misdake/DigitalDesign/modeling/audited/README.md

# Audited numerical modeling

`audited` is a domain-independent fixed-point modeling tool. It has no GPU,
processor, compiler, hardware-framework or board dependency. IP models depend
on this crate; this crate never depends on an IP or a final system.

## Data boundary

`Fixed<B,F,S>` has compile-time literals but no runtime constructor, raw getter,
native arithmetic or division. Checked external integers enter an Input store
before a frame starts. Runtime values come from audited operations and typed
memory reads. Dynamic addresses and predicates preserve value provenance.
`finish()` consumes the frame before exposing host observations; `audit()`
independently replays values, control, memory and resource counts.

Numerical mode (`Model::numerical`, `compute`) records work and payload I/O
without hardware capacities or cycle estimates. Scheduled mode additionally
binds declared resources and uses an ASAP dependency schedule. Neither an audit
nor an ASAP result proves algorithm accuracy, a static RTL pipeline, area or fmax.

Products record both logical operand widths and physical lowering. Narrow
products use DSP18, wide-by-narrow products use two DSP18 operations plus a wide
reassembly adder, and wide products use DSP36. A 9-bit product is a logical
DSP18 operation; explicit target packing is checked separately. Rounding includes its
guard and increment adder. Variable right shifts truncate; RNE must be explicit.
`resize_exact` checks a contract and never implements saturation.

`floor_to` explicitly records static arithmetic rescaling and checked narrowing;
negative values round toward minus infinity. `half_up_to` records the same floor,
a static guard-bit slice and a narrow add; ties go toward positive infinity.
Neither substitutes for `round_to` (nearest-even). `Operand::format()` exposes
type metadata only, never runtime data or provenance.

## Source ownership

| File | Responsibility |
| --- | --- |
| `src/lib.rs` | Closed types, formats, faults and resource declarations |
| `src/arithmetic.rs` | Audited numerical operations and product lowering |
| `src/model.rs` | Stores, event ledger, external inputs and independent audit |
| `src/scheduling.rs` | Optional resource scheduling and timing checks |
| `src/physical.rs` | Fused provenance, DSP topology, banks, replicas, ports and collision certificates |
| `src/lifecycle.rs` | Width-weighted retained values and periodic overlap |
| `src/flow.rs` | Bounded context leases, FIFO credits, CE and ordered commit |
| `src/tests.rs` | Framework semantic and tamper regressions |
| `examples/support/triangle.rs` | Bounded mathematical driver, outside private internals |

## Validation

```powershell
& scripts/run-cargo.ps1 -Subcommand test -Label audited -CargoArgs @('-p','audited')
& scripts/run-cargo.ps1 -Subcommand run -Label audited-driver -CargoArgs @('-p','audited','--example','audited_triangle','--','target/audited/driver')
```

The triangle example is a framework regression, not a triangle setup algorithm.
All frames have event limits; scheduled frames additionally have cycle limits.

## Explicit physical and state certificates

These modules consume finished reports without exposing a runtime `Fixed`
constructor. The numerical ledger stays immutable and independently replayable.
IP adapters supply a placement and timing certificate; checks recompute legality
rather than accepting an optimizer's resource counters.

`physical::FusedGroup` currently certifies exactly `(A0*B0+A1*B1)+C` with signed
18-bit-or-smaller operands, common product fraction and a signed 54-bit-or-smaller
accumulator/result. Absorbed intermediates may not escape. Bound dependencies
preserve external operands and every control gate; a certificate with different
operands, overlapping groups or an internal escape is rejected.

`physical::LogicCone` certifies a pure-logic subgraph reachable from its declared results,
at most 64 total member events, an explicit width cap and a positive result latency.
Its sorted external operands and every control gate are preserved. Multipliers,
memory, publication and control effects cannot be absorbed; internal values must
not escape unless their event IDs are explicitly listed in `exported_events`.
Exports must be unique absorbed events; the root cannot be listed again. All
results share one ready edge, and disconnected unexported work is rejected.
Absorbed events become zero-time aliases at the result-ready edge.
`composed_dependencies`, the composed memory audits and
`lifecycle::analyze_composed_policy` combine these cones with DSP fusion, reject
overlap and account for each exported result's retained storage. Every original
numerical operation remains in the independently replayed ledger. This is a
declared circuit boundary; its width and latency do not prove a clock frequency
or its physical adder count. An IP must declare cone lanes and validate timing
through synthesis before treating the estimate as hardware evidence.

`physical::lowering::WiringAdd::prove(report, event)` binds an existing Add to
field wiring only when conservative possible-one masks do not overlap. Facts
come from full types, Literal nodes, slices, exact resizes, constant shifts and
already provable disjoint additions. All ranges must fit the result, including
sign extension and fractional alignment. Input samples never narrow a domain.
For example, two 8-bit fields placed at bits 0 and 7 overlap even when a sample
does not carry; placing them at bits 0 and 8 can be certified.

`physical::lowering::Equality::prove(report, event)` recognizes the closed
`(a < b) + (b < a) < literal(1)` graph. Operand types must match completely,
predicate/sum formats must prove the sum domain [0,1], and internal results must
not escape. Equal Literal nodes may have different value IDs; equal sampled
runtime values may not. `EqualityKind::ReduceNor` marks a same-format literal-zero
comparison; otherwise it is a bit equality comparator.

Construct `physical::lowering::Plan { wiring_adds, equalities }` and call
`resources(report)` or `counts(report)` for independently recomputed physical
work. Wiring Adds consume no adder; each equality consumes one `Compare(width)`
(also the conservative budget for NOR). Other hardware operations remain charged,
and overlapping certificates fail. The numerical report and its original counters
stay intact. `logic_cones(report, latency)` exposes equalities to the existing
composed memory/dependency/lifecycle APIs. `audit_timing` checks these dependencies
and zero-latency wiring, but does not enforce resource lanes or prove fmax; the
IP scheduler must enforce the returned resource work separately.

```rust
use audited::physical::lowering::{Equality, Plan, WiringAdd};
// report is a finished, valid numerical report; IDs identify existing events.
let plan = Plan {
    wiring_adds: vec![WiringAdd::prove(&report, packing_add_event)?],
    equalities: vec![Equality::prove(&report, equality_event)?],
};
let physical_work = plan.resources(&report)?;
let equality_cones = plan.logic_cones(&report, 1)?;
// Schedule physical_work and compose equality_cones with existing DSP bindings.
```

This does not add automatic RTL generation or multi-output regions. A retained
comparison output still prevents absorbing that comparison. Multi-output regions
need explicit retained values, output timing and lifetime accounting; callers
must not hide escapes by deleting numerical events or duplicating cones.

Shared logic can instead be split at retained values. `LogicCone::singleton`
declares one charged pure-logic event, derives its exact external operands and
width, and absorbs nothing. For LOD `h = 19 - clz`, `shift = 19 - h`, with another
consumer of `h`, use two distinct singleton cones:

```rust
use audited::physical::{LogicCone, logic_dependencies, audit_logic_dependencies};
let mut cones = plan.logic_cones(&report, 1)?;
cones.push(LogicCone::singleton(&report, h_event, 1)?);
cones.push(LogicCone::singleton(&report, shift_event, 1)?);
let dependencies = logic_dependencies(&report, &cones)?;
// Schedule all events using dependencies and plan.resources(&report).
audit_logic_dependencies(&report, &times, &cones, max_cycle)?;
plan.audit_timing(&report, &times, 1, max_cycle)?;
```

Both 18-bit subtractors remain charged once. From the CLZ result, `h` has one
declared subtractor latency and `shift` has two; this split provides no latency
reduction. Each output keeps its own readiness and downstream dependencies.
`lifecycle::analyze_composed_policy` accepts these cones unchanged and retains
both values, including uses outside the split and publications through commit.
Do not pass them as absorbed values or exclude publications to reduce storage.
Disjoint wiring proofs still have zero latency outside the singleton cones;
real adders, comparators and variable shifts retain their work and latency.
Singletons reject wiring-only events, DSPs, memory reads/writes and invalid
numerical frames. Existing overlap, control, cycle, width and escape checks
still apply. Resource lanes, register budgets and target latency remain the
caller's responsibilities; this is not a physical timing or area measurement.

`DspInventory` describes two macros per tile. A macro holds four 9x9 lanes,
two 18x18 lanes or one paired/ALU/MAC mode; different kinds cannot share it.
A 36x36 instance owns both macros of its tile. Independent pre-add and ALU modes
also reserve their sites. `audit_issues` checks widths, fixed result latency and
unit II, including wraparound and a solitary operation's next-iteration conflict.
The half-slot inventory counts actual multiplier work; macro/tile occupancy also
captures unused slots and standalone ALU/pre-add reservations. This is a
conservative target policy, not synthesis, pin routing or fmax evidence.

`MemoryLayout` maps every ROM/RAM to copies of row/bit slices. Logical bits must
be covered exactly, physical regions fit capacity, and RAM owns whole rows
(arbitrary write masks are not assumed). Each access chooses a copy and a port
per slice; a RAM write must reach every replica. Shared RW ports share their II.
ReadFirst/WriteFirst requires the same-edge observation to agree with numerical
frame order, and two same-address writes are forbidden. Logical hazards include
all earlier reads even when independent reads change order. Effects happen at
the issue edge; declared latency delays the result/acknowledgment.
BSRAM requires registered reads; SSRAM permits asynchronous zero-cycle reads.
`audit_gowin_budget` checks supported BSRAM primitive geometries and counts
SSRAM RAM16 composition. Periodic access auditing accepts read-only bodies;
mutable iterations need a future stateful numerical replay. Representative
dynamic addresses do not prove conflict freedom for every possible address.

`lifecycle::analyze_bound_policy` counts half-open live intervals by bit width,
including overlap of repeated pixels. Wiring aliases share producer storage,
literals and fusion metadata do not allocate retained results. Input rows are
captured at body time zero even when their read events are later. Selected output
ports are held through commit; diagnostic goldens can be excluded explicitly.
Context inputs marked invariant count once across the periodic stream. Total
and optional per-width budgets are enforced. This report excludes DSP internal
pipeline registers, routing/mux registers, RAM cells and FIFO/control state;
it is not the design's total FF count or a register-allocation proof.

`flow::FlowMachine` models control tokens with bounded IDs/epochs and explicit
payload-bit accounting. A tick completes a token, commits a complete FIFO head,
loads an unused context bank, then accepts a token at its issue phase. Tokens
hold a context reference until commit; stale leases and exhausted credits fail
atomically. CE=0 freezes all modeled state and phase. A maximum wall-tick count
also bounds indefinitely stalled runs. `FlowTrace::audit` replays this control
transition model; it does not execute numerical payloads or provide an independent
arithmetic oracle. Uniform values, datapath stalls and payload queues still need
an IP-specific cycle executor.

The public physical/lifecycle/flow acceptance tests live in
`ip/gpu-v2/tests/host/physical.rs`, with composed logic certificates in
`ip/gpu-v2/tests/host/logic_cones.rs`. This milestone runs `cargo test -p gpu-v2` only.

## Experience from the GPU components

The closed numerical ledger is effective at exposing hidden host arithmetic:
the frontend now derives its DMA/vertex addresses and assembles its 96-bit packets
in component-owned frames. Stage goldens remain independent; successful audit
does not prove the algorithm matches the intended equations.

Physical and state certificates are necessary alongside that ledger. Mode
packing, memory replicas/shared ports, same-address hazards, CE/context leases,
publication and retained-value accounting are implemented. They prevent many
optimistic schedules, but they still describe a declared target model. Cone
latency is not measured timing. The lighting review found a reconvergent
five-adder path misclassified as four levels: its IP adapter now independently
checks the longest primitive path when generating and auditing certificates.

The [lighting study](../../ip/gpu-v2/docs/fragment-math.md#lighting-factors) and
[frontend study](../../ip/gpu-v2/docs/geometry.md) demonstrate why increasing a
resource can have no throughput benefit: dependency chains or memory bandwidth
may dominate. Bounded list-priority/modulo search and ALAP are useful experiments;
their candidates must pass the independent physical/lifetime checks. The result
is a legal candidate, not a proof of optimality or an implemented acceptance rate.

Before large mutable BSRAM/SSRAM designs, the next required layer is a bounded
numerical cycle executor: replay actual state, dynamic addresses, collision
observations and CE/backpressure across iterations. Current periodic memory
certificates are read-only. Payload FIFOs, hardware register allocation, DSP
internal stages, mux/control/ROM costs and RTL-derived timing remain separate
work. New resource aliases or signed/mode restrictions belong in the physical
target policy and need tamper regressions, rather than loosening the numerical
value constructor. Runtime-format/WASM support is still unimplemented.
