misdake/DigitalDesign/ip/gpu-v2/README.md

# GPU v2 IP

Reusable GPU components live here. The `gpu-v2` crate depends on the generic
[`audited`](../../modeling/audited/README.md) modeling tool and has no CPU or
board-system dependency. The earlier standalone cmodel remains under the Tang
Nano system as a historical development harness; new components belong here.

See [architecture](docs/architecture.md) for component ownership and the model
directions, [lighting](docs/lighting.md) for the numerical models, independent
cycle emulator, synthesizable RTL and matched isolated PnR evidence, and
[frontend](docs/frontend.md) for the bounded Rust frontend models.
Lighting provides explicit Fast/Compact resource profiles with scalar H
normalization, fixed DSP roles and checked synchronous retained storage.
Additional system candidates compare scalar N/H, direct squares and a complete
ID FIFO at II2/II4; their area and numerical limitations are recorded together.
The [interactive WASM review](web/README.md) compares the real Rust kernels with
shared scene inputs and optional error maps.
The [triangle setup oracle](docs/triangle.md) is complete only through its first
Rust step; counted/timed and hardware directions remain future work.
The [texture models](docs/texture.md) implement oracle/counting and universal
periodic preparation connected to bounded cache/color and cycle-MC execution.
Independent numerical cycle emulation, RTL and fitted area remain future work.
The [framebuffer model](docs/framebuffer.md) provides a materialized depth/blend
oracle and bounded serial/overlapped control through the common burst port.
Its arithmetic latency is a fixture assumption; counted arithmetic and RTL
remain future work.
The [controlled pixel composition](docs/pixel-system.md) connects global16
basic/light/sample stores, ordered join and exact final to the existing double
output/ROP and actual serial cycle MC. Its branch results are external reference
stimulus; actual streaming branch execution remains future work.
The [SDRAM memory controller combination](docs/sdram-memory-controller.md) is
provided by the Gowin vendor crate through a dev dependency. Its Rust oracle
supports real data, calibrated average service and configured CPU/display loads.
The independent [scheduler](../../modeling/scheduler/README.md) supports bounded
batch planning. Target specifications and ongoing experiments remain in the local
GPU v2 design documents until their contracts have been implemented and verified.

```powershell
& scripts/run-cargo.ps1 -Subcommand test -Label gpu-v2 -CargoArgs @('-p','gpu-v2')
& scripts/run-cargo.ps1 -Subcommand clippy -Label gpu-v2-lint -CargoArgs @('-p','gpu-v2','--all-targets','--','-D','warnings')
```
