misdake/DigitalDesign/systems/cpu-v3-tang-nano-20k/tools/gpu_profiler/README.md

# GPU profiler

Read-only RTL capture, frozen pre-submit memory snapshots, bounded cold replay
and a self-contained offline viewer. Python uses the standard library. Node is needed for viewer
regressions; Icarus and the Gowin simulation library are needed only for RTL capture.
Production GPU/CPU datapaths and Device4 ABI are unchanged. The formal renderer
owns its optional software capture lease and read bridges.

The [capture bridge](/systems/cpu-v3-tang-nano-20k/docs/gpu-capture.md) owns
resource freezing, publication and the sole later submission. The separate
[board diagnostic](/systems/cpu-v3-tang-nano-20k/examples/gpu_profiler_board/README.md)
owns the button gate and TX-only transport. Remaining qualification and future
extensions are listed in [TODO.md](TODO.md).

## Commands

Run from the repository root:

```powershell
python systems/cpu-v3-tang-nano-20k/tools/gpu_profiler/profiler.py check --node node
python systems/cpu-v3-tang-nano-20k/tools/gpu_profiler/profiler.py build systems/cpu-v3-tang-nano-20k/tools/gpu_profiler/tests/fixtures/pingpong --out target/profiler-example
python systems/cpu-v3-tang-nano-20k/tools/gpu_profiler/profiler.py render path/to/profile.json --out target/profiler-view
python systems/cpu-v3-tang-nano-20k/tools/gpu_profiler/profiler.py capture path/to/manifest.json --out target/profiler-capture
python systems/cpu-v3-tang-nano-20k/tools/gpu_profiler/profiler.py build target/profiler-capture
```

Open the output directory's `profiler.html`. It embeds the data and works without
a server. The JSON and submission/command/meshlet/CPU CSVs retain integer cycles.
`render` accepts schema v2 or converts the earlier single-frame v1 JSON; it does
not need the old frozen RTL folder. Unsupported versions and invalid references
are rejected. `build --allow-partial` is diagnostic and visibly marks incomplete
captures; ordinary `build` requires a complete capture.

The small source fixture is **synthetic**, exercises A/B/A address reuse,
backend retirement tails and CPU overlap, and is not a performance measurement.
`check` runs bounded Python format/correlation and Node math/interaction tests.
No command creates ZIP archives, flashes hardware, commits or pushes.

## Frozen inputs and cold replay

`snapshot_cli.py build-manifest spec.json --out build.json` creates a content
declaration from an explicit source/export/options/catalog list. Header/range
indices are read from the single driver-owned `rcc/gpu_capture_abi.rs`; they are
not duplicated in Python. Build IDs bind logical file names, lengths and hashes;
file locations can be relocated without changing content identity.

```powershell
python systems/cpu-v3-tang-nano-20k/tools/gpu_profiler/snapshot_cli.py receive --port COM4 --seconds 180 --out target/snapshot-receive
python systems/cpu-v3-tang-nano-20k/tools/gpu_profiler/snapshot_cli.py decode path/to/uart.bin --out target/snapshot-decoded
python systems/cpu-v3-tang-nano-20k/tools/gpu_profiler/snapshot_cli.py preflight path/to/complete-attempt --build build.json --receipt receipt.json --out target/preflight.json
python systems/cpu-v3-tang-nano-20k/tools/gpu_profiler/replay.py path/to/complete-attempt --rtl path/to/fresh-export --build build.json --receipt receipt.json --out target/replay --max-cycles 2000000 --timeout 1800
python systems/cpu-v3-tang-nano-20k/tools/gpu_profiler/compare.py previous-attempt next-attempt --replay target/replay --out target/comparison.json
python systems/cpu-v3-tang-nano-20k/tools/gpu_profiler/qualify.py target/bound-board-run --out target/bound-board-run/qualification.json
```

Every attempt is independent. The decoder preserves an error report for a
truncated/corrupt attempt and can accept a subsequent complete retry; it never
combines their chunks. A complete attempt materializes `snapshot.json` and flat
`range-NNN.bin` files with lengths, CRC32 and SHA256. Replay reloads and checks
those files rather than trusting cached JSON. Command padding, objects, actual
UI, every catalog allocation, color/depth preimages and old Front must be present.
Version1 captures preimages even when the CB declares full CLEAR.

The header ID is a declaration, not a hardware self-attestation. A separate
verified programming receipt binds actual firmware and bitstream bytes. Missing
files, changed identities, unsafe filenames, inconsistent aliases or incompatible
ABIs refuse replay. The physical initialized-read guard checks every accepted
read offer, through both ordinary `take` and `read_chain_accept`, against captured
bytes or an earlier replay write. Both paths use the same address/byte-mask check.
The bounded native-MC regression exercises two128-byte GPU RO bursts, verifies
actual READ continuation and both payloads, and rejects an uncaptured successor:

```powershell
python systems/cpu-v3-tang-nano-20k/tools/gpu_profiler/tests/read_chain_guard.py --peer path/to/fresh-export/peer --out path/to/new-test-output
```

Storage layout is independent of the unchanged GPS1 wire v1, 64-word header,
range v1 and native command ABI1. Header indices remain driver-owned.
Only `(layout,command)=(1,1)` and `(2,1)` are supported. Build v2 requires a
top-level `command_abi:1`; paused RTT `(2,2)` is rejected, even when an old ABI
constants file declares command2.

| Storage | Header layout ABI | Logical pixels | Physical plane | Allocation policy |
| --- | ---: | ---: | ---: | --- |
| Row16x16, macro pitch25 | 1 | 96000 | 192000 bytes | Legacy captured extent |
| Column16x16, padded macro height16 | 2 | 96000 | 204800 bytes | 262144 bytes reserved; tail capture explicit |

Column addressing is `base + 512*((x>>4)*16+(y>>4)) + 32*(y&15) + 2*(x&15)`.
The 6400 padding words occupy the last macro row of every column; they are not a
contiguous tail. The extra57344 allocation bytes are a separate guard outside the
physical plane. Full CLEAR initializes204800 bytes, never that guard. Build v2
binds an exact layout description, the column memory map and typed resources.
Ordinary POT textures declare column macro packing with minimum512-byte mips and
16x8 cache lines. UI grid/glyph encoding is unchanged. Row build v1, descriptor
representation, input hashes and decoding remain compatible; use the archived
`--abi` source if the authoritative constants changed since capture. Old evidence
is never relabeled.

Physical plane preimages are mandatory. Build option
`capture_allocation_guards: true` additionally requires the full allocation tails;
otherwise they are not fabricated or implicitly compared. Referenced bytes must
still be captured. A FULL_CLEAR range extending into a guard is rejected. Native
writes are checked against captured writable byte masks, alongside initialized
read guards. Reports distinguish visible pixels, physical padding words and
captured guard bytes; equality includes every compared region. Physical-only
replay explicitly reports zero compared guard bytes.

New RTL exports include `layout.json` (`schema:1`, `layout_abi`, `gpu_profile`).
The exporter checks the actual generated framebuffer/texture structure, not just
an environment label. Replay rejects unknown/mixed layouts, a row texture path
with a column target, or an unbound layout declaration. Missing layout metadata
is accepted only for archived row exports. This is a structural sanity gate;
actual source hashes remain bound to build/firmware identity.

The private diagnostic preparation command accepts `--column-catalog` for a
CPU-produced directory containing `assets.json`, `renderer_assets.rs` and its
referenced resources. `assets.json.capture_layout` must match the versioned
descriptor. Entries retain `file,address,bytes,sha256` and add `kind` (`mesh`,
`texture`, `atlas`, `other`); textures also declare `layout`. Preparation checks
hashes/bounds and copies bytes; it never converts row textures. Firmware rebuilds
restore that same build-bound catalog through the existing boot-assets route.
The formal CPU producer supports both row and column profiles. The selected
catalog, capture header, replay export and qualified hardware must agree;
offline producer support alone does not qualify physical buttons or board timing.

The MC export preserves a `peer/stream-contract.json` and its original source
names. Replay validates the fixed stream profile and every peer source against
that manifest; removed bridge-parameter text is not an identity check. Old
exports without that contract are rejected rather than silently substituted.

Cold replay uses the production GPU, arbiter, streaming endpoint, registered
CL3 native return and SDRAM controller. It has explicit cycle/wall limits and
isolated, hash-checked exports. It includes no CPU/Display requests and restores
no internal warm cache, FF or BSRAM contents. The pin model has explicit functional
timing assumptions; it is not board/PVT qualification. `color.bin`/`depth.bin`
are authoritative native output; `color.png` is a viewing aid.
`*-allocation.bin` contains exactly the declared comparison extent;
`replay.json.captured_plane_bytes` distinguishes physical-only and guarded capture.
Guard writes fail rather than being hidden as off-screen data.

Offline `tests/layout_replay.py` takes explicit `--row-rtl`, `--frozen-column`,
`--column-contract` and fresh `--out` paths. It binds the frozen GPU SHA to its
contract and stages it beside the current validated CL3 peer, without changing
production sources. Default NOP preserves independently enumerated pixel patterns.
`--clear` exercises target installation/full-plane CLEAR only; `--physical-only`
omits unreferenced allocation tails. `--missing-read` and `--forbidden-write` are
guarded negatives. Bounds are180000 cycles and180 seconds. These no-triangle
fixtures and the original frozen49.5/99 CL2 scene result do not establish new
54/108 board or producer qualification.

`tests/producer_handoff.py` consumes an archived committed producer fixture with
`--fixture`, `--producer-receipt`, `--producer-commit`, `--rtl` and fresh
`--out`. Current row and column inputs use the matching canonical export directly.
The old `--row-rtl` spelling remains an alias. Only legacy column staging from a
row export requires explicit `--frozen-column`/`--column-contract`; incomplete or
ambiguous replacement requests are rejected.
It checks archived file and build hashes, the real header/ranges, catalog byte
closure and actual column origin. The generated wire is labeled host-encoded,
not UART. Its default independent oracle handles the supplied CLEAR plus fixed-grid UI
caller, including odd-row glyph packing, untouched depth and physical padding;
this default rejects DRAW. `--expect-fault
missing-read|forbidden-write` poisons a simulation mask without changing producer
bytes. Limits remain180000 cycles/180seconds. No verified programming receipt or
combined CPU/GPU source build is implied by this offline handoff check.

Both the earlier single-fixture receipt and the CPU-owned
`digitaldesign.cpu-capture-draw-delivery` v1 archive are accepted. The latter
retains one build/program per profile and `frame-0..2` occurrences; it is not
repacked into a fabricated legacy receipt. The consumer verifies every sealed
evidence file, program/build commit and digest, per-occurrence command/object
views, token/publication/slot/address, resource bytes and actual layout origin.
The producer's `observed` projection/sanity fields are not oracle inputs.

With `--oracle draw`, the same producer/input identity checks precede an independent
color/depth reference. It decodes the actual native commands, matrix, packed
meshlet and uniform color. Exact integer cross products and rational perspective
weights replace the hardware coefficient reduction/reciprocal algorithm. Depth
is camera Z in Q8.8, not far-normalized depth. ROP color uses nearest RGB565.
This deliberately restricted small-fixture path accepts at most eight triangles,
positive-Z vertices, opaque unlit shading, no blending, LESS/ALWAYS depth test
with writes, RGB attributes or a no-mip constant texture. Filtered UV is restricted
to white1x1 at zero UV. UI, lighting, clipping and unsupported sampling reject.
Both plane CLEARs must precede DRAW; overlapping depths and far-plane distances
within two D16 codes reject as ambiguous. At least256 stable covered pixels are
required, so an empty output cannot pass the DRAW handoff check.

One-pixel L-infinity bands about ideal triangle edges are excluded and counted
explicitly. All other background pixels compare exactly. Stable drawn pixels
use a declared default depth budget of two Q8.8 codes and exact RGB565; options
can tighten depth to zero or allow one RGB565 channel code for varying RGB.
Reports retain mismatch coordinates and maximum errors. These budgets describe
an independent mathematical comparison, not bit-exact RTL equivalence.
`--include-edges` compares all96000 logical pixels with no edge exclusion.
Reports distinguish the original ideal edge band from the number actually
excluded and compared. With an explicit depth CLEAR of0xffff, full-image mode
also checks exact coverage: every supported live depth is below far<200 and
therefore below0xffff. Background remains exact; the declared depth budget
only applies to mathematically covered pixels. The sequence runner accepts the
same option. A stable-region pass never silently becomes a full-image pass.

`tests/producer_sequence.py` takes three `--fixture` arguments and the same
producer/export options. It requires natural CB address A/B/A reuse, distinct
tokens/submissions and at least256 changed stable DRAW pixels on the reused
address, beyond differences attributable only to CLEAR. It independently
cold-replays each exact frozen occurrence. It does
not infer warm queue behavior or CPU/Display concurrency from isolated resets.
`tests/draw_replay.py` provides a bounded synthetic DRAW check of this plumbing,
with explicit `--layout row|column`, export options and fresh `--out` directory.
Synthetic input success never establishes real CPU producer or physical-button
qualification. Put outputs under the approved external experiment directory.

### Complete frozen scene

`tests/full_scene_replay.py` consumes the CPU-owned
`digitaldesign.cpu-capture-full-scene-delivery` v1 envelope, whose profiles live
under `full-scene/default|column16/frame-0..2`. The consumer verifies its sealed
program/build, commands, objects, UI and all range bytes without rewriting the
producer archive or using its `observed` sanity/projection fields as answers.
The same explicit export options as the single-DRAW runner apply. Cycle and
wall limits default to2000000 and1800seconds; both are explicit manifest fields
and may be overridden within replay's existing bounds.

The independent NumPy reference decodes every native DMA/state/DRAW/UI command
in order. It performs the documented Vertex output-window/normal quantization,
then direct float64 ray/triangle intersections and perspective attributes. It
does not read RTL, control ROM, T's reduced coefficients, R's traversal answers,
I's reciprocal table or CPU-provided projections. Textures come only from
captured RGB565 bytes: row8x8 or column16x16 macros and their actual mip padding.
Sampling uses the documented integer tap/Color quantizers; Lighting uses ideal
normalization and Blinn-Phong with each current global context. Final, ROP
packing and UI's binary-alpha glyph writes are independently evaluated.

This runner requires24 DRAWs:192 box triangles in six textured/unlit meshlets,
one RGB triangle,948 rabbit triangles in17 lit meshlets, and nonempty frame-time
UI. It independently checks the actual GPU trace for24 DRAW/start and VT/end
events, all command executions, UI, substantial T/quad work and completed drain.
Thus a parsed manifest, single DRAW or empty run cannot satisfy this contract.

Reports separately count full-image coverage, exact UI and nonboundary color
and depth. One-pixel ideal edge bands and two-code depth ties are marked using
the independent geometry, never DUT primitive ownership. Coverage/depth/color
deviations in excluded regions are still counted and sampled. Stable depth's
budget is two Q8.8 codes; unlit RGB permits one RGB565 channel code (whose bit
expansion can differ by nine RGB8 units). Texture and ideal-light comparison
budgets are24 and16 RGB8 units maximum, with mean at most two; these are
approximation checks, not bit-exact Lighting or arbitrary-scene guarantees.
Background and UI color remain exact. Minimum checked texture/RGB/lit pixel
counts reject vacuous comparisons. The original/actual/reference images and
counts remain available even when a budget fails.

NumPy is required only for this complete-scene path and its separate opt-in
`tests/scene_oracle_checks.py`; the basic profiler format/viewer checks remain
stdlib-only. Native GPU/MC runs still require Icarus and the existing Gowin
primitive library. Frozen CPU producer input, cold GPU execution, warm queue
concurrency, physical buttons and board qualification remain separate evidence.

The next frozen lease can expose the previous submission's actual output in its
confirmed old Front and depth preimage. `compare.py` checks adjacency, addresses,
formats, input identity and both complete output planes. An equal memory image
does not certify the HDMI link or infer whole-board GPU timing.

`qualify.py` summarizes the diagnostic run's two repeated frozen dumps, adjacent
output comparison and exact independent wire-encoder check. It reports the
accepted-START-to-drained interval separately from observed CLEAR command time.
Subtracting those intervals is accounting on that run, not a separate no-clear
render. Arrival-offset CSV records support per-attempt transfer measurements;
board dump milliseconds end when END is assembled, before its final bytes finish.

## Capture a harness

Place `// GPU_PROFILER_OBSERVER` once inside the testbench module. Supply an
explicit manifest; paths are relative to the manifest or absolute:

```json
{
  "version": 1,
  "title": "My scene",
  "clock_hz": 54000000,
  "top": "tb",
  "testbench": "tb.v",
  "sources": ["gpu-export.v", "prim_sim.v"],
  "inputs": {"program.hex": "program.hex", "assets.hex": "assets.hex"},
  "bindings": {"GPU": "gpu", "CLOCK": "clk", "RESET": "reset", "ENABLE": "ce", "CYCLE": "cycle"},
  "max_cycles": 2000000,
  "timeout_seconds": 60,
  "submissions": 3,
  "submission_labels": {
    "1": {"frame_id": 1, "name": "A"},
    "2": {"frame_id": 2, "name": "B"},
    "3": {"frame_id": 3, "name": "A reused"}
  }
}
```

List all exported source files and primitives. Source entries may instead be
`{"path": "...", "sha256": "..."}` to require a frozen identity. Every source
basename and input filename must be unique. Generated capture filenames
(`profiler_tb.v`, `capture.json`, `capture.vvp`, `compile.log`, `run.log`,
`events.txt`, `load.csv`) are reserved and rejected for sources and inputs.
Use relative filenames in testbench
`$readmemh` calls. The runner copies a snapshot into a new/empty output directory,
records source/input/observer hashes, compiles and runs there, and enforces both
cycle and wall limits. It stops after the requested number of fully drained GPU
submissions, or records a bounded incomplete stop. `--compile-only` only prepares
and compiles the snapshot. `IVERILOG_EXE` and `VVP_EXE` override executable names.

The observer binds the current GPU's hierarchy and physical T/quad/ROP ownership.
It never writes DUT state. Device4 accepted SENDs are observed independently of
CE. It does not assume a scene, meshlet count, CB base or first-completion stop.
The capture contains one monotonic counter domain; a reset during capture is
rejected and requires a new session.

Optional harness-side CPU annotations use:

```verilog
profiler_cpu_begin(17, 2, "Record next frame"); // span ID, logical frame ID, label
// CPU executes while the previous GPU submission is active.
profiler_cpu_end(17);
```

Call these on a stable testbench phase, such as the falling edge, or adapt existing
software marker observations to these tasks. IDs must be unique per session.
Labels are at most 96 bytes. CPU spans need not coincide with GPU submission
boundaries. A span still open at the explicit capture end is cropped and marked;
this permits recording frame N+1 while the last captured GPU frame N completes.
Logical frame IDs are annotations: multiple CB submissions may belong to one
frame, and a prepared frame may not yet have submitted.

## Production-GPU smoke test

This creates a fresh export, so it has no archived `target` prerequisites:

```powershell
cargo run --release -p cpu-v3-tang-nano-20k --example gpu_profiler_export -- target/profiler-rtl
python systems/cpu-v3-tang-nano-20k/tools/gpu_profiler/tests/rtl_smoke.py --rtl target/profiler-rtl --out target/profiler-smoke
```

Set `GOWIN_HOME`, or pass `--primitive path/to/prim_sim.v`. The real production GPU
executes three minimal streams A/B/A with CE0 launches and a backpressured memory
peer. CPU markers demonstrate annotation overlap; the harness does not simulate a
CPU or measure CPU performance. The limits are 20,000 cycles and 30 seconds.
The synthetic fixture additionally exercises meshlet/quad ownership and final
cache commit. These checks do not replace rendering or board validation.

## Viewer

The top overview shows green VT ownership and orange pixel-backend activity.
Backend is the per-cycle OR of raster busy, interpolator live returns, allocated
quads and ROP cache contexts, formed before time binning. Both bands include waits
and are independent of type filtering. Later dirty FLUSH maintenance has its own
detailed metric.

- Overview left-drag selects a range; drag its interior to move or edges to resize.
  Double-click outside it, right-click, or Fit session to clear. Right-drag moves.
- Wheel scrolls rows; Ctrl+wheel zooms around the pointer. Middle/right drag or
  Shift+left drag pans time and the current pane's rows.
- Types opens a collapsed popup beside Fit session; WAIT/DMA start hidden.
- Command labels show `CB ID · PC`; hover labels for that occurrence's details.
  Hover the time plot for all alive occurrences, including filtered types.
- Click selects; double-click or Focus selection zooms to its DMA/backend bounds.
- CPU spans and GPU submission intervals share the same time axis. Selection,
  dependency arrows, CSVs and ownership use occurrence IDs, never PC alone.
- Load hover reports the plotted time bin, busy fraction, queue mean/peak or event
  count/rate. Mouse controls (?) lists the principal interactions.

The versioned contract is in the
[system profiler specification](/systems/cpu-v3-tang-nano-20k/docs/gpu-profiler.md).
