misdake/DigitalDesign/systems/cpu-v3-tang-nano-20k/examples/frame_stats/docs/README.md

# Frame statistics documentation

- [Components](/systems/cpu-v3-tang-nano-20k/examples/frame_stats/docs/components.md): completed frame intervals and character formatting.
