misdake/DigitalDesign/systems/cpu-v3-tang-nano-20k/docs/cpu-v3-optimization-record.md

# CPU V3 optimization detail record

Status: append-only detail record; normally read only when investigating an old decision
Repository: `../../../`
Updated: 2026-10-09

The CPU V3 benchmark suite and runners referenced below were retired on
2026-10-24. These entries preserve historical evidence; their benchmark commands
are no longer active validation entry points.

The concise milestone index lives in [`cpu-v3-optimization.md`](cpu-v3-optimization.md). This file
preserves the former long-form roadmap, measurements, rejected alternatives, and validation notes.
New milestones add one sentence to the concise index and append their detailed evidence here; old
entries are not rewritten except to correct a factual error with an explicit superseding note.

This roadmap lives inside the CPU V3 system crate so it stays with the system it describes; it is
maintained and committed together with each milestone. Benchmark workloads and runners live in the
system crate; generated per-stage CSV and presentation artifacts remain local unless explicitly
selected for the repository. Historical numbers below record the exact release-mode emulator runs
described by each Stage.

## Milestone workflow and document lifecycle

- Keep this document permanently as the optimization history and current-state handoff.
- Before and after each milestone, update the current implementation state here so another agent can
  resume from the documented repository state.
- Include the updated roadmap in the same commit that completes each milestone.
- Never leave the current architecture, benchmark, validation, PnR, timing, or resource summary stale
  after a CPU V3 optimization.
- Scale validation to the risk of the change. Correctness-focused changes with little timing or
  resource pressure may use a smaller targeted test set, provided the completed milestone records
  what ran and what was intentionally skipped. Changes that affect timing, resource use, memory
  geometry, clocks, or clock-domain crossings still require the corresponding hardware validation.

## Current implementation progress

| Stage | State | Result | PnR evidence at 54 MHz |
| --- | --- | --- | --- |
| 0 | Complete, 2026-08-29 | Removed per-line snoop/invalidate; froze global maintenance and boot-handoff semantics. | 4 BSRAM; 55.435 / 55.958 MHz |
| 1 | Complete, 2026-08-29 | Added private 256-bit refill buffers and complete-line commit. | 4 BSRAM; 57.127 / 62.440 MHz |
| 2 | Complete, 2026-08-29 | Replaced serialized reads with one real `8 x 32-bit` SDRAM burst. | 4 BSRAM; 55.327 / 56.090 MHz |
| 3 | Complete, 2026-08-29 | Split each cache into even/odd BSRAM banks; initialization contents are split by word parity and refill drain is eight cycles. | 6 BSRAM; 54.492 / 54.261 MHz |
| 4 | Complete, 2026-08-29 | Converted both caches to two ways with invalid-way-first deterministic victim replacement. The tag comparison now precedes the data-bank read, so a hit costs one more registered cycle until Stage 5 pipelines it. | 6 BSRAM; 61.425 / 56.530 MHz |
| System consolidation | Complete, 2026-08-30 | Folded the separate CPU V3 boot, SDRAM, and display systems into one fitted `cpu_v3_system`. This changed the full-system baseline to 7 BSRAM before the Stage 5 fetch pipeline work. | Full system: 9,740 Logic; 7 BSRAM; 57.345 MHz |
| 5 | Complete, 2026-08-30 | Pipelined resident cache reads for one accepted lookup per cycle and added a four-entry, epoch-tagged instruction fetch queue. Sequential ALU throughput now approaches two cycles per instruction. | Full system: 9,974 Logic; 7 BSRAM; 61.842 MHz |
| 6 | Complete, 2026-08-30; removed after measurement | Added demand-progress-triggered, low-priority next-line I-cache prefetch with redirect cancellation, discardable in-flight refills, simulation counters, and demand-safe cancellation races; an intermediate one-entry cancel-learning fix was folded into the removal. Later audit showed ~1.5% Logic / ~4.6% FF cost for +0.0003% frozen-suite benefit, so the whole mechanism was deleted again (see the Stage 6 section). | Full system: 10,129 Logic; 7 BSRAM; 54.538 MHz (at introduction) |
| 7 | Complete, 2026-08-30 | Added cycle-profiled emulator benchmarks, a redirect fast path, and an explicit dual-read RAM16 scalar register file. Hot control-transfer fetch waits fell from four cycles to two; the RAM16 register file cut 2,178 LUTs. | Full system: 8,046 Logic; 7 BSRAM; 57.549 MHz |
| 8 | Complete, 2026-08-30 | Split the production I/D caches, added write-allocate D-cache stores, dirty eviction, eight-beat SDRAM line writes, and blocking full-cache clean/invalidate with CPU hold and final status. | Full system: 9,548 Logic; 7 BSRAM; 54.918 MHz |
| 9 | Complete, 2026-08-31 | Added an exact related-clock 54/108 MHz gearbox. Cache/arbiter line traffic is 4 x 64-bit at 54 MHz; the Controller HS and SDRAM side remains 8 x 32-bit at 108 MHz. | Full system: 10,345 Logic; 7 BSRAM; CPU 54.965 MHz |
| 10 | Complete, 2026-08-31 | Replaced XOR/way-interleaved cache storage with two parity-split DPBs per cache. Refill and D-cache write-back now transfer directly as 4 x 64-bit beats without private 256-bit cache buffers. | Full system: 9,977 Logic; 4 DPB + 1 SDPB + 2 pROM; CPU 54.692 MHz |
| 11 | Complete, 2026-09-01 | Added a one-entry asynchronous store. A scalar store retires immediately and its data-port request/response runs in the background, overlapping ALU and other non-memory instructions; later memory operations wait on the single store buffer. | Full system: 10,025 Logic; 4 DPB + 1 SDPB + 2 pROM; CPU 56.51 MHz |
| 12 | Complete, 2026-09-01 | Added a conservative two-stage frontend: single-cycle integer ALU/immediate/control instructions overlap their fetch with the preceding execute, and a registered GPR forwarding path lets back-to-back dependent instructions observe the pending write. Loads, stores with a busy buffer, branches/jumps, devices, multiply, and FPU remain barriers. | Full system: 10,100 Logic; 4 DPB + 1 SDPB + 2 pROM; CPU 56.230 MHz |
| ISA 0.8 migration | Complete, 2026-09-11 | Breaking integer ISA revision (no new numbered Stage): destructive shift/multiply family at major 2, extended/system family at major 6, device access at major 7, symmetric branch/conditional-move/jump family at major B, `IMMHI12` renamed to neutral `PFX12`, `HALT` replaced by `SIGNAL r0, 0`, majors C/E reserved. Encoding, simulators, handwritten RTL, RCC backend, debugger decoding, and boot assets switched at the same boundary. Stage0 is 461 words (fits the 1024-word boot window); integer side keeps one `MULT18X18`. | Full system: 10,436 Logic; 4 DPB + 1 SDPB + 2 pROM; 2 x MULT18X18; CPU 55.597 MHz, zero setup/hold TNS |
| Single-stage boot merge | Complete, 2026-09-12 | Folded the former Stage1 into the BSRAM first stage: one image validates the descriptor and manifest and loads the reset-selected application, so the Stage1 image, the descriptor mirroring, and the duplicate DMA/UART/handoff code disappear. Container format version 4 reserves the former Stage1 descriptor fields; the error ABI uses stage `1` throughout and the boot-progress phases collapse to BOOT/DMA/APPLICATION. A manifest section-count bound closes the 16-bit `count << 5` wrap in the size check. | Merged Stage0 673 words (fits the 1024-word BSRAM boot window). Full system: 10,269 Logic; 4 DPB + 1 SDPB + 2 pROM; 2 x MULT18X18; CPU 54.522 MHz, zero setup/hold TNS |
| `ASR`/`ASRI` signedness fix | Complete, 2026-09-12 | Found on hardware: the display demo's negative sine/cosine offsets landed at +255 instead of -1. The handwritten RTL put `>>>` inside a conditional whose other branches were unsigned, and Verilog makes a `?:` unsigned when any branch is unsigned, so `ASR`/`ASRI` (and therefore the then-current `fix16::to_int()`) shifted logically. The shifts now compute in a statement-based `case` and the FSM selects the result; `fix16_to_int_rcc` co-simulates the conversion. | Full system: 10,232 Logic; 4 DPB + 1 SDPB + 2 pROM; 2 x MULT18X18; CPU 54.747 MHz, zero setup/hold TNS |
| Stage 6 prefetch removal | Complete, 2026-09-12 | Deleted the next-line I-cache prefetch entirely (offset-10 fetch-queue trigger, request/arm/cancel and cancelled-line learning in the I-cache engine, simulation counters) after the cost/benefit audit in the Stage 6 section showed ~4.6% register and ~1.5% Logic cost for +0.0003% frozen-suite benefit. The I-cache module sheds 31 REG / 178 LUT at synthesis; system PnR shifts the rest (unrelated modules move within normal re-optimization noise). Frozen stage-12 suite: +20 cycles out of 6,136,236; prefetch metric columns remain in the CSV schema, pinned to zero. | Full system: 10,321 Logic (4,196 FF); 4 DPB + 1 SDPB + 2 pROM; 2 x MULT18X18; CPU 56.141 MHz, zero setup/hold TNS |
| Cache RAM16 valid/victim + dirty window scan | Complete, 2026-09-12 | Moved both caches' valid and victim bits from flip-flops into a `CpuV3CacheValidRam` RAM16 leaf (asynchronous read, synchronous single-way write), with a one-set-per-cycle clear for global invalidation, reset, and memory-error scrub. The D-cache exposes `valid_sweep` and the system holds the core for the reset/scrub sweep (`sysctl_cpu_hold || valid_sweep`) so the core never sees a not-ready D-cache on its first post-reset access. The two-way hit expression drops its own invalidating gate to restore the tight I-cache way-valid depth. Revision audit: only the victim bit actually inferred RAM16 here, because the valid-array write ports depended on the cache's own read data and on the request handshake; both valid ways stayed as 128 flip-flops plus read multiplexers per cache until the cache valid-array write-port fix recorded below. Replaced the D-cache 128-bit dirty priority encoder with a 16-entry window scan overlapped with the in-flight write-back; the architecture `DataCache` selects lines way-major so the RTL and Rust wrapper stay bit-exact. Frozen-suite cycles unchanged per program (post-halt flush within 3 cycles). | Full system: 9,640 Logic (8,294 LUT, 770 ALU, 96 RAM16); 4,099 FF; 4 DPB + 1 SDPB + 2 pROM; 2 x MULT18X18; CPU 54.222 MHz, zero setup/hold TNS |
| Framebuffer 400x240 | Complete, 2026-09-12 | Widened the CPU framebuffer from 320x240 to 400x240 RGB565, so the 2x-scaled 800x480 mode fills the active window with no side border and the 3x 1280x720 mode leaves 40-pixel borders. The scanout line buffer grows to three 200-word slots (two 18-Kbit BSRAMs) with 10-bit addresses; the slot-base select keeps the address math off a synthesized DSP multiplier. The display demo re-centers on x=200 and uses 8/256 radians per pixel. | Full system: 9,706 Logic (8,354 LUT, 776 ALU, 96 RAM16); 4,098 FF; 5 DPB + 2 SDPB + 1 pROM; 2 x MULT18X18; CPU 56.304 MHz, zero setup/hold TNS |
| Scanout double buffer | Complete, 2026-09-12 | Collapsed the scanout line buffer from three 200-word slots to two. At two slots the producer only requests the bus once the consumer has freed a slot, when exactly one line is buffered, so the display is arbiter-urgent (`ready_count <= 1`) for every request and never round-robins with the CPU; the single line of lead covers SDRAM refresh plus the one in-flight transaction. Two 400-pixel lines are 12800 bits and fit a single 18-Kbit BSRAM (the three-slot 19200 did not). The host model's 0-underflow blackout ceiling drops from ~9900 to ~6400 cycles, so the line-buffer test pins 6000. | Full system: 9,706 Logic (8,361 LUT, 769 ALU, 96 RAM16); 4,088 FF; 5 DPB + 1 SDPB + 1 pROM; 2 x MULT18X18; CPU 54.298 MHz, zero setup/hold TNS |
| Cache valid-array write port | Complete, 2026-09-12 | The valid/victim RAM16 leaf had only ever inferred RAM16 for the victim bit. The D-cache selected the victim write way from the array's own asynchronous read data in `ST_LOOKUP`, and the I-cache put the `memory_request_ready` handshake into the valid write enable; Gowin then mapped the leaf's two valid ways as 128 flip-flops plus read multiplexers in every instance, costing 256 FF and about 840 LUT across the two caches while the 96 system SSRAM cells stayed fully accounted for by tags, the victim bit, and the GPR/FPU files. Both caches now invalidate the victim from the registered `pending_way` as the line request starts, which still precedes the first refill data beat, so no array write depends on that array's read data; each leaf instance infers twelve RAM16 cells with no flip-flops. The `CpuV3CacheValidRam` SSRAM claim becomes twelve cells per instance and the flip-flop dirty bitmap stops claiming SSRAM. The change is RTL-mapping only: no emulator or architecture-model source changed and `system_cosim` re-verifies RTL/model equivalence cycle by cycle, so the frozen-suite cycle counts are unaffected. | Full system: 9,025 Logic (7,585 LUT, 768 ALU, 112 RAM16); 3,834 FF; 5 DPB + 1 SDPB + 1 pROM; 2 x MULT18X18; CPU 55.904 MHz, zero setup/hold TNS |
| Resolved-target BTC | Complete implementation and validation, 2026-09-13; uncommitted, no new Stage | Default four-entry, two-word fully associative BTC with exact LRU, consumption-only fill and same-cycle target replay; optional eight-entry comparison and disabled control. Per-slot current metadata replaces toggled epochs so repeated redirects cannot revive old responses. Same 22 frozen programs and metric schema. See the BTC results below. | Full system, 4 entries: 9,408 Logic (7,872 LUT, 864 ALU, 112 RAM16), 4,103 logic FF, 6,688 CLS, 54.192 MHz, 0.066 ns setup slack. 8 entries: 9,637 Logic (7,968 LUT, 997 ALU, 112 RAM16), 4,340 logic FF, 6,958 CLS, 54.226 MHz, 0.077 ns setup slack. Both: 5 DPB + 1 SDPB + 1 pROM, two MULT18X18, zero setup/hold TNS. |
| FPU v2 S7b packed special path | Complete implementation and validation, 2026-09-20; no new Stage | Recovered the 54 MHz timing failure introduced by RCP/RSQRT without changing fetch behavior. The blocking special path registers its RF operand before normalization and stores each hidden-LUT interval as unsigned 17-bit `current` plus signed 10-bit `delta`, so one synchronous read replaces the former current/next pair. Aligned table bases remove address adders; the interpolator narrows to 10x9 bits; RCP uses a 33-bit saturating scale path while RSQRT uses its bounded non-saturating shift; one context copy replaces per-stage control replication. RCP/RSQRT return to T0..T3 with bit-identical reference results. Special-path synthesis falls from 528 LUT / 64 ALU / 162 FF / 1 DSP to 290 LUT / 17 ALU / 76 FF / 1 DSP. A registered-fetch-cursor probe reached 58.239 MHz / +1.348 ns but delayed redirect continuation, so it was removed after an ablation proved the packed special path closes timing alone; the four-file overlay remains in local stash `codex/fetch-timing-overlay-58.239mhz` for S7c contingency. | Full system: 9,247 Logic (7,621 LUT, 1,146 ALU, 80 RAM16), 4,189 logic FF, 6,756 CLS; 3 SDPB + 4 DPB + 1 pROM; 2 MULT18X18 + 1 MULT36X36 + 1 MULTADDALU18X18; CPU 55.058 MHz, +0.356 ns setup slack, zero setup/hold TNS. |
| FPU v2 S7c modular SINCOS | Complete implementation and validation, 2026-09-20; no new Stage | Added blocking SINCOS without changing fetch. Range reduction now feeds signed Fa and the positive 36-bit Q0.32 constant `K=round((2/pi)*2^32)=0xA2F9836E` into the existing three-stage shared MULT36X36. Taking `(Fa*K)>>>32` is bit-exact to the former `C0/C1` two-term reducer because `K=C0*2^16+C1`; it deletes four partial products, four reused accumulator registers and the serial reducer adder chain without adding a DSP. The local MULT18X18 remains dedicated to packed-LUT interpolation, followed by the result register that cuts the BSRAM -> DSP -> add -> RF path. Mode 00 SINCOS completes in T0..T7; mode 01/10 SIN/COS suppresses the second lookup/write and completes at T6. Dense +/-2pi and full-i32 tests retain 3-LSB maximum error. Special-path synthesis is 375 LUT / 34 ALU / 125 FF / 1 DSP. | Full system: 9,430 Logic (7,786 LUT, 1,164 ALU, 80 RAM16), 4,241 logic FF, 6,847 CLS; 3 SDPB + 4 DPB + 1 pROM; 2 MULT18X18 + 1 MULT36X36 + 1 MULTADDALU18X18; CPU 54.972 MHz, +0.327 ns setup slack, zero setup/hold violations. The tightest path remains a pre-existing core GPR write-data path; no special-path data path appears in the top 25. |
| FPU v2 compiler C0 | Complete, 2026-09-21 | Replaced the architectural Q8.8 model with the two-word Q16.16 encoding/decoder and a 64-scalar-register CpuV3Sim. Builder, decoder, simulator, and RTL field extraction are locked to one encoding contract; the special-function LUT/reference moved to the architecture layer. RCC freezes the Q16.16 source/ABI surface but explicitly rejects FPU operations until C1-C3, and the retired Q8.8 IR/emission is gone. Prescale helpers expose their shift and scaled result rather than claiming exact reconstruction; ACC accumulation is documented as modulo 2^64. The parked FPU display demo remains source-only while S2 temporarily selects the existing non-FPU boot application. | No RTL or bitstream input changed, so PnR was intentionally skipped. Workspace tests 574/0, core co-sim 22/0, system co-sim 2/0; strict clippy/fmt/layer/hygiene/docs pass. |
| FPU v2 compiler C1 | Complete implementation and validation, 2026-09-21 | RCC now lowers scalar Q16.16 construction, raw-half bridges, arithmetic, unary rounding, comparisons, calls/returns, parallel moves, and F-register spills through FLD/FST while preserving the frozen F0..F63 ABI. The core now executes AUX kind-00 GPR/F-register bridges through the existing external F ports and publishes scalar CMP flags to the transient pending test at retirement. A compiled-program co-simulation covers calls, a live-across-call spill/reload, comparison/branch, conversion and raw halves; the cycle-model memory harness now returns real read data instead of zero. Vector ranges, DOT/VMULS, special functions and constant integration remain C2/C3. | Full system: 9,681 Logic (8,004 LUT, 1,197 ALU, 80 RAM16), 4,285 logic FF, 7,082 CLS; BSRAM/DSP counts unchanged; CPU 57.116 MHz, +1.010 ns setup slack, zero setup/hold violations. The tightest path remains the core state-to-GPR-write-data cone; FPU data paths are absent from the top 25. Workspace tests 579/0, core co-sim 23/0, system co-sim 2/0; strict clippy/fmt/layer/hygiene/docs pass. |
| FPU v2 compiler C2 | Complete implementation and validation, 2026-09-21 | RCC now assigns contiguous register ranges to `vec2`/`vec3`/`vec4`, including packed FPU ABI arguments/results, range spills, cycle-safe vector moves and hardware partial-overlap constraints. Constructors, lane access, component arithmetic/unary operations, VMULS broadcasts, `fdot`, and vec4 import/export lower to the two-word VECTOR/AUX ISA. A compiled vector program crosses function calls and exercises VADD, VMULS, DOTSTORE, lane extraction and FLDV/FSTV in both core and full-system co-simulation. That test exposed and fixed a shared-multiplier ownership bug: a global return-valid pulse could select the multiply operand mux while a dot product was still issuing; path-local outstanding counters now own the mux through drain. The full-system boot example was also updated to match the temporary C0-C2 S2 placeholder instead of waiting forever for the parked display demo's UART frame. Special functions remain for C3; the frozen prescale library family is revisited there. | Full system: 9,689 Logic (8,011 LUT, 1,198 ALU, 80 RAM16), 4,285 logic FF, 7,009 CLS; BSRAM/DSP counts unchanged. This placement reaches 50.407 MHz with -1.320 ns worst setup slack (2 setup paths), while hold is clean. The two failing paths are the existing core state-to-GPR-write-data cone; FPU leaf data paths are not critical (the first FPU control endpoints have +0.421/+0.449 ns). Workspace tests 590/0, core co-sim 24/0, system co-sim 2/0; strict clippy/fmt/layer/hygiene/docs pass, and the corrected full-system boot example passes. |
| FPU v2 compiler C3 special/display unit | Complete implementation and validation; prescale decision remains open, 2026-09-21 | RCC now lowers `frcp`, `frsqrt`, `fsin`, `fcos`, and dual-output `fsincos` to the existing two-word SCALAR special encodings and preserves the contiguous two-register SINCOS result. The S2 display demo is restored, migrated from signed raw Q8.8 angle words to Q16.16, and exercises compiled SINCOS, multiply, rounding, integer conversion, cached framebuffer stores, clean, and vblank publication. A 20-million-step host run rendered both waveforms, the two-colour circle, and its phase marker. No FPU constant-table opcode was added: the design table is still proposed rather than frozen, and the real demo needs no such instruction. The first three prescale helpers are expressible with existing operations, but the frozen exact `v3_distance2_gt` contract needs an un-narrowed wide-ACC comparison that the ISA does not expose; the family remains explicitly rejected pending a split/relax/ISA decision. | The generated hardware is unchanged from C2: 9,689 Logic (8,011 LUT, 1,198 ALU, 80 RAM16), 4,285 logic FF, 7,009 CLS; BSRAM/DSP counts unchanged. Placement again reaches 50.407 MHz with -1.320 ns worst setup slack (2 setup paths), hold clean. Both failing paths remain the existing core state-to-GPR-write-data cone; the first FPU control endpoints retain +0.421/+0.449 ns. Workspace tests 591/0, core co-sim 25/0, system co-sim 2/0, and the full-system boot example pass; strict clippy/fmt/layer/hygiene/docs and reproducible boot packaging pass. |
| FPU v2 post-C3 AUX address timing repair | Complete implementation and validation, 2026-09-21; no new Stage | Captures the two-word pair's AUX/FLD/FST `X` field and its GPR-read select before entering the FPU states. The GPR address now starts from local registers instead of a live `ST_FPU2_WORD1/AUX_READ/AUX_APPLY` decode, without adding a pipeline stage or changing instruction latency. This removes the 19-level state -> asynchronous GPR read -> writeback cone that failed after C2; the generated cycle model remains externally identical. | Two independent fits reproduce 9,591 Logic (7,914 LUT, 1,197 ALU, 80 RAM16), 4,286 logic FF, and 6,951 CLS: -98 Logic, +1 FF, and -58 CLS versus C3; BSRAM/DSP counts unchanged. CPU timing closes at 55.966 MHz with +0.650 ns worst setup slack and zero setup/hold violations. The old path is absent from the top 25; the limiter is fetch queue head -> core state, and the first GPR write endpoint has +1.100 ns. Workspace tests 591/0, core co-sim 25/0, system co-sim 2/0, full Icarus/system example, strict clippy/layer/hygiene/docs, reproducible boot packaging, and artifact audits pass. |
| FPU v2 compiler prescale helpers | Complete implementation and validation, 2026-09-21 | RCC now lowers `v3_length2_shift`, `v3_length2_scaled`, `v3_normalize_safe`, and the relaxed `v3_distance_gt` entirely onto existing FPU v2 instructions. The distance helper accepts an ordinary Q16.16 threshold, prescales both inputs with one extra subtraction-headroom bit, narrows the squared length once through `DOTSTORE`, approximates the scaled distance as `s * RSQRT(s)`, and compares it with `threshold >> k`. Shift, narrowing, and special-function error make the boundary intentionally approximate; this removes the proposed raw-ACC compare/read extension. | No RTL or boot-program input changed, so PnR and the frozen benchmark suite were intentionally skipped. Workspace tests 594/0, core co-sim 26/0, system co-sim 2/0; strict clippy/fmt/layer/hygiene/docs and reproducible boot packaging pass. |
| FPU v2 small-range geometry helpers | Complete implementation and validation, 2026-09-21; supersedes the prescale API above | Replaced the prescale/CLZ/high-low/dynamic-shift library with direct small-range helpers: `v3_length2` is one `DOTSTORE`, `v3_normalize` adds `RSQRT` + `VMULS`, and `v3_distance_gt` uses `VSUB`, `DOTSTORE`, `s * RSQRT(s)`, then `CMP`. Release helpers have no guards. Matching `_checked` debug helpers halt with distinct signals when length/normalize components exceed inclusive +/-104, distance inputs exceed -16384..+16383, or a distance component exceeds +/-104. No opcode or RTL was added. | No RTL or boot-program input changed, so PnR and the frozen benchmark suite were intentionally skipped. Workspace tests 598/0, core co-sim 26/0, system co-sim 2/0; strict clippy/fmt/layer/hygiene/docs and reproducible boot packaging pass. |
| FPU v2 compiler and benchmark closure | Complete, 2026-09-21; FPU v2 line closed | Migrated the ten remaining Q8.8 benchmark sources to the final Q16.16 raw-half API while preserving their real inputs, loop counts, tiers, and cycle bounds. Full-width checksums now fold both halves; transform and particle state retain all 32 bits. Raw conversion is emitted directly at each call site, avoiding helper call/return overhead inside measured loops. Exact halt values were re-frozen and all 22 workloads pass. This is an explicit suite-identity revision, so performance results before and after it are not compared. | No RTL, ISA, compiler, or boot input changed, so PnR was intentionally skipped. Final frozen-suite performance is recorded under the new fingerprint in the project ledger; workspace validation and both mandatory co-simulations pass. |
| RCC allocator, vector, and segmented application layout | Complete, 2026-09-22; suite-identity revision | Replaced the linear heap scan with four segregated best-fit free lists, immediate boundary-tag coalescing, and in-place-first realloc. The checked `u16` vector API now supports reserve, clear, shrink, zero initial capacity, and roughly 1.5x growth. Tang applications place code and data in distinct windows: code starts at offset zero; the first three 32-KiB data pages reserve 16 KiB for statics, almost 64 KiB for the current tag-limited heap, and about 16 KiB for the downward stack. The fourth logical quarter is reserved as a dynamically remappable library/device window. The old vector benchmark had treated its first OOM as success; it now completes all six rounds, so earlier measurements are not comparable. | The relocated boot applications change generated boot contents. Workspace debug/release pass 625 tests, the 22-program suite passes, core/system co-simulation passes 26/2, and the boot package is reproducible; fitted and suite ledgers are recorded post-commit. |
| ISA 0.9 paged DSEG and asynchronous D-cache line operations | Complete implementation and validation, 2026-09-22 | `DSEG0..3` independently map the four logical 16-Kword quarters; legacy `MTSR DSEG` establishes four consecutive mappings. `LCOPY` redirects the existing line write-back to another physical page, `DCLEANL` writes one dirty resident line, and `DWAIT` is their explicit completion/error boundary. Function-E selector 7 is reserved after removing `DPREFETCHL`: without refill-time hit concurrency it did not improve the measured matrix stream, while the attempted sidecar cost 303 Logic and worsened timing. RCC exposes the three retained commands. | Full system after removal: 9,779 Logic (8,081 LUT, 1,218 ALU, 80 RAM16), 4,273 logic FF, 7,043 CLS; BSRAM/DSP counts unchanged. CPU timing closes at 54.956 MHz with +0.322 ns worst setup slack and zero setup/hold TNS. The 17-level limiting path runs from core state/register selection through DSEG address formation and line-copy control to the D-cache `wb_for_maintenance` enable. Release tests pass 347/0; core/system co-simulation passes 26/2; focused D-cache RTL and full PnR pass. |
| GPU fixed-line memory bring-up | Complete implementation and validation, 2026-09-23 | Moved display into a seven-owner main arbiter, made `SharedSdramPort` a single-client adapter, changed the two framebuffer slots and scanout to 16x16 tile-linear RGB565, and added device 4 with a two-entry submit FIFO, temporary three-opcode command processor, one-line command buffer, and serial dummy tile writer. S2 alternates two aligned heap command buffers and framebuffers, cleans only the two command lines, waits for GPU retirement and vblank, then reports DDHT `0x0b`. The interface remains fixed at 4x64-bit; variable 64..128-byte transactions and the real GPU frontend/cache are later milestones. | Full system: 11,313 Logic (9,300 LUT, 1,431 ALU, 97 RAM16), 4,696 logic FF, 7,802 CLS; 3 SDPB + 4 DPB + 1 pROM and DSP counts unchanged. CPU timing closes at 55.541 MHz with +0.514 ns worst setup slack and zero setup/hold TNS; the limiter is the existing FPU SINCOS result stage. Workspace tests pass 646/0, core/system co-simulation 26/2, seven system RTL tests, boot/SystemSim closure, resource audit, and PnR pass. A 16-to-9-bit draw-counter probe reduced 59 Logic and 8 registers but perturbed placement to 52.752 MHz, so it was rejected; the retained width is the clearer timing-clean implementation. |
| GPU variable line bursts | Complete implementation and validation, 2026-09-23 | Extended the three GPU masters, main arbiter, SDRAM adapter, host memory model, and related-clock service to one through four 32-byte lines. Reads carry 4/8/12/16 64-bit beats; long writes use request acceptance for beat zero and an explicit per-beat ready thereafter. Four values are preloaded before WRITE, then one 8x64 circular gearbox overlaps 54-MHz capture with 108-MHz 32-bit playback, avoiding a complete-request buffer in both adapter and wrapper. Requests cannot cross a 1-KiB SDRAM row. The current dummy GPU remains one-line, so this is an interface/performance foundation for the frontend and framebuffer cache rather than a demo behavior change. | Full system: 11,445 Logic (9,425 LUT, 1,438 ALU, 97 RAM16), 4,936 logic FF, 8,050 CLS; BSRAM and DSP counts unchanged. CPU timing closes at 54.730 MHz with +0.247 ns worst setup slack; the limiter is the existing fetch-queue metadata path. The first gearbox/controller path closes 108 MHz with +1.260 ns slack. Variable gearbox RTL, adapter RTL, crate tests, CPU/core system co-sim, full-top elaboration, and PnR pass; the known S1 Flash simulation failure remains independent. |
| Generic device watch-change wait | Complete implementation and validation, 2026-09-23 | Added a two-write system-control watch ABI and a registered read probe that holds only CPU retirement until a selected 16-bit device channel changes. GPU completion and display vblank in the dummy demo now sleep instead of polling. The architecture simulator advances autonomous target devices under the same hold contract, including the read-to-arm race. A single physical `cpu_hold` register plus a watch discriminator keeps cache-maintenance and watch completion independent without adding a hold mux on the CPU path. | Full system: 11,560 Logic (9,522 LUT, 1,456 ALU, 97 RAM16), 4,961 logic FF, 8,072 CLS; +115 Logic and +25 logic FF versus `6da2bec`, with BSRAM/DSP unchanged. System control itself is 65 LUT + 16 ALU + 67 registers; the 16 ALU are the exact 16-bit change comparator. CPU timing closes at 54.720 MHz with +0.244 ns slack. The actual critical path remains core state through D-cache control, not the watcher or device-read mux. |
| GPU blocking tile framebuffer cache | Complete implementation and validation, 2026-09-23 | Replaced direct dummy writes with an eight-entry direct-mapped 16x16 RGB565 tile cache. Temporary three-qword draws fetch aligned `u16` tile lists, execute LOAD or CLEAR plus a row-masked color write, clean dirty victims with four 128-byte writes, and drain all dirty entries before publishing completion. The system now connects the GPU framebuffer-read master. Small command/list/payload arrays omit unnecessary reset writes so they infer RAM16; the 512x64 tile store fits as two BSRAM blocks. A standalone bounded GPU runner produces a decoded PPM without booting the CPU. Full-top simulation exposed and fixed the adapter's refresh/request collision by accepting the already-advertised request before servicing the overdue refresh. | Full system: 12,587 Logic (10,427 LUT, 1,536 ALU, 104 RAM16), 5,309 logic FF, 8,603 CLS; 5 SDPB + 4 DPB + 1 pROM, DSP unchanged. CPU timing closes at 54.562 MHz with +0.191 ns slack; the limiting path is core state to GPR write data, not the GPU or cache. Controller timing closes at 122.284 MHz. Focused Rust/RTL cache tests, S2 full-top GPU/UART flow, co-sim, resource audit, and PnR pass; the pre-existing S1 full-top load assertion remains separate, and physical-board evidence is pending. |
| GPU memory-path resource repair | Complete implementation and validation, 2026-09-23 | Replaced the 8x64 long-write gearbox ring with one 64-bit holding register. The 54-MHz adapter preloads one pair, phase-aligns Controller HS commands, then advances the framebuffer-cache source on each high-half sampling edge; a 128-byte write remains in its cache entry and has no transaction write buffer. The cache valid/victim leaf now instantiates twelve `RAM16SDP1` cells explicitly for synthesis, preventing the D-cache instance from context-sensitively expanding into 128 FF plus read muxes. The audit also corrected the GPU leaf's pre-existing RAM16 claim from 24 to the fitted 32 cells. Display's 4x64 response staging is unchanged system-wide: it moved from the old shared display/CPU adapter into the display when scanout became a direct 64-bit arbiter client, because the existing line-buffer BSRAM still writes 32 bits at a time. | Full system: 11,744 Logic (9,530 LUT, 1,542 ALU, 112 RAM16), 4,731 logic FF, 7,981 CLS; BSRAM/DSP unchanged. The gearbox is 71 registers, 46 LUT and 5 ALU with no RAM16; D-cache valid/victim is 12 RAM16, 0 FF and 29 LUT. CPU timing closes at 54.237 MHz with +0.081 ns setup slack; Controller HS closes at 162.749 MHz. Focused cache/gearbox/adapter/GPU RTL tests, core co-sim 26/0, system co-sim 2/0, resource audit, and PnR pass. |

Starting with System consolidation, PnR evidence is always taken from the complete `cpu_v3_system`
containing the CPU, boot path, SDRAM controller, and display path. Every subsequent completed stage
must record the Gowin PnR report's total `Logic` count alongside BSRAM use and Fmax. `Logic` is the
vendor report's aggregate logic-unit metric, not merely its LUT subtotal. The consolidation and Stage
5 counts above were reproduced from full-system builds at commits `3f62078` and `df4774a`; Stage 6
and Stage 7 use their corresponding full-system milestone builds. Stage 11 changed only the CPU store
path, and its full-system build closes the 54 MHz CPU clock at 56.51 MHz. Stage 12's full-system build
(commit `dabcb10`) closes the 54 MHz CPU clock at 56.230 MHz; the forward-compare/operand-mux/ALU/
registered-writeback bypass and the Execute-cycle request/response mux cost a little timing over
Stage 11, but the build still reports zero setup and hold TNS on every clock.

The ISA 0.8 migration is deliberately not a numbered Stage: it is an architectural revision, not a
microarchitecture optimization. Its recorded numbers come from the post-migration full-system Gowin
build (`validate-hardware.ps1 -Mode all`, worktree after commit `b43ce4e`): 10,436 Logic (51% of the
fitted device), unchanged memory geometry (4 DPB + 1 SDPB + 2 pROM = 7 BSRAM blocks), and 55.597 MHz
on the 54 MHz CPU clock with zero setup/hold TNS on every clock. Integer DSP use stays at one
`MULT18X18` (the FPU keeps its own); the destructive multiply windows select [15:0]/[23:8]/[31:16]
from the same single multiplier through a constant-indexed part-select. Boot assets regenerated from
the same RCC sources: Stage0 461 words, Stage1 555 words, S1 application 79 words, S2 application
736 words; the Stage0 FNV-1a baseline is re-pinned in `build.rs`. A fresh run of the frozen
benchmark suite under the new ISA is reported separately, not folded into the Stage-to-Stage table.
The later single-stage boot merge (see the table) supersedes that asset set: the board now carries
one 673-word first stage and no Stage1 binary, and the FNV-1a baseline is re-pinned again.

The cache valid/victim RAM16 change and the D-cache dirty window scan are likewise not numbered
Stages. Their recorded numbers come from the full-system Gowin build after commit `148e63a`: 9,640
Logic (8,294 LUT, 770 ALU, 96 RAM16), 4,099 registers, unchanged BSRAM geometry (4 DPB + 1 SDPB + 2
pROM) and two `MULT18X18`, and 54.222 MHz on the 54 MHz CPU clock with zero setup/hold TNS. This
closure is narrow and dominated by core placement: the tightest path is the core's registered GPR
write, and the RAM16 leaves and the maintenance scan are not on it. Against the immediately
preceding build (`a956ca5`, before the scan) the 16-entry window scan removes 282 LUT; against the
pre-RAM16 `08bcc79` build the whole change removes 681 Logic and 97 registers at the cost of eight
RAM16 cells. The frozen suite reports identical per-program cycles, with the post-halt flush varying by at
most three cycles.

## Ordered major tasks

0. Remove the unused per-line snoop/invalidate direction now, freeze the global maintenance ABI and software ownership contract, and put I-cache invalidate immediately before the final boot jump.
1. Add one private 256-bit refill buffer between each cache and DRAM.
2. Change cache-line refill, the arbiter, and the SDRAM adapter to one real `8 x 32-bit` burst.
3. Change each I-cache and D-cache to two BSRAM blocks split by even and odd words, doubling internal bandwidth.
4. Change each I-cache and D-cache to two ways, including two tag lookups and a deterministic replacement policy.
5. Pipeline the I-cache hit path and add a small instruction fetch queue in front of the CPU.
6. Add low-priority next-line I-cache prefetch, reusing the 256-bit refill path.
7. Profile representative workloads and shorten control-flow redirect recovery without branch prediction.
8. Change D-cache to write-back and implement dirty eviction plus global clean/invalidate maintenance in the same change.
9. Run DRAM at exactly twice the CPU frequency through a related-clock 2:1 gearbox while keeping the rest of the system at 54 MHz.
10. Convert each cache's two data BSRAMs to true-dual-port parity banks and transfer cache lines directly as four 64-bit beats.
11. Let one scalar store complete asynchronously in the background while non-memory instructions continue to execute.
12. Overlap single-cycle integer execute with the next fetch through a conservative two-stage frontend and a single registered GPR writeback forwarding path.

Stages 0 through 12 are complete. Preserve the historical ordering above when interpreting old
measurements, and add future optimizations as separate numbered milestones rather than rewriting the
meaning of a completed Stage.

## Architectural decisions

- A cache line remains public and fixed at 16 physical 16-bit words, or 32 bytes.
- The cache/arbiter view of one line is four ordered 64-bit beats at 54 MHz; the physical controller view is eight ordered 32-bit beats at 108 MHz.
- I-cache and D-cache contain no private complete-line refill or write-back buffer.
- The current caches are two-way and use two true-dual-port parity BSRAMs per cache; Stage 10 removed
  the temporary complete-line refill and write-back buffers.
- CPU and controller clocks are exact related PLL outputs. The fixed 2:1 board gearbox is the width and clock boundary; it is not an arbitrary-ratio asynchronous FIFO.
- Two-way associativity, two-BSRAM banking, fetch pipelining, next-line prefetch, and write-back are separate milestones.
- The sixteen scalar registers are an explicit `CpuV3GprRam` module: synchronous-write,
  dual-asynchronous-read distributed RAM. Its synchronous write port commits one cycle after the
  retire; the Rust emulator models that delay exactly, and the Stage 12 forwarding mux exposes a
  matching pending write to a back-to-back dependent instruction.

## Historical stage records

Each Stage section below is a historical record: it describes the design, the measurements, and the
repository state at the time that Stage was implemented, not the current architecture. Where a Stage
section disagrees with the current-state sections above, the current-state sections take precedence.

Stale-measurement notice: the system co-simulation suite commit exposed and fixed a
D-cache emulator timing drift — the Rust model inserted an 8-cycle read drain and an 8-cycle
write-back capture that the RTL never had. Emulator-side measurements in the Stage 8 through
Stage 12 sections (store-miss refill latency, dirty eviction/write-back latency, post-halt flush
cycles, and total cycles of D-cache-miss-heavy workloads) were recorded with the old model and are
inflated. RTL and hardware behavior were always correct. Do not mix these pre-fix latency figures
with post-fix numbers in the same comparison; the affected Stages have been rerun
with the corrected model through `benchmarks/run-history.ps1` (rows marked `reconstructed`).

## Stage 0: remove dead coherence machinery and freeze the final contract

Do this while D-cache is still write-through. It is a small deletion and contract change, not an
early implementation of write-back maintenance.

Audited state at the time, at branch `code-v0.3-dev`, commit `5775bf3`:

- The architecture and RTL caches are direct-mapped, write-through, and no-write-allocate.
- There are no dirty bits, write-back states, clean states, or maintenance busy/completion states.
- `snoop_write_valid` and `snoop_write_address` are not driven by any production system; every system
  cache instance ties them to zero. Only the cache model/RTL and a local test exercise them.
- The Rust transaction model still exposes `invalidate_line`, but no production ownership path uses it.
- Device 0 channels 0 and 1 already perform whole-I-cache and whole-D-cache invalidation.
- Stage0 and Stage1 already use those whole-cache operations at their final handoff.
- `SharedBufferOwner` already models software ownership and requires accelerator DRAM writes to finish
  before CPU reacquisition; it does not implement hardware coherence.

Stage 0 changes:

- Remove `snoop_write_valid` and `snoop_write_address` from the cache Rust interface, generated RTL,
  Verilog template, all tied-zero instances, and tests.
- Remove `invalidate_line` and its DMA/per-line test from the architecture model.
- Keep only full-cache invalidation in the current write-through cache.
- Reserve semantic ABI names for future `ICACHE_INVALIDATE_ALL_DELAYED`, `D_CLEAN_ALL`,
  `D_INVALIDATE_ALL`, and final success/error status. Do not implement a fake clean scanner before
  dirty state exists.
- Define `D_INVALIDATE_ALL` as a cheap valid-bit clear while D-cache is write-through. When Stage 8
  introduces dirty state, the same architectural operation becomes clean-plus-invalidate and holds
  the CPU until all dirty writes finish.
- Expose semantic cache APIs rather than raw public maintenance-channel sends. The compiler/runtime
  boundary must treat them as memory and control barriers.
- Rename ownership predicates from vague store completion to DRAM visibility or clean completion so
  their meaning remains correct after write-back.

Add a non-returning CPU V3 intrinsic with semantics equivalent to:

```text
icache_invalidate_delayed_and_jump(cseg, target) -> !
```

Represent it as one terminal compiler IR operation. Lower it to two adjacent machine words in this
exact order:

```text
DEVSEND ICACHE_INVALIDATE_ALL_DELAYED
JSEG cseg, target
```

It cannot lower as `JSEG; DEVSEND`, because CPU V3 has no jump delay slot and the second word would
never execute. The semantic operation is atomic from software's point of view even though the encoded
invalidate command precedes the jump. No optimizer, register-allocation spill, helper call, or ordinary
instruction may be inserted between the two words.

Change the canonical boot tail now to this shape:

```text
dcache_invalidate_all()      currently one-cycle because write-through
prepare final DSEG/registers
icache_invalidate_delayed_and_jump(cseg, target) -> !
```

After Stage 8, the helper waits for `D_INVALIDATE_ALL` completion before preparing the final redirect;
the intrinsic's final `ICACHE_INVALIDATE_ALL_DELAYED; JSEG` adjacency remains unchanged.

Do not hard-code system-control device/channel decoding into the generic CPU execute state merely to
create the delay. Keep the system-control invalidate output registered and feed that architectural
pulse to both I-cache and the instruction fetch frontend. When fetch pipelining is added, the frontend
uses the pulse to discard queued and outstanding old-path words (now using per-slot current bits). This preserves
the existing generic device bus while giving the intrinsic deterministic behavior.

Stage 0 acceptance:

- A repository search finds no cache snoop ports, per-line invalidation API, or tied-zero snoop wiring.
- Both full-cache invalidations still pass model and RTL tests.
- Stage0 and Stage1 boot tests prove the canonical I-cache-invalidate/final-jump adjacency.
- Existing DMA boot and display tests remain valid under the explicit ownership model.
- BSRAM use and timing do not regress.

## Stage 1: private 256-bit refill buffers

Each cache adds storage equivalent to:

```text
refill_buffer[0:7] : 32 bits per entry
refill_beat        : 0..7
drain_word         : 0..15
refill_error       : one sticky bit
```

Target miss flow:

```text
CPU miss
  -> cache issues one aligned line request
  -> DRAM returns eight ordered 32-bit beats
  -> cache captures all beats in its private 256-bit buffer
  -> arbiter releases the DRAM owner after the physical last beat
  -> cache privately drains sixteen 16-bit words into its existing BSRAM
  -> tag and valid state commit only after a complete error-free line
  -> original CPU request receives its response
```

The low half of beat `n` is cache word `2*n`; the high half is word `2*n+1`.
An error or invalidate must never expose a partially installed line.

Suggested cache states:

```text
IDLE
CHECK
WORD_REQUEST
WORD_RESPONSE
LINE_REQUEST
LINE_RECEIVE
LINE_DRAIN
CPU_RESPONSE
```

Writes remain word transactions during this stage. Read misses use line transactions.

## Stage 2: real SDRAM burst refill

- Replace sixteen independent 16-bit read commands with one aligned cache-line command.
- Return exactly eight 32-bit response beats with explicit `valid`, `ready`, `last`, and `error` semantics.
- Hold arbiter ownership through the physical last-beat handshake, not through the private BSRAM drain.
- Define behavior under refresh and backpressure; beats must remain ordered and stable while stalled.
- Preserve display/GPU deadline traffic and prevent speculative traffic from blocking demand requests indefinitely.

Acceptance:

- One cold read miss produces exactly one line command and exactly eight accepted beats.
- No cache issues sixteen word-read commands for a line refill.
- A second client may acquire the arbiter after beat seven even while the first cache drains its buffer.
- Error injection leaves the destination cache line invalid.
- I-cache and D-cache can independently hold one completed or in-progress refill.

## Stage 3: two parity-split BSRAM blocks per cache

Use two physical BSRAM blocks per cache:

```text
even bank: words 0, 2, 4, ... 14
odd bank:  words 1, 3, 5, ... 15
```

For the later two-way geometry, each bank address is conceptually:

```text
{ way, set[5:0], pair_index[2:0] }
```

This is exactly `2 ways x 64 sets x 8 entries = 1024` addresses per bank. A 32-bit refill beat can write its even and odd halves in the same cycle, reducing the private drain from sixteen cycles to eight.

Do not claim that two 50 MHz 16-bit banks directly absorb the full output of a 100 MHz 32-bit DRAM interface: they sink 32 bits per CPU cycle while DRAM can produce the equivalent of 64 bits per CPU cycle. The refill FIFO remains necessary.

## Stage 4: two-way caches

- Keep 64 sets and 16 words per line; capacity becomes 4 KiB per cache.
- Read both ways for the selected parity bank and compare both tags.
- Define one victim bit per set or another deterministic low-cost replacement rule.
- Use the victim bit as the next replacement way; after a successful refill it points to the other way. Hits do not update it.
- Prefer invalid ways before evicting a valid way.
- For D-cache write-back, dirty state is a later stage, not part of the first two-way conversion.
- Validate same-set alternating lines, invalid-way preference, replacement, invalidate, and refill failure.

## Stage 5: pipelined I-cache hit path and instruction fetch queue

This stage removes fixed hit latency. It is distinct from line prefetch.

Stage 4 hit timing for a simple ALU instruction was:

```text
cycle 1: FETCH_REQUEST
cycle 2: I-cache synchronous BSRAM lookup and tag check
cycle 3: registered cache response and instruction latch
cycle 4: EXECUTE and retire
```

That implementation retired one simple instruction per four cycles when every access hit. The
completed Stage 5 frontend removes the fixed per-word request/response bubble while retaining the
blocking execute machine.

Target organization:

- Make the I-cache hit interface pipelined: accept one lookup address per cycle when no miss, invalidate, or structural conflict prevents it.
- Return the corresponding word and hit/miss result with an explicit registered request tag or address.
- Add a two-to-four-entry instruction fetch queue between I-cache and the CPU core; start with four entries unless PnR shows a reason to reduce it.
- Let the fetch frontend request sequential physical word addresses while queue space exists.
- Let the core pop a queued instruction without performing the old request/response round trip for every word.
- Keep execution in order and allow at most one architectural instruction to retire per cycle; this task is not a full execute pipeline.
- A taken branch, `JALR`, code-segment change, fault, reset, or I-cache invalidate flushes all queued words and restarts fetch from the resolved physical PC.
- Attach an epoch/generation bit to outstanding fetch responses so a late response from a flushed path is discarded.
- On an I-cache miss, preserve the miss address, stop speculative issue as needed, refill the line, and resume without duplicating or skipping a word.
- Prefix words must retain exact architectural ordering with their consumer.

Initial performance target:

```text
simple sequential hit stream: no old per-word cache request/response bubble
conservative core target:      at most one queue-pop cycle plus one execute cycle
expected simple throughput:    approach one instruction per two cycles before a full execute pipeline
```

Do not set a one-instruction-per-cycle acceptance target until register dependencies, forwarding, branch resolution, and execute-stage pipelining are designed explicitly.

Acceptance:

- Sequential I-cache hits can be issued on consecutive cycles and returned in order.
- The fetch queue never overflows or underflows silently under response backpressure.
- Taken branches and code-segment changes execute no stale queued instruction.
- Invalidate during an outstanding lookup or refill cannot make a stale instruction architectural.
- Prefix/consumer tests, branches, boot handoffs, and fault PCs remain bit-exact.
- A cycle-count test demonstrates that a sequential simple-ALU loop improves from the current four-cycle baseline.
- PnR confirms that the pipelined tag/data/mux path meets the selected CPU clock.

## Stage 6: low-priority next-line prefetch — REMOVED after measurement

Stage 6 added a demand-progress-triggered, low-priority next-line I-cache prefetch:

- Trigger a candidate next-line request from real CPU fetch progress near the end of a line.
- Never recursively trigger another prefetch merely because a prefetched line completed.
- Give demand I-cache misses, D-cache traffic, display deadlines, and GPU demand traffic priority over prefetch.
- Reuse the I-cache 256-bit refill path when it is idle.
- Cancel an unissued prefetch immediately; an unavoidable in-flight burst may complete, but its result must be discardable.
- Track `issued`, `useful`, `useless`, and `dropped` counters in simulation or debug builds.

A frozen-suite regression then exposed one violation of the strictly-low-priority rule: in small
fully-cached loops the offset-10 trigger fired just before the loop's backward branch, and once
the prefetch burst was committed it could not be aborted (the shared SDRAM port protocol has no
cancel), so the redirect's own demand fetch — even a cache hit — stalled about seven cycles behind
the draining dead burst, every iteration. The fix (later folded into the removal) was one-entry negative
learning in the two-way cache: a prefetch dropped by `prefetch_cancel` recorded its line address,
and a later request for the same line was dropped at the port without issuing. In the frozen
stage-12 suite this recovered 6.8% of cycles on fpu-short-sincos and 4.7% on fpu-short-splat with
zero cycle change in every other program.

**Removal.** A later cost/benefit audit of the fitted design counted the prefetch-only logic at
roughly 196 flip-flops (~4.6% of the system's 4,229 logic registers, dominated by the 128
`way_*_prefetched` bits) and ~120-180 LUTs (~1.5% of 10,232 Logic), while the frozen stage-12
suite showed the mechanism was nearly inert: 16 issued and 12 useful prefetches across all 22
programs, and disabling it at the emulator cost +20 cycles out of 6,136,236 (+0.0003%). The
entire mechanism — the offset-10 trigger in the fetch queue, the prefetch request/arm/cancel and
cancelled-line learning logic in the I-cache engine, and the simulation counters — was therefore
deleted from the RTL and every bit-exact model. The demand refill path, the fetch queue itself,
and the two-way replacement are unchanged; the suite's prefetch metric columns are retained in
the CSV schema, pinned to zero.

## Stage 7: profiled control-flow redirect fast path

- Add bounded full-system emulator benchmarks for recursive quicksort, control-flow-heavy code, and
  cached data traffic, with cycle categories, cache/SDRAM counters, opcode counts, and redirect waits.
- Generate text summaries and per-redirect CSV traces for bounded benchmark analysis.
- Issue a redirect target request in the restart cycle when request metadata capacity is available.
- Tag that request with the new fetch epoch so old-path responses remain discardable.
- When the queue is empty, fall through a matching response directly to a ready core; if the core is
  backpressured, enqueue the response normally instead of dropping it.
- Preserve the existing bounded metadata FIFO behavior when an old-path response and redirect happen
  together. Do not add branch prediction or architectural delay slots in this stage.
- Promote the sixteen scalar registers from inferred cells to an explicit dual-asynchronous-read
  `CpuV3GprRam` distributed-RAM module, and model its one-cycle synchronous write commit in the Rust
  emulator.

Stage 7 validation used emulator/RTL cycle-by-cycle co-simulation, bounded Verilog regressions for
redirect issue, fall-through, backpressure, and stale epochs, the complete Icarus hardware suite, the
two-stage boot testbench, and a full Gowin rebuild plus current-artifact audit. The fitted system used
8,046 Logic units: 7 BSRAM, 88 RAM16 leaves, 6,749 LUTs, 769 ALUs, and 3,422 logic flip-flops. The
54 MHz SDRAM/CPU clock closed at 57.549 MHz with zero setup and hold violations.

The checksum-protected quicksort retired 708,531 words in 2,467,577 cycles (3.483 cycles per retired
word), saving 184,500 cycles, or 6.96%, from the Stage 6 baseline. Of 92,249 redirects, 92,244 hot
redirects waited exactly two cycles instead of four; the remaining five included cold I-cache misses.
The trace attributed 35.09% of all cycles to the data request/response path and 7.48% to fetch waits.
Its D-cache observed 152,482 loads, 44,457 write-through stores, and only 315 line refills, making
write-through store latency the next dominant optimization target. The full quicksort test runs in
release mode and is explicitly ignored by ordinary debug test runs.

The scalar register file was promoted from inferred cells to an explicit `CpuV3GprRam` module
(synchronous-write, dual-asynchronous-read distributed RAM), cutting 2,178 LUTs and 236 logic
flip-flops while adding eight RAM16 leaves and raising Fmax from 57.293 to 57.549 MHz. The FPU
register-file SSRAM claim dropped its `+8` inferred-cell fudge in favor of a precise split. The GPR
RAM's synchronous write port commits one cycle after the retire; the Rust emulator stages a
`gpr_write_enable`/`gpr_write_address`/`gpr_write_data` request and applies it at the start of the
next clock, matching the RTL exactly. The `sequential_alu_stream_reaches_two_cycle_throughput`
regression confirms the two-cycle-per-instruction target is unchanged, and a bounded
`verify_gpr_ram_with_iverilog` test covers the register file directly.

## Stage 8: D-cache write-back and global maintenance engine

- Add dirty state per way and set.
- Evict a dirty victim before overwriting its data or tag.
- Complete write-back before installing the replacement line.
- Define error behavior so neither old nor new data is falsely reported valid.
- Keep device and uncached accesses outside normal cache allocation.
- Reuse the private 256-bit line buffer for dirty eviction and maintenance write-back where practical.
- A global clean engine scans all sets and ways, writes one dirty line at a time, and blocks new D-cache requests until it finishes.

Implement write-back and its complete global maintenance engine in this same stage. Expose only:

```text
ICACHE_INVALIDATE_ALL_DELAYED  one cycle later, invalidate every I-cache way and flush fetch
D_CLEAN_ALL                  write every dirty D-cache line, then leave lines valid and clean
D_INVALIDATE_ALL             write every dirty D-cache line, then invalidate every D-cache way
CACHE_MAINTENANCE_HOLD       internal CPU hold, asserted from command acceptance through completion
CACHE_MAINTENANCE_STATUS     final success or DRAM error
```

`D_INVALIDATE_ALL` is architecturally clean-plus-invalidate. Do not expose an unsafe command that
silently discards dirty data. D-cache clean and invalidate are variable-latency operations and are not
complete until every accepted DRAM write-back has completed successfully. Implementing these states
together with dirty eviction prevents a temporary range/snoop protection design from being built and
then removed.

Expose CPU-blocking intrinsic-like APIs:

```text
dcache_clean_all()      -> maintenance status
dcache_invalidate_all() -> maintenance status
```

Each operation sends one command. Command acceptance asserts `CACHE_MAINTENANCE_HOLD` before any later
instruction can retire. The CPU preserves its architectural state while held; I-cache, D-cache,
arbiter, and DRAM clocks continue. Hold is released only after the final required DRAM response, then
the intrinsic returns success or the recorded error from `CACHE_MAINTENANCE_STATUS`.

Do not physically gate the shared clock and do not implement a software polling loop. Give the CPU
core/fetch frontend an explicit synchronous hold input with priority over normal state transitions.
The core need not decode system-control device numbers: the system controller owns command decoding
and drives the generic hold. The D-cache also rejects CPU data requests while maintenance is active.

The intrinsic is a full compiler memory barrier: prior stores cannot move after the command and
subsequent cached accesses cannot move before hold is released. Do not expose a raw asynchronous start
API in the first revision. The write-back engine releases DRAM arbitration between bounded line bursts
so unrelated mandatory memory clients are not starved.

### Implementation decisions (2026-08-30)

- Split the I-cache and D-cache into separate modules. The I-cache becomes read-only: it drops the
  CPU-side write port, the write-through store path, and the `cpu_write`/`cpu_write_data` inputs. The
  D-cache gains write-back, dirty eviction, and the maintenance engine.
- Dirty state lives in a separate 128-bit SSRAM (two 64-bit words, one bit per way per set), not in the
  tag RAM. The maintenance scan uses a find-first-set / priority encoder over the dirty word, so the
  next dirty line is located in one cycle instead of scanning one set per cycle.
- Write-back and maintenance reuse the private 256-bit line buffer: the dirty/victim line is read from
  the data BSRAM into the buffer, streamed to DRAM as an eight-beat write burst, then the buffer is
  reused to receive the incoming line.
- Generalize the arbiter-to-SDRAM `memory_read_line` signal into `memory_line` (a line-transaction
  flag): `memory_write=0 && memory_line=1` is a line read, `memory_write=1 && memory_line=1` is a line
  write, and `memory_line=0` is a word transaction. The SDRAM adapter burst length becomes
  `(display || pending_line) ? 7 : 0`, and its write-data path streams eight 32-bit beats for a line
  write.
- The core stays a blocking execute machine: a write-back store hit completes in about two cycles
  (accept plus lookup), while a store miss read-allocates the full line first; `cpu_request_ready`
  drops exactly while the D-cache is busy (refill, eviction write-back, or maintenance). A posted-store
  write buffer is a separate follow-up, not part of this stage.
- CPU-issued `dcache_invalidate_all()` / `dcache_clean_all()` drive the same maintenance engine: the
  system-control device registers the command, starts the engine, asserts `CACHE_MAINTENANCE_HOLD`, and
  releases it with `CACHE_MAINTENANCE_STATUS` on completion. The I-cache invalidate stays single-cycle.

### Implementation result (2026-08-30)

Stage 8 is complete in the fitted `cpu_v3_system`. The production instruction-cache boundary is
read-only and ties off the proven internal cache engine's unreachable store inputs. The independent
D-cache implements write-allocate, dirty-victim write-back, and find-first-dirty global maintenance.
The arbiter and SDRAM adapter carry 32-bit line-write beats; DMA word writes remain in the low half.
The adapter captures all eight cache beats before issuing the SDRAM command, presents beat zero when
the command is acknowledged, then advances beats one through seven on consecutive controller cycles.

Focused RTL tests cover the read-only I-cache boundary, D-cache allocation/store/dirty eviction,
clean/invalidate semantics, line arbitration, and SDRAM word/read/write transactions. The full-system
RTL regression boots Stage0, Stage1, and both applications. Gowin PnR for the complete system reports
9,548 Logic, seven BSRAM blocks, and 54.918 MHz at the 54 MHz constraint. This passes with only
0.918 MHz margin and is narrow timing closure, not a robust frequency margin. Offline artifact audit
passes; physical board programming and observation of the controller's burst-write sampling remain
separate hardware validation.

## Stage 9: DRAM at twice CPU frequency

Implementation decision (2026-08-31): use exact related clocks, not an arbitrary-ratio asynchronous
FIFO. One PLL produces a 108 MHz Controller HS clock and its exact divide-by-two 54 MHz CPU/cache
clock. These clocks remain a timed related group; only the independent HDMI pixel domain is grouped
as asynchronous.

- CPU cache and memory-arbiter line ports are 64-bit at 54 MHz. One 256-bit line is four ordered
  beats; the existing eight-entry 32-bit cache buffers and parity-split BSRAM organization do not
  change.
- Controller HS and physical SDRAM remain 32-bit at 108 MHz. The board boundary pairs two read beats
  into one 64-bit CPU beat and splits one staged 64-bit write beat into two physical beats.
- A line write is staged completely in the 54 MHz domain before its SDRAM command is issued. The
  stable four-entry buffer is then consumed by the 108 MHz side; no changing 256-bit array is sampled
  across the boundary.
- Read pairs and command acknowledgements cross on tokens published at the controller-clock falling
  edge, leaving half a 108 MHz cycle before a related CPU-clock sampling edge. This is a fixed 2:1
  gearbox, not a general-purpose CDC FIFO.
- CPU/DMA word transactions continue to use the low 16 bits. Display remains an eight-beat 32-bit
  consumer; the shared adapter drains a completed four-entry 64-bit display buffer as eight words.

Acceptance additionally requires PnR timing at CPU 54 MHz / controller 108 MHz and physical board
validation of Controller HS read-valid phase and burst-write sampling. Simulation and PnR alone do
not prove those two vendor-controller timing details.

### Implementation result (2026-08-31)

The fitted system now derives related 108 MHz Controller HS and 54 MHz CPU/cache clocks from one
PLL. A board-level 2:1 gearbox holds commands, pairs two 32-bit controller reads into each 64-bit
CPU beat, and splits staged 64-bit line writes into two controller beats. CPU, caches, arbiter,
display scheduler, boot DMA, and system control remain in the 54 MHz domain. The HDMI pixel clock
remains independent and is the only domain grouped asynchronous to the CPU/controller clock group.

The display scheduler captures four 64-bit controller beats, then releases SDRAM ownership after
the normal recovery interval while the local buffer independently emits eight 32-bit display words.
An RTL test verifies that a CPU transaction is accepted before that display drain completes.

Stage 9's independent full-system PnR closes the 54 MHz CPU clock at 54.965 MHz. It uses 10,345 Logic
and seven BSRAM blocks; every reported setup/hold TNS is zero. CPU closure remains narrow. Physical
board confirmation of the vendor controller's read-valid phase and burst-write sampling is still
outstanding.

## Stage 10: dual-port cache BSRAMs and direct 64-bit line transfer

Replace each cache's two 1R1W parity/XOR-organized BSRAMs with two true-dual-port BSRAMs. Both ports
of a block always use the same mode in a cycle: either both read or both write. The cache never asks a
block to read and write in the same cycle.

- Remove the `bank = way XOR word_parity` mapping. Use `bank = word_index[0]`: bank 0 holds the eight
  even words of every line and bank 1 holds the eight odd words. Way is an ordinary address bit.
- Lookup mode uses the two ports of the selected parity bank to read the same word from way 0 and way
  1 concurrently. Tag comparison selects the returned way; no XOR reconstruction remains.
- Refill mode writes one 64-bit memory beat directly through all four 16-bit ports: bank 0 receives
  words 0/2 and bank 1 receives words 1/3 of that beat. Four cycles install the 256-bit line.
- D-cache write-back mode reads four words of the selected victim per cycle through all four ports and
  presents the resulting 64-bit beat directly to the memory interface. A synchronous-read prime phase
  is allowed before the request; thereafter four ordered beats stream without a private line buffer.
- Remove the I-cache refill buffer and D-cache refill/write-back buffer. Partial refills remain hidden
  by clearing/reserving the victim valid bit before the first direct write and committing tag/valid
  only after the fourth error-free beat. If 54 MHz timing requires it, add one explicit register at a
  named BSRAM-output or 64-bit memory-interface boundary rather than restoring a 256-bit line buffer.
- Store hits switch the selected BSRAM to write mode for that cycle. The cache pipeline must ensure no
  lookup read is required in the same cycle.

Acceptance:

- I-cache and D-cache still use exactly two 18-Kbit BSRAM blocks each.
- Every line is split evenly across the two blocks, with no way-dependent XOR mapping.
- Refill and write-back sustain one 64-bit beat per CPU cycle after any documented prime stage.
- No cache contains a private 256-bit refill or write-back register array.
- Replacement, dirty eviction, clean/invalidate, refill-error, and same-set way-selection tests pass.
- Full-system PnR still closes CPU 54 MHz and Controller HS 108 MHz; BSRAM packing and mode reports
  confirm the intended true-dual-port configuration.

### Implementation result (2026-08-31)

Each cache now owns one target leaf containing two inferred 1024 x 16 true-dual-port memories.
Bank 0 stores even words and bank 1 stores odd words; way is a normal address bit. Lookup reads both
ways through the two ports of the selected parity bank. Refill writes all four 16-bit ports directly
from each 64-bit beat. D-cache write-back uses one synchronous prime/capture boundary for beat zero,
then streams all four 64-bit beats without assembling a complete line in registers.

The I-cache emulator was updated to the same direct four-beat timing and passes cycle-for-cycle
Icarus comparison. Focused I-cache, D-cache, replacement, refill-error, dirty eviction,
clean/invalidate, and display/SDRAM simulations pass with bounded testbenches. Workspace quick
validation, strict Clippy, layering, source hygiene, boot regeneration, and byte-for-byte boot
repacking all pass.

The combined Stage 9/10 PnR reports 9,977 Logic (8,766 LUTs, 683 ALUs, 88 SSRAM cells), 4 DPB,
1 SDPB, 2 pROM, and 2 MULT18X18. The two I-cache DPBs and two D-cache DPBs are each attributed as
one two-block cache data leaf, so synthesis may legally pack/merge bank hierarchy without defeating
the exact two-BSRAM-per-cache resource audit.

## Stage 11: one-entry asynchronous store

Write-back stores and direct 64-bit line transfer still forced every scalar store to wait for its
data-port handshake before the core could fetch again. A store sat on the critical path, stalling the
whole blocking execute machine even though nothing yet read the stored value. Stage 11 lets one scalar
store finish in the background.

Design:

- Add a single-entry store buffer: `async_store_valid`, `async_store_issued`, `async_store_address`,
  `async_store_data`, and `async_store_fault_pc`, plus a new `ST_ASYNC_STORE_WAIT` core-FSM state.
  The emulator mirrors it as `AsyncStore` and the `Phase::AsyncStoreWait` enum variant.
- A store instruction (`opcode 0x9`) that finds the buffer empty retires immediately and returns to
  fetch. The buffered store owns the data port: `data_request_valid`, `data_write`, `data_address`,
  `data_write_data`, and `data_response_ready` all follow the outstanding store while it is in flight,
  in place of the normal pending-data path.
- Non-memory instructions (ALU, FPU, branches) continue to execute and retire while the store request
  is outstanding, hiding store memory latency behind useful work. The store no longer blocks its own
  instruction.
- Any later memory operation blocks: a second store, a load, or an FPU memory access waits in
  `ST_ASYNC_STORE_WAIT` until the single buffer drains, then it either enqueues a new store or advances
  to a normal data request. Memory ordering stays strict: at most one store is outstanding.
- `halted` is not asserted until the last buffered store is globally observed (`state == ST_HALTED &&
  !async_store_valid`), so a program that stores a result cannot expose its halt before the store
  commits.
- A store that gets an error response records `FAULT_DATA_MEMORY` with the buffered fault PC and the
  core transitions to fault only after the store response is accepted.

### Implementation decision (2026-09-01)

The core adds the buffer only when a store is retired and reuses the existing pending-data path to
hold a blocked store so it can become the next async store once the current one drains. The Verilog and
the Rust emulator share the same nonblocking timing: a freshly enqueued store cannot issue on the same
edge that created it, and a waiter observes completion one cycle after the response handshake. The
benchmark profiler now counts the fetch and data interfaces independently; the previous else-if chain
silently dropped every overlapped store.

### Validation (2026-09-01)

- Scenario 37 in `cpu_v3_core_tb.v` delays the data response, overlaps an `ADD` with a `STORE`, and
  checks that the ALU ran while the store was outstanding, that exactly two data requests occur, and
  that the final memory word holds the stored value.
- The bounded emulator test
  `emulator_async_store_overlaps_alu_and_blocks_next_memory_operation` asserts the store retires to
  fetch immediately, the overlapped ALU retires, and the following load parks in `AsyncStoreWait`.
- `data_probe_counts_overlapped_scalar_requests_and_latency` asserts that data requests equal the
  retired load-plus-store count rather than the earlier word-transaction proxy.

### Stage 11 results (commit `6789380`) against Stage 10 (`76d5bef`)

The 13-program suite is unchanged. Workloads that issue no store are bit-identical. Memory-heavy
workloads improve:

| Workload | Stage 10 cycles | Stage 11 cycles | Change |
| --- | ---: | ---: | ---: |
| int-short-memory | 3,415 | 3,214 | -5.9% |
| int-medium-memory | 75,038 | 70,750 | -5.7% |
| streaming-mix | 894,623 | 842,341 | -5.8% |
| quicksort-4096 | 5,217,959 | 4,989,362 | -4.4% |

The data-path cycles still dominate the memory-heavy cases: streaming-mix attributes 24.5% of its
cycles to the data request/response path and quicksort-4096 32.0%. A single store buffer is a partial
fix: it hides store latency only until a later memory operation needs the data port, so a deeper
store pipeline or a small write-combining buffer is the natural follow-up.

The Stage 11 full-system PnR reports 10,025 Logic, 4 DPB + 1 SDPB + 2 pROM, and closes the 54 MHz CPU
clock at 56.51 MHz.

## Stage 12: conservative two-stage fetch/execute overlap

Stage 5 pipelined the I-cache lookup and added a four-entry fetch queue, but the core was still a
blocking machine: it waited for the next word before retiring the current instruction. The Stage 11
commit history shows a roughly two-cycle-per-instruction floor for pure integer code (Stage 11
`int-medium-alu` was 2.50 cycles per retired word). Stage 12 overlaps ordinary single-cycle integer
execution with the next fetch so the core can accept a fresh instruction in the same cycle it retires
one, approaching one cycle per instruction without building a full execute pipeline.

Design:

- Keep the existing staged backend for every instruction that does not retire cleanly in one Execute
  cycle. Only a narrow class is promoted to the overlap path, so the change is a "limited two-stage
  frontend", not a pipelined CPU.
- Promote single-cycle, sequential-control-flow instructions to the overlap path:
  `opcode` `0`/`1`/`3..7` (ALU), `0xa` with `field_d != 8` (immediate; `field_d == 8` is the multiply
  barrier), the `0xe` control subset that is not itself a control transfer (`field_d <= 3`, `6`, `7`,
  `9..c`, `d` with `field_b <= 1`, `e` with `field_a == 1`), the `0xf` SETP prefix, and `0x9` stores
  only while the single async store buffer is empty.
- Keep as barriers: loads (`0x8`), stores with a busy buffer, multiply (`0x2`, `0xa/8`), FPU (`0xd`),
  branches/jumps (`0xb`, `0xe` fields `4`/`5`/`15`), devices (`0xc`), and the invalid instruction
  cases. These continue to use the exact pre-existing FSM transition.
- When a pipelineable instruction is in `ST_EXECUTE` and the queue has a response, the core drives
  `instruction_request_valid`/`instruction_response_ready` from Execute, loads the popped word into
  `instruction`/`instruction_pc`, advances `pc_register`, and stays in `ST_EXECUTE` instead of
  returning to `ST_FETCH_REQUEST`. If the queue is momentarily empty it falls to `ST_FETCH_RESPONSE`
  and resumes the original blocking path.
- The scalar register file keeps its registered synchronous write port. The read level is now a mux:
  `gpr_read_a_data`/`gpr_read_b_data` come from the pending `gpr_write_data` when
  `gpr_write_enable && gpr_write_address == <read>` and from the RAM async reads otherwise. This single
  bypass removes the earlier ordering requirement that back-to-back Execute cycles be two apart and is
  what makes a dependent `ADDI r0,r0+1` chain run at one cycle per instruction. The ALU result is still
  captured into the registered writeback; it is never driven combinationally into the GPR RAM write
  port, keeping the forward-compare/operand-mux/ALU/registered-writeback path off the timing-critical
  wrap.

### Implementation decision (2026-09-01)

The Verilog and the Rust emulator evolved together and share the same nonblocking timing. The
fetch-pipeline probe's sequential-ALU cycle target tightened from `<= 17` to `<= 10` cycles after the
first retire (the test now expects one instruction per cycle for a register-dependent chain, which
also exercises the forwarding bypass directly). `cpu_v3_core_tb.v` scenario 35/36 expected cycles were
reduced from 80/48 to 76/46 because the frontend no longer inserts a fetch bubble before the FPU
operations; these are timing updates, not numerical changes.

The cycle-profiled benchmark profiler changed its retirement attribution. The old model assumed the
instruction fetched before the next was also the one that just retired, which under the overlap path
counted every successor tag; that would mis-attribute, for example, 391 data requests against 256 real
loads. The profiler now keeps a small FIFO of frontend-accepted words and attributes a retire to the
oldest accepted word (popping per retired word, so a prefixed consumer retires two), and only flags a
redirect for genuinely control-transfer instructions whose resolved target differs from the fall-through
word.

### Stage 12 results (against Stage 11)

The same 13-program suite. Integer workloads gain the most; FPU-composed programs are nearly unchanged
because their steady state is dominated by the FPU pipeline barriers, not the fetch frontend.

| Workload | Stage 11 cycles | Stage 12 cycles | Change |
| --- | ---: | ---: | ---: |
| int-short-alu | 590 | 404 | -31.5% |
| int-short-branch | 2,244 | 1,508 | -32.8% |
| int-short-memory | 3,214 | 2,147 | -33.2% |
| int-short-mixed | 1,355 | 878 | -35.2% |
| int-medium-alu | 30,768 | 21,547 | -30.0% |
| int-medium-memory | 70,750 | 46,164 | -34.8% |
| streaming-mix | 842,341 | 594,894 | -29.4% |
| quicksort-4096 | 4,989,362 | 4,106,038 | -17.7% |
| int-icache-jump | 10,990 | 8,393 | -23.6% |
| fpu-short-add | 62 | 59 | -4.8% |
| fpu-short-mul | 63 | 60 | -4.8% |
| fpu-short-unary | 54 | 53 | -1.9% |
| fpu-long-mixed | 24,630 | 24,627 | -0.0% |

The geometric mean of the per-program cycle ratio is 0.774, a 22.6% cycle reduction across the suite.
`int-medium-alu` falls to 1.75 cycles per retired word (from 2.50) and `int-medium-memory` to 1.55
(from 2.38). The remaining head in integer programs is the data request/response path (quicksort-4096
still attributes 38.9% of its cycles to the memory path) and the branch redirect wait; those are the
natural next targets.

### Validation (2026-09-01)

- Release-mode emulator results above (not committed).
- `cargo test --workspace`: 410 passed; CPU V3 78 passed / 10 ignored.
- Verilog/RTL Icarus for the CPU V3 core, GPR RAM, and the fetch-pipeline probe passed with the new
  cycle contract.
- A cycle-accurate emulator-vs-Icarus co-simulation of the core now drives the same program through
  the Rust emulator and the RTL and compares a curated set of deterministic outputs every cycle
  (program counter, segments, retired words, halt/fault, and the instruction/data handshake), covering
  the Stage 12 overlap (a dependent `ADDI` chain at one instruction per cycle), the wide SETP-retire,
  a taken-branch redirect, the async store whose data value equals the forwarded `r0`, an FPU barrier,
  and the halt value. It runs as `core_emu_matches_rtl_pipeline_overlap` under `--ignored`.
- `halt_signal` was tightened from a live async GPR tap to a value latched at the HALT retire edge
  (mirrored in the emulator), so it is a stable architectural property that the co-simulation compares
  directly each cycle rather than only at the halt cycle.
- `scripts/validate-hardware.ps1 -Mode quick` and `-Mode iverilog` pass, including the two-stage flash
  boot signature testbench. This surfaced and fixed a pre-existing (Stage 9) mismatch: the
  `CpuV3System` top module exposes a 64-bit `sdram_write_data`/`sdram_read_data` gearbox interface
  while the signature testbench still modeled the 32-bit controller path, so its `.*` instantiation
  could not elaborate. The model now captures the four 64-bit line-write beats and returns line reads
  as four 64-bit beats, matching `SharedSdramPort`.
- Full-system Gowin PnR (`cpu_v3_system`, commit `dabcb10`): 10,100 Logic (8,822 LUT, 750 ALU,
  88 SSRAM); 4,324 registers; 4 DPB + 1 SDPB + 2 pROM; 2 MULT18X18. The CPU clock closes at
  56.230 MHz against the 54.000 MHz constraint (2.23 MHz margin), and every reported setup and hold
  TNS is zero. `clk` and the display controller clocks close as expected. The tightest CPU path is the
  fetch-queue to I-cache way-valid route (0.734 ns slack), a Stage 5+/fetch-frontend path rather than
  the new forwarding/overlap logic. Board-level DRAM timing is unchanged from the Stage 9/10 gearbox
  and remains subject to the normal physical-boardside validation.

## Follow-up fix: word writes and Controller HS burst protocol (2026-09-04)

The shared SDRAM port only asserted `controller_write_data_valid` for line writes
(`state == ST_WRITE_STAGE`), and the 54/108 MHz gearbox only filled its `write_buffer` on that
signal. A CPU/DMA word write therefore issued CMD_WRITE with `burst_length == 0` but never presented
write data; the controller sampled a stale `I_sdrc_data = write_buffer[0][31:0]`. The boot DMA's
Stage0-to-Stage1 SDRAM loads are word writes and were the first victim on physical hardware. All
three simulators masked the fault: the signature testbench SDRAM model committed word writes straight
from `sdram_write_data`, and the Rust `SdramModel` / `system_cosim_tb.v` committed
`pending_write_data` directly, so none exercised the gearbox starvation.

Fix:

- `SharedSdramPort` (display_sdram.v) now routes a word write through the full four-beat
  `ST_WRITE_STAGE`, holding the half-word (already placed for the DQM lane) on
  `controller_write_data` while `controller_write_data_valid` pulses all four beats, before
  ACTIVE/WRITE. The gearbox `write_buffer` is therefore always filled from capture index zero: the
  write-data stream is four beats for every write, preserving the free-running `write_capture`
  alignment without any gearbox change (a burst-zero write only reads entry zero). Line writes are
  unchanged except that `ST_WRITE_STAGE` now only advances through the line buffer when
  `pending_line`. The lane-positioned word is written to the existing 64-bit output register only
  on request acceptance and then held; recomputing it in `ST_OP_REQ` created a wide next-state mux
  that added 289 LUTs and reduced a deterministic 54 MHz build to 46.991 MHz.
- The Rust `SdramModel` and the `system_cosim_tb.v` behavioral port gained the same four-beat
  word-write `ST_WRITE_STAGE` transition, keeping the cycle-accurate co-simulation aligned with the
  RTL.
- `display_sdram_tb.v` gained a dedicated from-idle word write that asserts the staged data and
  `controller_write_data_valid`, plus a robust write-completion driver (`finish_cpu_write`) that acks
  the ACTIVE/WRITE commands wherever the port is in its sequence.
- Standalone 54/54 and 108/54 diagnostics exposed two additional edge-alignment faults. The
  diagnostic producer itself had driven staged write data combinationally from an already-advanced
  beat counter, rotating the four 64-bit pairs as `pair1, pair2, pair3, pair0`; it now registers
  pair 0 with the first valid cycle and advances one pair per cycle. More importantly, the production
  108/54 wrapper had held Controller HS `I_sdrc_cmd_en` until `O_sdrc_cmd_ack` and started its physical
  write stream only at that ack. The reference contract and board behavior show that `cmd_en` is a
  one-controller-clock request while `cmd_ack` is transaction completion. The wrapper now pulses the
  command once, keeps a separate in-flight flag, presents M0 on the WRITE command interval, and then
  advances through M1..M7. The same board characterization placed 108 MHz read data on phases 4..11;
  phase 3 is stale bus data and is no longer published.

Validation: crate lib/tests, `shared_word_and_burst_port_runs_in_iverilog`, the two-stage boot
signature testbench (which exercises DMA word writes), the system co-sim, and clippy pass. The fixed
standalone 108/54 diagnostic also passes its Icarus memory model; that model was enlarged after this
work found that its former last address was one word below the test region and had allowed unknown
values to mask failures. On the Tang Nano 20K, an interactive LED viewer independently inspected all
eight words through a burst read and eight burst-zero probes. Both the direct 54/54 path and the
production 108/54 gearbox returned M0..M7 exactly. Before moving the 108 MHz read window, the viewer
had shown `M6,M0,M1,M2,M3,M4,M5,M6` and constant stale M6 probes, directly identifying the early
sample. The LED viewer physically confirms the corrected burst values on both paths.

The production `cpu_v3_system` passes full-system Gowin PnR with the corrected shared wrapper at
10,099 Logic (8,822 LUT, 749 ALU, 88 SSRAM), 4,293 registers, 7,053 CLS, 4 DPB + 1 SDPB + 2 pROM,
and 2 MULT18X18. CPU Fmax is 54.386 MHz against the 54 MHz constraint (0.131 ns worst setup slack);
the 108 MHz controller clock reports 182.685 MHz Fmax, and all reported setup/hold TNS is zero. CPU
timing remains valid but narrow rather than robust. Gowin's project-wide warning output remains
enabled. Intentional RTL truncations are documented with source-line `gowin-lint: allow CODE`
markers, while the opaque Controller HS netlist warnings are filtered only by their exact file,
code, and internal-clock identity; other warnings remain visible. Any future GPU word/partial-line
write support must go through the same staged path.

## Follow-up: packed 2048-phase SINCOS lookup (2026-09-06)

The Q8.8 `FSINCOS` range reduction formerly rounded each input onto 1024 phase
steps and used one 16-bit ROM word per quarter-wave sample. Exhaustive software
comparison against host `sin`/`cos` found a two-LSB worst-case error. Merely
retuning the `2/pi` constant or biasing those 256 samples cannot reduce the
bound because one phase bucket can cover ideal results spanning three raw
Q8.8 values.

The final implementation uses 2048 phase steps and 512 quarter-wave samples.
Two unsigned 8-bit samples share each existing 16-bit sine word; samples 492
through the endpoint have the saturated Q8.8 magnitude 256 and reconstruct it
from the reflected sample index instead of storing a ninth bit. The reciprocal
and reciprocal-square-root regions keep their original 16-bit layout. Range
reduction uses the signed `MULT18X18` operand 83443 and rounds its product at
bit 16, which more closely approximates `4/pi` while remaining within the
18-bit multiplier input. The table is now an explicitly instantiated,
initialized DPB; its two synchronous ports read sine and cosine in parallel,
reducing `FSINCOS` from 12 to 9 execution cycles and from 13 to 10
fetch-to-fetch phases. Merely inferring two read-only ports caused Gowin to
duplicate the pROM, so the explicit primitive is required to keep both reads
in one physical block.

The architecture-level ROM error test checks every one of the 65,536 signed
Q8.8 inputs directly through the bit-exact arithmetic, without running the
device or system simulator. Worst error against a rounded Q8.8 host reference
is one LSB, worst continuous-component error is 0.003457, and RMS component
error is 0.001279. The canonical ROM regeneration audit, CPU V3 unit tests,
all eleven ignored CPU RTL/emulator checks (including a nonzero packed-high-half
SINCOS test), system co-simulation, and workspace quick validation pass with
bounded runs.

Full-system Gowin PnR reports 10,472 Logic (9,197 LUT, 747 ALU, 88 SSRAM),
4,294 registers, 7,127 CLS, 5 DPB + 1 SDPB + 1 pROM, and 2 MULT18X18. The CPU
clock closes at 57.917 MHz against 54 MHz with 1.253 ns worst setup slack; the
108 MHz controller clock reaches 175.186 MHz, and setup/hold TNS are zero. The
total BSRAM and DSP counts therefore remain seven and two respectively; the FPU
table changes one pROM into one DPB to expose both physical ports. An explored
18-bit packed ROM also preserved the block count but changed the pROM packing
mode, increased logic/congestion, and failed timing; it was not retained.

## Risk-scaled validation

Select the applicable checks for each stage and record both the checks run and any intentionally
skipped checks in the current implementation progress:

1. Update the Rust transaction model and bounded unit tests when architecture behavior changes.
2. Update RTL and bounded Verilog tests when hardware behavior changes.
3. Run the relevant crate tests for every code change.
4. Run affected external Icarus tests with explicit maximum cycle counts.
5. Run `scripts/validate-hardware.ps1 -Mode quick` for cross-layer or hardware integration changes.
6. Run audit/PnR when RAM geometry, clocking, resource use, or timing paths change.
7. Recheck BSRAM count and packing instead of weakening resource audits when memory changes.
8. Run board validation only when the stage requires physical evidence.

## Resolved-target BTC: measured 4/8-entry comparison

Implemented on `701c7f3+dirty`, without a new Stage number. The architecture and
handshake contract live in the CPU IP
[hardware-architecture.md](../../../ip/cpu-v3/docs/hardware-architecture.md);
configuration and diagnostic semantics live in the
former benchmark contract (retired with the CPU V3 benchmark suite).
This adds no branch prediction, ISA changes, compiler changes or frozen workload revision.

All three configurations ran the same 22 programs with the same compiler/options
and exact halt checks. Program word counts and per-program retired instruction,
retired word and redirect counts agree. Per the benchmark contract's "Comparing
runs" rule nothing is added across programs: every aggregate below is a geometric
mean over per-program values, equal weight (counters that may be zero use the
geomean of value + 1, marked `(+1)`). Geomean characteristics are 12,851.7 retired
instructions/words and 1,214.0 redirects per program. The disabled
configuration reproduces the earlier suite's per-program cycles exactly.

| Runtime metric | BTC disabled | 4 entries (default) | 8 entries (comparison) |
| --- | ---: | ---: | ---: |
| Cycles (geomean) | 34,197.9 | 31,118.3 | 30,683.0 |
| Cycle ratio versus disabled (geomean of per-program ratios) | 1.0000 | 0.9099 (−9.01%) | 0.8972 (−10.28%) |
| Redirect wait cycles (+1) | 2,644.6 | 139.2 | 51.8 |
| Complete BTC hits (+1) / eligible restarts (+1) | — | 878.5 / 1,294.5 | 1,149.9 / 1,294.5 |
| Incomplete fills cancelled (+1) | — | 2.4 | 2.4 |
| Post-replay continuation wait cycles (+1) | — | 1.124 | 1.124 |

Eligible restarts include each program's initial stream, hence 22 more than the
retired-redirect count. Admission requires two consumed words: the ideal target-only
cache simulation is not the actual hardware hit rate. Timing changes also affect
cache/arbiter/refresh overlap, so cycle savings are not exactly the difference
of redirect-wait counters. The near-1 continuation-wait geomean rules out simply
moving most target bubbles to the first downstream word.

| Program | Disabled cycles | 4-entry cycles | 8-entry cycles |
| --- | ---: | ---: | ---: |
| long-quicksort | 1,562,747 | 1,385,568 | 1,378,815 |
| medium-binary-search | 225,385 | 192,696 | 185,544 |
| medium-dijkstra | 221,322 | 206,346 | 182,592 |
| frame-particles | 249,410 | 248,397 | 233,013 |
| frame-sprite-batch | 938,144 | 764,250 | 764,206 |

Four entries remain the default. Eight save another 1.40% on the geomean cycle ratio
(0.9860 versus four entries); the exact fitted costs are recorded only in the
milestone row above and generated reports.
Both builds pass 54 MHz constraints, but timing margin is narrow: the four-entry
limiter is the core GPR write-data path; the eight-entry limiter reaches the BTC
LRU write enable from the fetch queue head. These are fitted results, not physical
board validation or a guarantee that future placement changes will preserve margin.

Validation: workspace tests (498 passed), strict workspace clippy, layering,
source hygiene, documentation checks, reproducible boot packaging, all Icarus
hardware groups including Flash boot, the required CPU emulator/RTL tests and
system-level co-simulation, plus bounded independent full-address/data scoreboards
and RTL traces for 0/4/8 entries. Directed cases cover simultaneous restart/hit
acceptance, PC wrap, segment/high-address distinction, cache-line crossing,
backpressure/full reservations, stalled continuation, incomplete/error fills,
exact LRU eviction, reset/flush races, instruction-data changes after invalidation,
and stale responses surviving repeated redirects with same-cycle FIFO slot reuse.
Both capacities passed full-system Gowin PnR and `--check-existing` artifact audits.
No physical-board programming was performed; no commit or post-commit ledger row
was made.

The default four-entry build was restored after the eight-entry comparison.

## GPU viewport cache interface closure (2026-09-26)

This closure follows the generated-Flash validation in `a831c9e`. Covered pixels previously read a
64-bit cache beat before replacing one RGB565 lane. Four explicit true-dual-port 512x16
DPBs now expose separate memory and render ports, with bank selection `(x + 2*y) mod 4`.
Odd-row beat halves are swapped on refill and synchronous clean reads. A pixel of the
acquired tile writes one render bank directly; uncovered lanes retain the LOAD contents.

The 114-bit pixel/marker record carries draw epoch, triangle ID, tile ID, coordinates,
and RGB565. A marker waits for the matching cache retirement ACK after all preceding
pixels reach the cache. `END` separately drains dirty entries before submission
completion: triangle retirement alone does not make framebuffer writes SDRAM-visible.
Ready/valid prefetch acquisition admits K=1 tile; tile-end ordering pins the live tile
until its pixels are consumed. Refill/clean remain blocking. Geometry, barycentrics,
varying interpolation, and render/refill concurrency remain future work.

The triangle-only S2 application clears both slots to black once, then reuses 24-word
SET_TARGET/TRIANGLE/END buffers. Background gradients and wave updates no longer run.
Removing this firmware does not remove the GPU's temporary gradient command hardware.

Strengthening the Flash RTL regression to check every pixel of both slots, starting
from nonzero sentinels and retaining payload guards, reproduced a missing pixel at
(83,48). The GPU advanced clean beat zero on request acceptance, while SharedSdramPort
requires every long-write beat on data-ready. Its host model and standalone responder
had copied the same incorrect rule; differential equality and a single interior pixel
therefore missed the integration error. GPU RTL, Rust model, host memory, and trace
responder now hold beat zero through request acceptance. The adapter protocol is unchanged.
Independent full-frame oracles must complement model/RTL agreement.

Timing closure registers edge initialization before its array write, updates FIFO
counts once for mutually exclusive push/pop, and drives render readiness from the
registered acquired tile. Quad coverage and cursor-advance decisions register before
a separate FIFO/edge commit cycle. Quad production takes two clocks per quad, excluding
initialization and stalls. This trades scan throughput for a shorter control path.
The firmware reduction, handshake repair, and quad retiming changed different parts
of the system; a smaller application does not imply an easier physical FPGA layout.

Default congestion-driven routing failed despite removal of the quad critical paths.
The full-system project uses Gowin place algorithm 1 (additional placement effort)
and route algorithm 1 (timing-driven routing), retaining the 54-MHz constraint and
mandatory setup/hold audit. The final fit passes; the limiting path is CPU state to
GPR write data, followed by raster vertex Y to AABB register control. Current fitted
numbers and validation boundary live only in
[architecture.md](architecture.md#current-fitted-result-and-validation-boundary).
The setup margin is small; this fit is closure evidence, not broad timing headroom.

Validation: 725 workspace tests pass, 62 are ignored; strict workspace Clippy,
formatting, layering, source hygiene, and documentation checks pass. The five raster
RTL tests, five GPU integration tests, 26 CPU emulator/RTL tests, two system co-sims,
and both generated-image Flash RTL tests pass. Boot materialization and independent
repacking agree byte for byte. The 26-scene GPU suite checks 2,496,000 pixels against
independent integer pixel-center/top-left edges, exact pixel/ACK conservation, guards,
LOAD/CLEAR preservation, alias eviction, boundaries, winding, degenerate/subpixel
triangles, empty draws, and seeded scenes with independently stalled ports. Terminal
errors are injected at all 36 command-read, tile-refill, and tile-clean beat positions.

An isolated comparison recompiles `54950b6` with the same memory throttling and requires
identical output images:

| Scene | Old cycles | Current cycles | Current / old |
| --- | ---: | ---: | ---: |
| Shared edge | 5,303 | 2,272 | 0.428 |
| Alias eviction | 33,533 | 13,568 | 0.405 |
| Wide triangle | 229,344 | 87,363 | 0.381 |

These are isolated workloads, not display-contention or board throughput. The historical
source uses its request-consumes-first-beat responder; the current source consumes all
long-write beats on data-ready. The comparison does not establish that the historical
source was pixel-correct through the full-system adapter.

Physical integration: the triangle-only complete image passed Flash Program/Verify at
`0x000000`, including its generated boot package at `0x100000`, and audited SRAM loading.
The first UART capture was empty. Restarting BL616 recovered the transport; the next
capture contains 499 valid S2 `0x0b` success frames, with no failure, wrong-test, checksum,
or boot-error frames. After the requested power cycle the user confirmed normal HDMI;
an observation-only capture passed another 498 S2 success frames with no errors.
The current image is retained in complete Flash; the user subsequently powered the board off.

### Timing follow-up: operand selection and cross-module sharing

The limiting path is more specific than a generic CPU writeback path: CPU state selects
the B-register address, crosses the asynchronous register-read/bypass mux and the shared
device-write bus, then traverses a combinational LUT named `u_gpu/staging_bad_s11`
before returning to CPU writeback. The device-write bit on this path has fanout 80.
GPU readback in the source depends on registered counters/status, not on live write
data. The mapped LUT name and source isolation therefore suggest cross-module sharing
of a common reduction expression, rather than a functional device read/write loop.
The encrypted mapped netlist prevents confirming that LUT's exact Boolean expression;
this remains a hypothesis to test, not a proven operation-level attribution.

CPU B-address selection includes an Execute-state test for LOAD/STORE, although the
register index can be decoded when a new instruction is accepted. The first candidate
is to capture that index alongside the instruction at all three acceptance sites,
preserving register forwarding, prefix handling, memory/device barriers, and existing
retirement cycles. This can remove state-dependent operand selection from the read
path without adding an instruction cycle; its actual fit benefit is still unmeasured.
A separate controlled synthesis experiment should test whether isolating the GPU
staging reduction removes the long cross-module excursion. Do not add false-path
constraints based only on the suspicious mapped path or instruction exclusivity.

The next raster candidate is the AABB setup stage: its serial min/max selection,
viewport clamp, rectangle-valid comparison, and enabled register update occur in one
cycle. Split extrema calculation from clamp/valid/commit while preserving signed
comparisons and outward even/odd bounds. Setup runs once per triangle, so additional
setup cycles should affect large-triangle throughput less than slowing quad production;
this expected tradeoff also requires measurement. Current routing dominates both
paths; detailed fitted delays remain in the current architecture section.

These are ordered investigation candidates, not additional implemented changes.
Compare each candidate against the verified baseline with identical project options,
mandatory CPU/system co-simulation, full-frame GPU/Flash oracles, and full-system PnR.
Keep the two changes separate so their resource and timing effects remain attributable.

### Historical raster synthesis probe (2026-09-25)

GowinSynthesis `run syn` on GW2AR-18C produced these standalone prototype measurements:

| Top-level boundary | Logic | Registers | BSRAM | DSP |
| --- | ---: | ---: | ---: | ---: |
| Viewport raster core | 3,871 | 2,947 | 1 | 4 |
| Viewport serial-pixel wrapper | 3,618 | 2,949 | 1 | 4 |
| Full-geometry prototype | 17,091 | 7,524 | 45 | 11 |

These predate the integrated cache/ACK and quad timing changes. Different top-level
outputs prune different unused logic, so the wrapper delta is not a system resource
saving. The full-geometry prototype also duplicates wide setup records in tile storage;
its large memory cost cannot be attributed entirely to clipping or projection. Keep
viewport specialization and compact inter-stage records as design choices, then measure
the composed system. Standalone synthesis supplies neither a fitted resource delta nor
a timing/board conclusion. The raw probe is retired; these conclusions supersede it.

## CPU B-source and raster AABB timing closure (2026-09-27)

Starting from the board-validated `11729ac`, the scalar B-address selection now decodes
on successful instruction acceptance instead of using Execute state ahead of the GPR
read port. FetchRequest bypass, FetchResponse, and overlapped Execute acceptance capture
the same four-bit address: field D for LOAD/STORE, field B otherwise. Reset clears it;
hold and fetch errors do not accept a new address. Pending-write forwarding, retirement,
prefix handling, memory/device barriers, and instruction cycle counts are unchanged.
Data on an inactive device bus need not match the former state-dependent read selection.

A second, independently measured change splits raster AABB setup into extrema selection
and clamp/valid/commit. Signed s12.4 coordinates are floored to signed 12-bit pixel
coordinates before selecting extrema. Floor is monotone, so this produces the same
bounds as flooring the original raw extrema, including negative and subpixel vertices.
The next cycle clamps the bounds and retains outward even/odd rounding. This costs one
setup cycle per triangle; quad production, cache acquisition, pixels, and marker ordering
are unchanged. It applies to both viewport specialization and the full-geometry probe.

Both experiments used the same 54/108-MHz clocks, constraints, and Gowin place/route
algorithms 1. No timing exceptions were added. These are changes between measured fits:

| Candidate | Comparison | Logic delta | Register delta | CPU Fmax delta | Worst setup slack delta |
| --- | --- | ---: | ---: | ---: | ---: |
| B-source predecode | Versus `11729ac` | -76 | +3 | +4.174 MHz | +1.325 ns |
| Staged AABB | Versus B-source alone | +90 | +49 | +0.953 MHz | +0.277 ns |

The B-source-only fit moved the first setup path to tile-corner edge selection feeding
a DSP operand (1.345 ns slack), followed by D-cache state/tag/dirty control (1.440 ns).
The selected combined fit is now limited by D-cache state through tag-read address,
asynchronous tag comparison, hit-way selection, and dirty-array write enable. Neither
the earlier CPU B-address path nor raster AABB is first. Absolute current resources,
delays, and clock results live in [architecture.md](architecture.md#current-fitted-result-and-validation-boundary).
The suspicious cross-module staging LUT is not needed for this improvement; its exact
Boolean attribution remains unproven and the separate isolation experiment is deferred.

The independent image/transaction tests pass for all 26 full-screen scenes and all 36
error beat positions. The five raster tests, 26 CPU RTL tests, two system co-sims, and
both full-image Flash RTL tests pass. All 20 aggregate hardware validation steps pass,
including 725 workspace tests, strict Clippy, layering/hygiene/docs, reproducible boot
packing, full-system PnR, and artifact audits; formatting also passes. Isolated throughput
changes only slightly relative to the B-source-only fit:

| Scene | B-source-only cycles | Combined cycles |
| --- | ---: | ---: |
| Shared edge | 2,272 | 2,275 |
| Alias eviction | 13,568 | 13,575 |
| Wide triangle | 87,363 | 87,357 |

The extra setup clock can move memory-stall phase, so total cycle changes are not
necessarily exactly one per triangle. These remain isolated workloads, not board or
display-contention throughput. The frozen CPU workload and model are unchanged; core
and composed-system cycle traces still match. No suite revision is introduced.

Both changes are retained. Firmware remains the black-background triangle demo.
The selected source fingerprint `52bcd5d7c3ab8911` and bitstream fingerprint
`aaf141b95128d653` passed complete Flash Program/Verify at `0x000000`, with the
boot package at `0x100000`, followed by audited SRAM loading. UART captured 3,984 bytes:
498 S2 (`0x0b`) success frames and zero failure, wrong-test, bad-checksum, or boot-error
frames. BL616 recovery was unnecessary. This image now remains in Flash; its cold-boot
UART and user HDMI confirmation are pending. Geometry/varying and concurrent refill/render remain open.
The next timing investigation should target the measured D-cache address/tag/dirty
control path and tile-corner operand selection, with each change tested independently.

## GPU raster and framebuffer-control Logic closure (2026-09-27)

The overnight investigation keeps full-GPU requirements ahead of demo-only resource
scores. Four physical true-dual-port framebuffer banks, LOAD/CLEAR preservation,
dirty/error completion, epoch/triangle ACK, full-geometry clip/fan/setup queues,
and the independent memory masters remain. Viewport single-triangle ownership
removes duplicate wide setup/job copies; K=1 needs one compact pending job rather
than a queue. Signed edge precision is narrowed only with an explicit bound.

The additional scanline implementation uses two-row bands, shared edge DSPs for
left-span testing, and right-tail rejection. Both traversals have one- and
two-pixel coverage-generation rates; there is no four-pixel/clock implementation.
Tile is selected at both rates because scanline costs more raster Logic and its
row-major sweep causes repeated refill/dirty eviction in the tile-linear cache.
The faster tile choice is retained as default. Measured resources, producer
averages, full-frame cache transactions, timing owners, rejected alternatives,
whole-system attribution and reproduction are recorded once in
[gpu-raster-comparison.md](gpu-raster-comparison.md).

Actual memory inference matters more than register count. Coordinate simplification
made automatic quad FIFO mapping expand into FFs; explicitly keeping BSRAM restores
the lower-Logic implementation. An aggressive setup-record alias reduces FF but
increases Logic and is rejected. Cache tags share one read port, and command/list
lines keep separate contents while sharing one eight-deep RAM16 array and port.
Reserved payload bits remain rejection predicates. Cache clean reads now explicitly
enable the memory port, removing the inactive-port collision-avoidance address mux.
Command extent and physical-address arithmetic retain all legal maximum counts
and empty-list semantics, checked by boundary regressions.

The four candidate fits pass the unchanged 54/108-MHz constraints. All six raster
RTL tests and eight GPU integration tests pass, including 40 scenes with three
stall patterns, 26 full images per candidate, every read/write fault beat,
143 individual reserved bits, stale-tag reset, maximum command extent and high
address rejection. The 26 CPU and two system co-simulations also pass. Final
aggregate artifact and physical evidence belongs to the current
[architecture validation boundary](architecture.md#current-fitted-result-and-validation-boundary).
Earlier framebuffer prefetch for future pixel processing is deliberately deferred;
the existing K=1 acquisition is retained. No frozen CPU suite revision is introduced.

Commit `6149698` passed the complete 20-step hardware validation, including 725
workspace tests and both full-image Flash RTL tests. Its post-commit rebuild reproduces
the candidate resources/timing and archives the reports; the frozen 22-program suite
matches `11729ac` in every CSV field except commit, with unchanged suite/schema hashes.
Parallel test runs now allocate distinct raster/GPU simulation directories; the
full-system diagnostic testbench observes the updated logical payload and line storage.

Only the audited post-commit image was programmed: source fingerprint
`9773b306c6894463`, bitstream fingerprint `e88e600dc255a42a`, bitstream SHA-256
`3751beb3596811dae05f79e0da1153c843791d0884166d6b407c09864d2c3321`.
SRAM-only loading passed 499 strict S2 `0x0b` success frames. Complete Flash
Program/Verify at `0x000000`, including the generated boot package at `0x100000`,
then another SRAM load passed 499 further S2 success frames. Both captures have zero
failure, wrong-test, checksum or boot-error frames; no BL616 restart was needed.
The complete image SHA-256 is
`22b4b8460b7d9f2851c06c85370a1c7453e2e40cc23eb09d4c64329373df6ecf`.
The optimized default is now retained in both Flash and SRAM. These are loaded-image
UART results; user power-cycle, cold-boot UART and HDMI observation remain pending.

## Display four-row buffering and pixel-pair FIFO (2026-09-27)

The complete upgrade also replaces the original single-BSRAM, two-row scanout buffer
with two 512x32 banks and four rows, published/released in two-row groups. Each tile's
two adjacent rows are fetched as two fixed 32-byte transactions. Every 64-bit response
writes both banks directly, removing the original 256-bit capture and eight-cycle drain.
Both banks contain linear-to-sRGB tables; a staged format bit follows NEXT_SWAP atomically.
The reset-default encoded format preserves the existing applications' pixel interpretation.
The separate adapter buffer for legacy writes into SDRAM remains unchanged.

The complete upgrade comparison (archived work-1 report) measures
the superseded direct-handoff candidate against the original same-mode build taken before
these edits. The selected FIFO build is in the archived restoration report below. Other-client wait
estimates remain conditional on controller response timing; refresh/contention and board validation are
not established by these offline checks.

The scanout conversion pipeline retains the original four-entry, 48-bit RAM16 FIFO
as a separate inferred-memory leaf. Conversion starts every four pixel clocks when
the occupancy guard permits and begins sixteen clocks before the framebuffer window.
Scanout pops one pair every four clocks in 2x or six in 3x, retaining it in one output
register for the remaining repeats. This is the original FIFO structure, not the
narrower serialized-channel experiment.

Mutually exclusive Cargo features `display-2x` and `display-3x` select the schedule,
video timing and PLL together; neither flag preserves the default 2x mode. Full-frame
pixel checks cover both modes, both color formats, bank/row/group boundaries and
pixel output alignment. Restoration checks and fitted artifacts are linked in the
FIFO restoration report (archived work-1 report).
No new physical-board validation was performed.

The original top-level resource assertion still expected the single display BSRAM;
it now expects the fitted total for both banks. The selected FIFO passes the complete
hardware validation, including both complete Flash RTL tests covering the composed
boot, SDRAM, GPU render and display request path beyond the isolated scanout tests.
Both required co-simulation layers and both pixel modes also pass.

Measured display savings and the full-system remapping limitation are kept in the
generated comparison (archived work-1 report). The 2x
display hierarchy shrinks while the full-system total grows because other synthesis
hierarchies map differently; no SDRAM-adapter source was changed. The 3x fit is a
separate video-mode characterization, not a same-mode FIFO comparison.

The follow-up RAM16 packing study (archived work-1 report)
reproduces the previous FIFO fit with a byte-identical synthesis hierarchy report.
Serializing each pair's channels into a narrower memory retains the queue capacity
and passes both modes' pixel checks, but its full-system fit is larger. The user
selected the original FIFO for its lower whole-system fit. Fewer RAM16 cells alone
do not preserve the old SDRAM-adapter mapping. Direct handoff remains a measured,
superseded experiment rather than the current scanout implementation.

The work-1 comparison/restoration/packing reports cited above are preserved in the
local SHA256-manifested worktree archive at commit `5545c4e`; the agent guide indexes
that archive. Generated reports are evidence artifacts rather than maintained specs.

## Accepted framebuffer component, 2026-09-27

The [eight-DPB framebuffer contract](framebuffer-cache.md) replaces physical tile groups and
a numerical color queue with fixed memory/render ports and source ownership through the final
write. The independent component and reproducible vendor tests are committed together; its
resource/throughput table is the sole home for these measurements. Earlier queue, shared-pool
and array alternatives remain in local record `gpu-merger-study-2026-09-27`. The final component
also verifies zero-byte writes do not steal concurrent read addresses. This does not change the
production GPU export, boot images or fitted-system accounting. Controller/sector/lease/cleaner
integration and real depth/blend arithmetic remain pending; no new board validation is claimed.

## Standalone framebuffer execution lanes, 2026-09-27

The [framebuffer component](framebuffer-cache.md#measured-component-boundary) now executes
pointwise operations in physical bank order. One latched lane-control bit converts the held
RGBA8888/Z16 source and completion mask, removing wide old-value and render-write permutations.
The matched full-source-width probe retains all alpha/color bits and preserves word-level
conflict checks; its fitted results live only in the component resource table. Extra memory
response registers and one-hot selection cost more LUTs; broader sector blocking also stalls
legitimate accesses to other words in the active sector, so these alternatives were rejected.

Six native tests cover seven configurations/callbacks/delays and five independently reproduced
faults, including lane ordering. Same-sector different-word access and same-tile different-sector
streams retain concurrency. All 725 workspace tests, workspace Clippy, and the mandatory CPU/system
co-simulations (26/2) passed. Local record `gpu-framebuffer-resource-2026-09-27` retains source hashes,
vendor models, routed reports, rejected candidates and validation logs. This remains a standalone
component change: no production GPU export, frozen CPU suite or board-validation claim changes.

## Production framebuffer attachment to display work-1, 2026-09-27

The [eight-DPB storage and quad owner](framebuffer-cache.md#production-attachment)
is attached to the production GPU on work-1's four-row display/sRGB baseline.
Whole covered quads retain the raster FIFO head through actual masked writes;
the serial pixel splitter and former four-bank array are replaced. Existing tags,
color LOAD/CLEAR/clean, K=1 blocking acquisition and ordered marker/END behavior
are retained. Local Z initializes to far depth because the current command ABI
has no depth surface binding. The four Z DPBs are retained in synthesis, so the
full-system fit includes the accepted physical storage. Depth/blend arithmetic
and concurrent sector scheduling remain separate work.

Ten GPU integration tests pass, including 26 scenes with an independent complete
image oracle, transactions, pixel/ACK conservation, faults and reset. An actual
vendor-DPB production run agrees with the reference; omitting depth initialization
reproduces a semantic audit failure. Full-system resource results belong only to
the [current architecture result](architecture.md#current-fitted-result-and-validation-boundary).
Local record `gpu-display-framebuffer-2026-09-27` preserves the matched production
baseline, integration sources and validation reports. Geometry/frontend and SDRAM
branch changes are outside this integration. No new board validation is claimed.

## Non-GPU Logic and data-flow audit, 2026-09-28

The fetch queue stores 16-bit offsets for stream-owned queue and request slots;
the complete stream address and redirect invalidation still protect segment changes.
BTC entries retain physical tags. A delayed same-offset response across two segment
redirects and a PC wrap regression pass; preserving stale request ownership deliberately
reproduces a failure in the new regression.

The arbiter broadcasts read payload and selects only response-valid/error/last by owner.
Its arbitration policy, transaction lock and fair rotation are unchanged. I/D-cache tags
each use one DPB, sharing the existing data lookup stage. D-cache write-back assembles
its address during the existing capture stage. Independent cache models retain their
original external cycle behavior, including invalidation and line-copy maintenance.

Matched whole-system results belong to the [architecture resource table](architecture.md#current-fitted-result-and-validation-boundary).
Local record `cpu-v3-non-gpu-logic-2026-09-27` contains source-frozen comparisons,
resource hierarchy, vendor-DPB checks, rejected RAM16/arbitration/staging alternatives,
and a rendered data-flow diagram. Reducing FF or expression count alone often increased
whole-system Logic or failed timing. Cache valid RAM16, parity data DPBs, GPR RAM16,
source-held GPU writes and the single-pair gearbox remain the useful earlier patterns.
GPU RTL and physical memory timing constraints are unchanged; no new board proof is claimed.

## 2026-09-28 - Source-held D-cache writeback

The cache-to-adapter interface previously advanced fixed-line data without per-beat
backpressure, forcing a duplicate four-beat adapter FF buffer. All line writes now
consume data only on ready, including beat zero after address acceptance. D-cache
keeps its line locked in the existing parity DPBs, launches the next synchronous read
on consumption, and removes its first-beat FF copy. The arbiter forwards ready to
the accepted owner and shares request/owner payload source qualification.

Early errors transition from STREAM to the existing held-response error handler;
clean, invalidate, eviction and line-copy still wait for completion. The SystemSim
and RTL service goldens now preload and stream without a complete-line copy; their
command latencies remain abstract. GPU hardware and 54/108 MHz clocks are unchanged.

The [architecture table](architecture.md#current-fitted-result-and-validation-boundary)
is the current fitted-number source. Local record `cpu-v3-dcache-stream-writeback-2026-09-28`
preserves both ablation fits, hierarchy, source/constraints, a rendered data-flow diagram,
and native/vendor-DPB stall and fault evidence. The regression checks request stalls,
all data-beat stall positions, consecutive ready, and errors before/mid/after data;
a deliberately advancing stalled-address mutant fails. Workspace, CPU/system co-sim,
GPU integration, complete Flash RTL boot, hardware validation and routed artifact
audit pass. No new physical-board proof is claimed.

## 2026-09-28 — CPU/cache architecture consolidation

Mutually exclusive scalar/vector arithmetic now shares one FPU lane controller,
ALU and result-commit path. Integer register/immediate arithmetic and comparisons
use common operands/results while retaining the sequential one-instruction-per-cycle
path. Fetch reconstructs ordered addresses from one head cursor; stale-response
ownership and BTC replay remain independent. Display retains strict priority and
the other six memory clients rotate at transaction boundaries with six total state bits.

D-cache metadata uses spare bits of its existing tag DPB for valid, dirty and victim.
A single pending scan candidate overlaps maintenance with source-held write-back;
a conservative dirty hint skips repeated empty full cleans. Capacity, associativity,
data-bank count and parallel-way hit timing are unchanged. LCOPY adds one metadata
refresh cycle after destination invalidation. Independent goldens also exposed an
old functional-model victim-selection error in cold-source LCOPY and a standalone
held-request acceptance error during scrub; both are repaired with regressions.

Tag-first, sequential-way data lookup, extra data DPBs, post-refill store reuse and
LCOPY comparator sharing were measured but did not improve the selected final
area/performance tradeoff. Source-held blocking FST lost substantial transform/store
overlap and was not adopted. A shared I/D miss engine was structurally reviewed;
independent pending/response state and existing single-owner memory service limit
its remaining opportunity. GPU implementation and SDRAM backend sources are unchanged.

Current fitted values and acceptance are in the
[architecture table](architecture.md#current-fitted-result-and-validation-boundary).
Local record `cpu-v3-architecture-logic-2026-09-28` preserves matched source variants,
whole-system fits, native/vendor goldens, FPU/integer differentials, per-program
performance, dense/sparse clean timing and the selected production source audit.
The complete offline validation passes; this unit has no new physical-board proof.

## 2026-09-28 — Native SDRAM integration

The full CPU V3 system uses the CL2/RCD2/RP2/RFC9 native controller at 108 MHz.
`BANK_BIT=5` distributes consecutive aligned 128-byte sectors over four banks;
the controller owns row state, refresh and physical command timing. The existing
one-owner arbiter and 54-MHz cache streams meet it through a two-pair 64/32-bit
bridge. Each 64-bit source beat advances only when accepted, and the bridge
assembles ordered read pairs and clears its transaction token on reset. The
single-client adapter converts masked 16-bit accesses and 32/64/128-byte lines
to native descriptors. Because the arbiter presents only one outstanding
descriptor, the controller's optional next-request chaining remains disabled
at this system boundary.

The 99-MHz CL2 pin-level model checks four consecutive bank-striped sectors,
masked scalar writes, read ordering, refresh and reset during a read. The
full Flash-boot RTL test, 23 ignored system RTL tests, CPU and system co-sims,
workspace tests, strict Clippy and generated bitstream audit pass. The final
full-system fit uses 12,304 Logic, 50 RAM16 and 20 BSRAM; the 54-MHz CPU and
108-MHz controller clocks close at fitted limits of 55.547 and 136.790 MHz,
respectively, with no setup or hold violations. Board UART validation of this
integrated image remains pending.

## 2026-10-07 — Two-stage FPU multiplier

On base `e583cfa`, removing the last product/tag/valid register from the shared
36x36 pipe advances MUL, VMUL, VMULS, DOT, DOTADD and DOTSTORE by one beat,
with II=1 and the same signed Q16.16/64-bit wrapping arithmetic. Outstanding
counts still retain ownership through the final return. The special path
registers only `product[49:32]`, the low 18 bits of the shifted SINCOS phase,
so dual/single SINCOS, RCP and RSQRT retain their existing schedules.
The integer multiplier is unchanged.

The leaf tests check exact return/write/ACC timing, randomized products,
in-place A/B destinations, VMULS scalar aliasing, and partial-write abort.
The pipe test checks the positive signed-36 SINCOS constant and abort with
both stages occupied, including the first edge after abort is released.
Removing either combinational abort gating or pending-valid clearing makes
the strengthened pipe test fail. This closes the old test's gap: its extra
wait before abort allowed the shortened pipe to drain before cancellation.

The frozen 22-program set and CSV schema are unchanged. Program sizes,
retired instructions and retired words match in every row. The measured
metric is emulator execution cycles at the unchanged clock configuration,
including the suite's existing initialization and service-model behavior.
Geometric mean of per-program after/before ratios: **0.991765** across all
22 programs (0.823% fewer cycles), and **0.981973** across the nine `fpu-*`
programs plus `frame-particles` (1.803% fewer cycles). No program regresses.

| Program | Before cycles | After cycles | Delta |
| --- | ---: | ---: | ---: |
| fpu-medium-bezier | 18,568 | 17,672 | -896 |
| fpu-medium-mandelbrot | 1,039,837 | 999,971 | -39,866 |
| fpu-medium-normalize-batch | 55,701 | 55,189 | -512 |
| fpu-medium-transform4x4 | 39,833 | 39,321 | -512 |
| fpu-short-horner | 1,030 | 1,003 | -27 |
| fpu-short-sincos | 1,238 | 1,238 | 0 |
| fpu-short-splat | 1,591 | 1,575 | -16 |
| fpu-stress-interleave | 3,433 | 3,369 | -64 |
| fpu-stress-spill | 1,203 | 1,191 | -12 |
| frame-particles | 452,286 | 449,727 | -2,559 |
| frame-sprite-batch | 757,185 | 757,185 | 0 |
| frame-tile-world | 640,076 | 640,076 | 0 |
| long-quicksort | 1,385,097 | 1,385,097 | 0 |
| long-streaming-mix | 484,592 | 484,592 | 0 |
| medium-binary-search | 192,687 | 192,687 | 0 |
| medium-dijkstra | 206,442 | 206,442 | 0 |
| medium-matrix-multiply | 139,213 | 139,213 | 0 |
| medium-sieve | 64,213 | 64,213 | 0 |
| short-fizzbuzz | 2,808 | 2,808 | 0 |
| short-sort-insertion | 4,201 | 4,201 | 0 |
| short-substring-match | 3,956 | 3,956 | 0 |
| short-vec-heap | 53,474 | 53,474 | 0 |

The fitted resource/timing values live only in the
[development-fit table](architecture.md#current-fitted-result-and-validation-boundary).
The two baseline fits and two candidate fits agree within each variant.
The narrower phase register produces the same fit as the earlier wider
register: synthesis already removed its unused bits. CPU Fmax improvement
is a routed whole-system result; the runtime clock is unchanged and the
SDRAM controller's fitted limit decreases while still meeting its constraint.

Independent review passes 1,345 workspace tests, strict workspace Clippy,
31 CPU RTL/co-simulation tests, two system co-simulations, all six Icarus
validation groups, generated boot-image repacking, whole-system PnR and the
generated-source/bitstream audit. A fresh 22-program candidate run matches
the original candidate in every exported metric. The direct pipe test passes
1,492 checks and rejects both abort mutants. Rust formatting, diff, layering,
source hygiene and the four changed Markdown files pass their checks.
An isolated Git archive of exact base `e583cfa` independently reproduces the
baseline fit and all 22 baseline CSV rows across every exported metric.
Candidate and baseline SDC/CST hashes match. The archived before/after fits
are therefore corroborated by fresh runs with recorded source identity.
The full documentation checker still reports the same 18 missing GPU-artifact
links as unmodified HEAD; consequently the combined `-Mode all` command
stops at that existing issue, and its remaining stages were run separately.

Raw before/candidate reports remain in the task worktree under
`target/mulpipe-pnr/{before,before-r2,after,after-narrow}/`; benchmark CSVs
are `target/mulpipe-baseline.csv` and `target/mulpipe-final.csv`.
Both CSVs record base HEAD `e583cfa` with configuration `current`; that
metadata alone does not identify the uncommitted source variant.
Independent review receipts and the final source identity belong under
`target/mulpipe-review/`. These raw files are pre-commit experiments. The finalized
implementation is committed as `6849df7`; its post-commit full-system fit and
22-program run are recorded in the project's local `resources.csv` and
`performance.csv`. The performance row references
`records/performance/2026-10-07-6849df7-stage907.csv`.

### Functional review, 2026-10-09

The development checkout at `a0fe042` contains the committed two-stage multiplier
and the SINCOS phase register. Bounded Rust checks pin the shared return to `T2`,
single write to `T6`, dual writes to `T6/T7`, and the corresponding 7/8 busy beats.
Cancellation is checked from issue through the first write, followed immediately
by a new instruction with a different operand and destination. The numerical
reference is the independent `lut::sincos_q16` oracle.

The review passes 236 CPU functional tests, 31 CPU RTL/co-simulation tests and
two full-system co-simulations. Runtime CPU/FPU source matches `6849df7`; the
new changes strengthen test coverage and clarify the existing timing contract.
Resource and performance evidence remains attached to the original committed
implementation and its ledger rows above.

## 2026-10-09 — Shared integer shifter and scalar memory storage

The original independent cloud experiment starts at published `code-v0.3-dev` commit
`8717eb71c564821c4a0ebd91899a8d30e43a87fd`; no GPU source, ISA, clock,
cache policy, arbitration order or SDRAM pin/refresh policy changes. The matched
local integrated resource and timing measurements have one current home in
[architecture](architecture.md#current-fitted-result-and-validation-boundary).

### Contracts and implementation

The in-order integer core consumes one shift result per Execute cycle. Six
separate register/immediate and left/logical-right/arithmetic-right expressions
are therefore unnecessary. A count mux and reversible 16-bit wiring share one
17-bit signed right-shift barrel. The extra bit controls sign versus zero fill;
the `>>>` assignment is independently signed, preserving the Verilog signedness
rule. The instruction decoder still rejects the same reserved forms. No register,
state, handshake or execution cycle is added.

A native scalar read returns one 32-bit word, of which the adapter exposes only
one selected 16-bit halfword. Previously the adapter held that word in a second
payload register before copying the halfword to its response register. It now
captures the selected halfword directly in the response register and waits for
both read-data and native completion before asserting valid. Either event may
arrive first or both may arrive together. A backpressured response still holds
until acceptance. Scalar writes now hold their single halfword unshifted, with
lane placement performed from the saved address bit. Line streams, source-held
write beats, early grants and the opt-in grouped mode retain their schedules.
The Rust adapter oracle reflects the earlier unqualified payload update; this
has no successful-response or producer/consumer semantic change.

The actual fitted system enables `EARLY_GRANT=1` and `PREPARE_NEXT=1`, despite
older prose describing serial production. These settings are retained. The
arbiter's irrevocable reserved owner is necessary for that existing successor
slot. The bridge's two write pairs absorb the related-clock transport phase and
supply continuous 32-bit SDRAM words without retaining a whole line. Removing
these mechanisms was not justified by the real contracts and was not attempted.

### Verification

- Exhaustive baseline-versus-candidate combinational RTL comparison: all
  16,777,216 combinations of 16-bit operand, sixteen decoder values and sixteen
  count pairs agree, including all reserved forms and deliberately different
  register/immediate count sources.
- The core RTL testbench adds 768 actual instruction cases: all six forms,
  all sixteen counts and eight sign/boundary/alternating operands; the following
  MOV/HALT checks forwarding and seven-word retirement.
- All 31 CPU V3 explicit RTL/co-simulation tests pass, and both system
  co-simulation tests pass after the final adapter change.
- The adapter test adds both scalar-read lanes, completion before/with/after
  data, and held-response checks. These tests pass on the original adapter and
  the candidate, including an early-grant-enabled candidate instance. Native
  bridge bank-striping, masking, reset and SDRAM pin-model simulation pass.
- All 52 regular Gowin vendor unit tests pass (six optional tests ignored).
- All 22 frozen release-mode emulator benchmark records are identical across
  baseline and candidate, including cycles, retirement, latency, traffic and
  refresh fields. This is emulator evidence; it is not a board benchmark or
  an RTL run of all 22 workloads.
- The complete release workspace regression passes: 1,372 tests pass, zero
  fail and 101 intentionally optional tests are ignored; required focused
  CPU/system/vendor RTL tests listed above are run explicitly. Strict workspace
  Clippy/all targets and the affected-crate check pass.
  The changed Rust file passes rustfmt. Workspace rustfmt retains an unrelated
  GPU module-order diff. Portable equivalents of layering/source-hygiene pass;
  documentation checks retain the same eighteen missing GPU/web/artifact links
  as the clean baseline. No new constraint-check failure is introduced.

### Original cloud fitting evidence

The original matched Gowin 1.9.11.03 Education fits are retained as a tool-specific
comparison; the local integration uses the fit in architecture above.

| Cloud fit | Baseline | Shared shifter only | Shared shifter and scalar storage |
| --- | ---: | ---: | ---: |
| Logic | 8,668 | 8,423 | 8,385 |
| Total registers / Logic FF | 3,450 / 3,366 | 3,450 / 3,366 | 3,401 / 3,316 |
| CPU fitted Fmax | 57.336 MHz | 55.715 MHz | 57.975 MHz |
| Controller fitted Fmax | 117.426 MHz | 127.190 MHz | 127.656 MHz |
| Worst setup slack / setup / hold endpoints | -2.495 ns / 53 / 0 | -2.511 ns / 53 / 0 | -2.483 ns / 53 / 0 |

Three whole-system fits compare baseline, shared shifter alone, and both changes
under Gowin 1.9.11.03 Education with identical target/constraints/options. All
successful internal-clock paths meet the unchanged runtime clock constraints,
while the same inherited SDRAM output setup failure family remains. Placement
changes internal Fmax even in untouched blocks; the measured margins are not
proof of a local critical-path fix.

The direct Linux `gw_sh` flow produced bitstreams without the repository
build-manifest writer. Its independent evidence file records SHA-256 hashes of
generated inputs and bitstreams; the integration below supplies the normal
repository build and artifact audit. The cloud experiment is offline evidence.

SDRAM output timing under the newer Linux release remains a separate tool and
CL2-interface investigation. Further area rounds should use a matched baseline
and preserve the actual simultaneous ownership and producer/sink contracts.

### Local integration verification

The archive patch applies directly to clean `8717eb7`; all 60 packaged evidence
files match their size/SHA-256 manifest. The production patch is retained, with
the current resource section updated to the local tool measurements.

Local release-mode verification passes: 288 CPU/vendor unit tests, all 31 CPU
RTL/co-simulation tests, both full-system co-simulations, adapter and native-bridge
RTL, and an explicit early-grant adapter instance. Regenerating the exhaustive
shifter harness from the actual baseline and patched core passes all 16,777,216
combinations. The core's 768 real-instruction cases remain in its RTL testbench.
Affected-crate/all-target strict Clippy, changed-file rustfmt, layering, source
hygiene, documentation and whitespace checks pass on Windows.

The local before/after project generation compares all 41 generated files; only
the core and scalar adapter change. CST, SDC, build options, boot assets, arbiter,
bridge, controller and GPU shell are byte-identical. Both fits use Gowin
1.9.8.11 Education with the same device, constraints and placement/routing options,
and pass setup/hold analysis and repository `--check-existing` auditing. The
different area savings in the cloud and local flows are recorded separately.

After committing, the standard resource and frozen-suite scripts regenerate
the committed system and record the exact source identity in the project's
resources.csv and performance.csv, retaining their selected raw evidence.

## 2026-10-11: D-cache final response slot

The requested refill halfword now writes the final CPU response register directly.
The separate refill-response payload is removed; response validity still waits for
the complete error-free line. A late error clears the captured value, write-allocate
stores publish zero, LCOPY publishes no CPU response, and a held response remains
stable until consumed. Emulator and RTL retain the original enabled-edge calendar.
The bounded response-slot test covers every requested halfword, dirty eviction,
refill faults, held responses and LCOPY. Actual-main CPU and system co-simulation
qualify the integrated change. Current matched fit and timing boundaries live in
[architecture.md](architecture.md#current-fitted-result-and-validation-boundary).

## 2026-10-11: Unified FPU product issuer and address cursors

One ProductPath now owns MUL, VMUL, VMULS, DOT, DOTADD and DOTSTORE issue/return
control. Existing six-bit base fields advance as RF address cursors only on an
enabled reading edge; this removes lane-times-stride address computation without
adding a cursor bank. T0 reads live bases, VMULS holds B, and six-bit wrap and
read-first alias behavior are unchanged. The shared arithmetic pipe, 64-bit DOT
accumulator and final 32-bit DOTSTORE slot retain their original precision and
calendar. Abort preserves completed MUL writes and the accumulated DOT prefix.
Independent old/new issuer replay and full FPU replay cover CE, aliasing, strides,
wrap and abort ages; actual-main CPU and system co-simulation qualify integration.
The original standalone issuers remain reference tests outside the selected
hardware graph. Resource metadata was calibrated to the fitted ProductPath, which
uses no DSP; arithmetic DSPs remain elsewhere. The removed MULTADD primitive is a
netlist fact; identifying its old lane-times-stride purpose is source-backed
inference. Current fit and evidence boundaries are linked
from [architecture.md](architecture.md#current-fitted-result-and-validation-boundary).

The shared scalar-ALU alternatives, including the single packed-add encoding,
were rejected after matched whole-system fits increased Logic without reducing
the mapped ALU count. The independent direct SDRAM event-capture candidate was
also rejected: removing payload staging increased Logic and introduced related
falling-controller-to-CPU setup failures. Neither experiment is in this change.

## 2026-10-11: Shared CPU wide multiplier

The existing two-stage signed-36 pipe now accepts CPU unsigned-16 integer
products and special-function LUT delta/residue products as well as ordinary
FPU products and SINCOS range reduction. The in-order core serializes these
owners; a fixed-priority input mux and reserved return-tag bits replace the two
independent narrow multipliers without a concurrent-client queue. The last
integer product remains available across held wait/commit states. Special LUT
bases travel beside the shared product, which feeds the original correction,
scale and sign logic directly into RF writeback.

Integer Execute-to-Commit, scalar/vector MUL and DOT schedules remain unchanged.
RCP/RSQRT write at T4; single SIN/COS at T7; dual SINCOS at T7/T8. Each special
instruction adds one enabled beat. Endpoint substitution, signed shifts,
normalization, saturation, fixed-point widths and architectural results retain
their original contract. Abort suppresses writes and clears pending product and
metadata ownership; an already committed first dual output is not rolled back.

The sealed implementation passes CPU unit tests, mandatory core/leaf and system
co-simulations, bounded mixed-owner/tag-product replay, integer wait/commit hold
and extended-age special abort/restart checks. Actual main raw sources match
that implementation and its freshly generated full-system export matches the
qualified executable bodies. The documentation successor changes no arithmetic.
Scoped formatting, layering, hygiene and documentation checks pass.

The matched pre-commit CPU/system candidate fits pass internal CPU timing in two
54-MHz placements; existing external SDRAM setup violations remain outside this
claim. No new board, generic performance or connected GPU result is implied.
The user explicitly waived post-commit resource and benchmark recording for this
batch. Earlier measured tables remain historical checkpoints; no new ledger
numbers are manufactured from the reused candidate evidence.

## 2026-10-17: CPU and cache area reduction

The I-cache producer, metadata layout, lookup consumer, invalidation sweep and
refill publication path are changed together. Its existing tag DPB now owns tag,
valid and replacement state; the separate selected RAM16 valid/victim owner and
private tag-only leaf are removed. Both ways still read alongside data in the
existing lookup stage. Normal-mode sweep writes hold old Q, so one local bit
records when the pending lookup's set was actually cleared, including restarted
sweeps and long response backpressure. Sparse preloaded validity is encoded into
the physical DPB words and verified before writes against the official vendor model.

The requested refill halfword now lands directly in the final I-cache response
slot. Publication still waits for the complete error-free line; a later fault
replaces any captured word with zero. All sixteen words, every error prefix,
refill gaps and held responses are checked through the public read-only boundary.

The fetch producer/consumer cursors share successors using accepted-address
equivalence; BTC replay remains separate from ordinary queue consumption. The
FPU scalar/vector lane selects arithmetic operands before one common wrapping
add/subtract path and shares integer-half rounding. These changes retain the
original independent cursor and numeric models, cache geometry, 16-bit CPU port,
retirement behavior and scalar/vector ALU execution calendar.

Matched complete-wrapper measurements select the combination. A 32-bit FST
capture-RAM candidate changes capture storage and the complete halfword drain,
but its lower FF count increases whole-system Logic; it is not adopted. That
result applies to that 32-bit organization. Two further complete candidates
change the synchronous FPR read/capture calendar, native RAM width and consumer
address order together: capture `2*len` halfwords into four RAM16 cells, then
drain in that same order. One selects the current FPR while held; the other
captures the high half of old Q alongside the low-half write, holding that high
half across a paused consumer. Both remove the four wide FF registers and the
centralized register/half selection network. Complete capture precedes retirement,
so later FPR overwrites and memory backpressure cannot alter the payload. Each
adds one FST capture edge per source register.

The initially smaller halfword fit omitted its hold cost and is explicitly
unqualified. Both complete pause-correct wrappers were compared against the
selected non-FST combination: neither reduces its whole-system Logic. Favorable
FF/CLS or clock results remain separate tradeoffs and do not override this
batch's Logic objective. Neither remains in active source. The appended-bit
carry spelling is also absent because it does not reduce the mapped ALU count.

The retained calendar-preserving batch passes isolated CPU/system co-simulation
and matches every exported per-program metric in the archived 22-program base.
FST candidates have separate bounded qualification, including holds on every
capture half and a blocked drain while all source FPRs are overwritten. Their
frozen-suite results and capture-cycle cost remain in the source-bound report;
they are not attributed to the selected implementation. Full workspace tests and
affected-crate strict lint pass. Whole-workspace strict lint still reports
pre-existing issues in untouched GPU tests. Current fitted values, external SDRAM
acceptance scope and the exact evidence entry are in
[architecture.md](architecture.md#current-fitted-result-and-validation-boundary).
The matched comparison is pre-commit evidence; committed builds and workload runs
are recorded separately by the project commit workflow. No new board result is claimed.

## 2026-10-17: Shared FPU port calendar and commit

The producer descriptor, synchronous RF address launch, ALU/product lane issue,
destination lifetime and final RF consumer are replaced together. The accepted
word0 retains parked Fa/Fb addresses; one pair of cursors and one lane calendar
advance vector ALU and ordinary product reads. One destination context also serves
special functions, whose local destination fields are constant in the production
instance. Their relative second-result offset preserves dual SINCOS write order.

ALU results and the final DOTSTORE value share one next-edge commit slot. Ordinary
MUL and special-function returns keep their direct RF writes. One mutually
exclusive write-event bus replaces the nested final source selection; the existing
scalar/vector and product issuer leaves leave the production dependency graph.
ACC64, two-stage multiplication, aliasing, abort, scalar T0/T1, vector II=1 and
all special-function schedules are preserved. Existing standalone leaves remain
independent reference tests rather than parallel production implementations.

An expanded value-model replay exposed scalar/vector RF commits using newly
updated registers instead of pre-edge registers. The same failure is reproduced
against frozen baseline RTL before correcting the model's sampling/commit edge;
the arithmetic oracle and hardware execution calendar are unchanged. The replay
checks all ordinary/special operation families, RF/ACC contents, clock holds and
each abort age. A separate frozen-RTL differential checks public pins, read
addresses, multiplier issues and actual writes over mixed instruction streams.

The matched full-system fit and frozen-suite comparison, source identities and
qualification boundary are linked from the current
[architecture section](architecture.md#current-fitted-result-and-validation-boundary).
The matched comparison is pre-commit evidence; committed builds and workload runs
are recorded separately by the project commit workflow. No new board result is claimed.

## 2026-10-18: BTC spare-pair payload storage

The BTC fill producer, physical payload layout, installation ownership, replay
addressing and replacement-state representation are changed together. A pending
pair writes its two accepted words directly into an unreferenced spare pair in
16-bit distributed RAM. The error-free second acceptance atomically exchanges
the victim's pair pointer with the spare. Complete entries survive cancellation,
errors and redirects during partial fills. Flush clears validity without breaking
the ownership permutation; reset restores unique initial ownership.

Replay addresses the selected pair/halfword directly. The former first-word
staging register, payload FF banks and two-word final selector are removed.
Exact LRU uses pairwise relative-order bits instead of arithmetic ranks, with
the same invalid-first priority, installation and first-replay-word touch events.
The existing rank-based cycle model remains an independent reference. BTC
capacity, full physical tags, ordinary queue reservations, stale-response drain,
PC wrap, warm replay/continuation timing and all external ports are unchanged.

A complete packed-32-bit RAM candidate reduces FF but grows total Logic. A
later direct ordinary-producer candidate reduces local logic but also grows
the full-system footprint; neither is retained. The selected complete spare-pair
chain is judged by the whole CPU-system fit, not the FF reduction or subtree
LUT count. Its matched results and source identity are linked from the current
[architecture section](architecture.md#current-fitted-result-and-validation-boundary).
Expanded protocol replay checks repeated slot replacement, distinct halfwords,
both replay holds, PC wrap and cancelled first-word fills against the independent
model and frozen original RTL. No runtime clock increase or board result is claimed.

## 2026-10-18: Shared fetch queue and BTC payload

The memory-response producer, queue references, BTC publication and final read
are replaced together. One 16-bit distributed RAM stores low BTC pairs plus a
spare and four ordinary queue slots at its high addresses. An ordered two-word
response countdown places target words directly into the spare pair. Every
payload is written once from the accepted memory response; the separate ordinary
queue FF bank and CPU-to-BTC copy writes are removed.

A queue slot retains one bit identifying a spare reference. The matched core
address and stable target tag select its halfword. Both target references expire
before the second CPU acceptance exchanges the spare/victim pointers. Complete
entries survive partial, faulted and cancelled fills, including responses
buffered before either core acceptance. Installation and a continuation enqueue
can share an edge. The final queue/BTC choice selects a RAM address instead of
multiplexing separate 16-bit payload banks; direct response bypass is retained.

Queue capacity, BTC capacity, full address checks, PC wrap, exact LRU, stale
metadata ownership, reset/flush and all external transaction schedules remain
unchanged. The independent cycle model keeps its separate queue data and rank
representation. Expanded protocol cases and frozen original RTL replay check
fully buffered target pairs, install plus enqueue, both faulted halves, abort
before the first acceptance, replay holds and continued ordinary traffic. The
zero/four/eight-entry configurations retain their public build contract.

Whole-system resource/timing results and validation boundaries are linked from
the current [architecture section](architecture.md#current-fitted-result-and-validation-boundary).
The runtime clock is unchanged and no new board result is claimed.

## 2026-10-18: Two-slot fetch and single adapter read capture

The selected chain changes I-cache response holding, request provenance,
frontend payload allocation, response bypass, BTC installation/replay and the
board instruction-source router together. Two payload slots and two request
slots have separate capacity checks; the existing I-cache owns blocked upstream
data. The aggregate reservation adder/comparison, independent downstream cursor
and head equality check are removed. FIFO order and live current bits preserve
full stream ownership across PC wrap, faults, flush and arbitrarily many redirects.

The high two addresses of the shared queue/BTC RAM hold ordinary words; target
responses write the spare pair directly. One memory-response writer serves both.
Same-edge pop/replacement consumes old asynchronous Q, and the second CPU
acceptance can publish a BTC pair while a continuation enqueues. Complete entries,
atomic spare/victim ownership and exact LRU retain their original semantics.
The independent model keeps separate payload arrays and rank-based replacement.
Official RAM16SDP4 and inferred replays share the same address/value fixture and
require collision plus install/enqueue coverage for the supported BTC settings.
All test memory producers now retain a blocked response through acceptance.

Independent full-chain review also finds and fixes an upstream ownership bug:
I-cache successor acceptance cleared an unconsumed response's error. The old
aggregate credits masked that backpressure combination; independent payload and
request capacities expose it. Remove the clear from both RTL and model so only
response publication updates data/error. Direct value assertions reproduce old
failures despite model/RTL agreement; a real Fetch/I-cache fixture queues two
good boundary words, injects a next-line error, accepts its successor and requires
the original fault plus correct retry. Portable/vendor DPB and all BTC settings
pass. The four-credit control and the selected composition are re-fitted after
the same repair, with the original starting system still the primary area baseline.

The SDRAM bridge's 108-MHz pair Q and pre-edge read-toggle event feed the adapter's
existing final 54-MHz capture. The intermediate bridge payload and valid registers
are deleted together; the adapter retains scalar lane selection, held LAST and
independent done ownership. Write-pair slots and native write timing are unchanged.
A permanent bounded distinct-pair regression checks both clock phases, consecutive
lines, scalar lanes, terminal backpressure, done order, timeout and reset.
The native128 benchmark service calendar is calibrated to that actual port timing;
the frozen legacy profile stays separate and unchanged.

D-cache shared store-port addressing/formatting passes the complete chain but
grows the selected composition, so it is not retained. Display interleaved layout,
direct ROM16 address/schedule fields and their combination all grow whole-system
Logic after complete producer/consumer replacement. FPU shared-ALU inlining only
moves hierarchy ownership and grows its synthesized tree; no FPU change is adopted.
A one-slot frontend saves slightly more Logic but loses more short-workload cycles;
the selected two-slot chain preserves the better performance tradeoff.

Matched complete-system resources, internal timing, both 22-program completion
comparisons and actual-main qualification are linked from the current
[architecture section](architecture.md#current-fitted-result-and-validation-boundary).
Boot simplification remains a proposal; current Boot images/layout and runtime
clock are unchanged. The independent GPU files and WIP are outside this batch.
No new commit, board programming or complete-GPU fit is claimed.

## 2026-10-18 Display aligned address ownership

Pending, active and tile-row framebuffer bases are stored in one 32-byte
transaction unit. Shadow writes keep the aligned address plus independent
upper-range and low-alignment predicates; writing the other half cannot erase
an invalid predicate. Accepted addresses restore their zero low bits at public
readback/request boundaries. One two-row group cursor also supplies the
local tile row, eliminating independently maintained copies of progress.
The actual width-derived tile-row stride and concatenated offset feed the
memory request. Response writes, both BSRAM banks, table addresses, publication,
release and scanout consumers retain their original layout and lifetime.

The aligned/grouped-only implementation loses the complete-system Logic
comparison despite its local saving. The compressed-shadow composition is
retained after the matched complete-system comparison and complete qualification;
resources and evidence live in the current [architecture section](architecture.md#current-fitted-result-and-validation-boundary)
and the linked batch report. Full-frame tests now exercise the maximum legal
base, both invalid half-write orders, the first aligned address above the limit,
held pending values, format snapshots, swaps, both scales, errors and underflow.
The expected exclusive upper memory bound uses 23 bits. Core/system co-simulation,
actual Flash RTL, system tests and affected strict lint pass. No GPU implementation,
boot/layout change or new board result belongs to this batch.

## 2026-10-18 Display fixed calendar and TMDS precode

Row-group readiness is already fixed for the whole output row. The replacement
calendar therefore pays the source and R/G/B RAM edges before their fixed
consumer edges, emits the first pixel directly and retains one pair for the
remaining repeats. Both scales use the same consumer-owned schedule, with an
initiation interval of four or six. FIFO storage, pointers, occupancy, in-flight
reservations, independent repeat state and production factory/resource claims
are removed together. The standalone legacy FIFO leaf is outside production.

Spare words and bits in the two existing line-buffer BSRAMs hold complete
linear/encoded color-to-q_m tables. Five-bit encoded R/B have their own 32-word
table; six-bit encoded G shares words with linear conversion. Every downstream
capture, pair, pixel packet and TMDS input uses the nine-bit format. Black and
border colors are encoded constants. Running disparity is still evaluated on
every output pixel. No symbol is incorrectly reused across repeated pixels.

The complete 13-bit q_m+popcount alternative makes each color formatter smaller
but increases packet state and selection cost; its complete-system Logic grows
and it is rejected. The nine-bit composition is retained. The fixed calendar
alone and original producer combination are separately measured so local savings
are not mistaken for complete-system savings. Matched default/actual-3x fits,
raw reports, source identities, qualification and performance are linked from
[the current architecture](architecture.md#current-fitted-result-and-validation-boundary).

Full-frame tests retain independent coordinate RGB/sync/format checks and add
the original encoder as a test-only symbol/disparity oracle. Exhaustive host
table checks cover every RGB565 value in both formats. The two physical banks,
table protection and old-Q calendar also pass official SDPB mini scanout.
Maximum-base/error/underflow tests, mandatory CPU/system co-simulation and actual
Flash boot RTL remain part of the final qualification. No GPU change or new
physical-board result belongs to this batch.

The 3x mode described in historical measurements above was removed on
2026-10-18 at the user's request. Production retains only fixed 800x480 2x;
no 3x feature, selector, fallback comment or dedicated 3x regression remains.

## 2026-10-18 Single Boot, cold state and fixed 2x

The sole configured RCC display application is unchanged. OUT_DIR generation,
the v5 packer, host installer, board tooling, simulator entry and actual SPI
loader use one fixed header and one payload destination. Header validation,
static clearing, code writes and final completion all precede CPU release.
There is no software Boot program, Boot BSRAM, instruction-source router,
reset-time selection, section interpreter or programmable DMA MMIO. The former
Boot device indices are unassigned; the loader reuses the existing narrow
arbiter client. The board validator accepts only the sole application's test
identity, and resource decomposition counts the new hardware loader.

Production reset inputs are constants; declared FPGA state and initialized
metadata supply cold ownership. Generic reusable IP reset interfaces remain.
Minimal monotonic PLL/SDRAM-ready gates control startup. Established lock loss
or a fail-stop requires reconfiguration. A cold-start audit found BTC pair
pointers had only reset initialization; their declared initial bijection is
now explicit. Bounded no-reset installs/replays pass at BTC0/4/8, and removing
that initialization produces an independent unknown-payload failure.

The application still sets SP and nonzero statics. The loader now supplies the
missing zero-static contract with actual successful writes before any fetch.
Different-size application builds preserve all production HDL/CST/SDC bytes;
changing the application requires updating Flash and a cold configuration,
using the same FPGA image. Complete real-SPI fixtures verify nonzero SDRAM,
zero/nonzero static values, real FPU work, exact first fetch and last-write
failure. Generic CPU/benchmark CSEG remains zero; only the board starts in 7.

At the user's direction the 3x feature, mode constant, switch/fallback comments,
dedicated test and pixel-calendar branches are removed. Host rendering, factory
parameters, board pixel PLL and RTL now share fixed 800x480 2x timing. Physical
ports, old-Q color reads, final symbol disparity, both formats and publication
ownership remain independently checked. Earlier 3x measurements are historical.

The complete replacement reduces whole CPU-system area. Matched resources,
timing, unchanged frozen execution metrics, modeled startup cost and evidence
are in [the current architecture](architecture.md#current-fitted-result-and-validation-boundary)
and its batch report. This is an offline result; no new GPU or board result is
claimed. An unimplemented SINCOS duplicate-phase opportunity remains a proposal
and contributes no claimed saving.
