misdake/DigitalDesign/systems/cpu-v3-tang-nano-20k/docs/cpu-v3-optimization.md

# CPU V3 optimization index

Status: concise milestone index
Repository: `../../../`
Updated: 2026-10-18

Add exactly one short sentence here for each completed optimization; append implementation detail,
measurements, rejected alternatives, and validation evidence to
[`cpu-v3-optimization-record.md`](cpu-v3-optimization-record.md). Current architecture and fitted
numbers belong in [`architecture.md`](architecture.md); exact resource and benchmark ledgers are
generated outside this document.

## Completed milestones

- 2026-10-18 — One fixed-header hardware loader, initialized cold state and fixed 2x scanout replace Boot ROM/selection/overlay/DMA and runtime reset distribution; see the [record](cpu-v3-optimization-record.md#2026-10-18-single-boot-cold-state-and-fixed-2x).

- 2026-10-18 — Display uses one fixed source/R/G/B/pixel calendar without a pair FIFO; existing BSRAM tables supply nine-bit TMDS precodes through final per-pixel disparity formatting. See the [record](cpu-v3-optimization-record.md#2026-10-18-display-fixed-calendar-and-tmds-precode).

- 2026-10-18 — Display address ownership uses aligned transaction units, separate invalid-half predicates and one row-group cursor through MMIO, SDRAM requests and publication; see the [record](cpu-v3-optimization-record.md#2026-10-18-display-aligned-address-ownership).

- 2026-10-18 — Two frontend payload slots reuse I-cache holding capacity, and the native pair-Q feeds the sole adapter response capture; whole-chain comparisons retain the fetch/interconnect combination and reject the D-cache, Display and FPU alternatives. See the [record](cpu-v3-optimization-record.md#2026-10-18-two-slot-fetch-and-single-adapter-read-capture).

- 2026-10-18 — The ordinary fetch queue and BTC share one payload RAM written only by accepted memory responses; queue references expire at atomic BTC publication and final reads select an address. Capacity and the fetch calendar are unchanged. See the [record](cpu-v3-optimization-record.md#2026-10-18-shared-fetch-queue-and-btc-payload).

- 2026-10-18 — BTC payload fills write a spare RAM pair directly and install it by atomic pointer exchange; replay reads the final halfword and exact LRU uses relative-order bits. Capacity and the fetch calendar are unchanged. See the [record](cpu-v3-optimization-record.md#2026-10-18-btc-spare-pair-payload-storage).

- 2026-10-17 — FPU ALU/product read scheduling, destination context and ALU/DOTSTORE commit storage are unified without changing write beats; the strict mixed-owner replay also corrects old-state RF commit timing in the value model. See the [record](cpu-v3-optimization-record.md#2026-10-17-shared-fpu-port-calendar-and-commit).

- 2026-10-17 — I-cache metadata/response ownership and shared fetch/FPU arithmetic reduce CPU-system Logic without changing the execution calendar; complete FST alternatives are separately priced and retained as experiments. See the [record](cpu-v3-optimization-record.md#2026-10-17-cpu-and-cache-area-reduction).

- 2026-10-11 — Integer multiply and FPU LUT interpolation share the existing CPU wide multiplier, preserving integer/MUL/DOT timing and numeric results while adding one special-function beat; see the [record](cpu-v3-optimization-record.md#2026-10-11-shared-cpu-wide-multiplier).

- 2026-08-29 — Stage 0 removed per-line coherence machinery and froze global cache-maintenance and boot-handoff semantics.
- 2026-08-29 — Stage 1 added private 256-bit cache refill buffers with complete-line commit.
- 2026-08-29 — Stage 2 replaced serialized SDRAM reads with one real eight-word burst.
- 2026-08-29 — Stage 3 split both caches into even/odd BSRAM banks.
- 2026-08-29 — Stage 4 converted both caches to deterministic two-way set associativity.
- 2026-08-30 — System consolidation combined CPU, boot, SDRAM, and display into one fitted system.
- 2026-08-30 — Stage 5 pipelined cache hits and added a four-entry epoch-tagged instruction fetch queue.
- 2026-08-30 — Stage 6 added next-line I-cache prefetch, then removed it after measuring negligible benefit for material cost.
- 2026-08-30 — Stage 7 added benchmark profiling, a redirect fast path, and a RAM16 scalar register file.
- 2026-08-30 — Stage 8 introduced split I/D caches, write-allocate D-cache stores, dirty eviction, and global maintenance.
- 2026-08-31 — Stage 9 introduced the exact-related 54/108-MHz SDRAM gearbox.
- 2026-08-31 — Stage 10 replaced cache line buffers with parity-split true-dual-port BSRAM banks and direct 64-bit transfer.
- 2026-09-01 — Stage 11 added a one-entry asynchronous scalar-store buffer.
- 2026-09-01 — Stage 12 overlapped single-cycle integer execution with fetch and added registered GPR forwarding.
- 2026-09-11 — ISA 0.8 migrated the integer encoding, toolchain, simulators, RTL, debugger, and boot assets together.
- 2026-09-12 — Single-stage boot folded the former second boot stage into the BSRAM-resident loader.
- 2026-09-12 — The ASR/ASRI repair removed conditional-expression signedness corruption found on hardware.
- 2026-09-12 — Cache valid/victim state and the D-cache dirty scan moved from wide FF logic toward RAM16 and windowed scanning.
- 2026-09-12 — The framebuffer widened from 320x240 to 400x240 RGB565.
- 2026-09-12 — Scanout collapsed from three line slots to a two-slot single-BSRAM buffer.
- 2026-09-12 — Cache valid-array write ports were restructured so both valid ways inferred RAM16 instead of FF read muxes.
- 2026-09-13 — The resolved-target BTC added a four-entry exact-LRU redirect cache with same-cycle replay.
- 2026-09-20 — FPU v2 S7b packed the RCP/RSQRT special path and restored 54-MHz timing.
- 2026-09-20 — FPU v2 S7c added modular SINCOS range reduction and lookup without another DSP.
- 2026-09-21 — FPU v2 compiler C0 froze the Q16.16 model, encoding, simulator, and source ABI.
- 2026-09-21 — FPU v2 compiler C1 added scalar lowering, calls, spills, comparisons, and GPR/F-register bridges.
- 2026-09-21 — FPU v2 compiler C2 added vector allocation, operations, calls, spills, DOT, and VMULS.
- 2026-09-21 — FPU v2 compiler C3 added special-function lowering and restored the compiled display demo.
- 2026-09-21 — The post-C3 AUX address repair removed the failing asynchronous GPR-read control cone.
- 2026-09-21 — FPU v2 prescale geometry helpers proved the API before being superseded by direct small-range helpers.
- 2026-09-21 — Small-range geometry helpers replaced the temporary prescale API without adding an opcode.
- 2026-09-21 — FPU v2 closure migrated and re-froze all 22 benchmark workloads under the final Q16.16 API.
- 2026-09-22 — RCC gained segregated heap free lists, checked vectors, and segmented application placement.
- 2026-09-22 — ISA 0.9 added paged DSEG mapping and asynchronous LCOPY/DCLEANL/DWAIT line operations.
- 2026-09-23 — GPU fixed-line bring-up connected submit, dummy rendering, tile-linear scanout, and the main SDRAM arbiter.
- 2026-09-23 — GPU variable line bursts extended its memory masters and SDRAM path to 32–128-byte transactions.
- 2026-09-23 — Generic device watch-change lets the CPU sleep until a selected device channel changes.
- 2026-09-23 — The blocking GPU framebuffer cache added eight tile entries, LOAD/CLEAR, masked writes, and 128-byte cleaning.
- 2026-09-23 — Partial GPU tile waves added tile-local gradients and three staggered left-to-right update fronts.
- 2026-09-23 — GPU memory-path repair restored D-cache RAM16 mapping and reduced the long-write gearbox to one 64-bit pair.
- 2026-09-26 — The viewport rasterizer joined the GPU tile cache, and a registered tile-corner result restored 54-MHz timing.
- 2026-09-26 — Four swizzled GPU cache DPBs removed pixel beat read-modify-write, added explicit retirement ACK and K=1 acquisition, and passed full-frame integration, 54-MHz timing, and triangle-only cold-boot validation.
- 2026-09-27 — CPU B-source predecode and two-stage pixel AABB improved fitted timing with unchanged ISA and pixel results; offline and loaded-UART validation passed, with cold boot pending.
- 2026-09-27 — Compact raster ownership, shared edge stepping, stable BSRAM inference and shared cache/control RAM16 ports reduced Logic; tile wins at both quad rates, and the two-pixel default passed complete Flash Verify and loaded UART, with cold boot pending.

- 2026-09-27 — Four-row display buffering in two BSRAMs removed response staging and added linear RGB565-to-sRGB conversion; the completed-pair RAM16 FIFO is retained after whole-system comparisons, with the then-supported 2x/3x build features (3x retired on 2026-10-18).

- 2026-09-28 — Stream-owned fetch offsets, owner-qualified response broadcast and synchronous I/D-cache tag DPBs reduce whole-system Logic while preserving cache cycles and GPU behavior; matched RAM16, staging and arbitration alternatives remain in the local resource audit.

- 2026-09-28 — Unified FPU lanes, common integer operands/results, synchronous D-cache metadata, ordered fetch cursors and six-client round robin reduce Logic while retaining two-way caches, dense clean throughput and frozen-suite execution cycles; full offline validation passed.
- 2026-09-28 — The native SDRAM controller and two-pair 54/108-MHz bridge integrate bank-striped, naturally aligned line bursts with scalar masking; full-system simulation and routed timing pass.
- 2026-10-07 — The shared FPU multiplier uses two registered stages, shortening MUL/VMUL/VMULS and the dot family by one beat while retaining SINCOS timing with an 18-bit phase register; the [record](cpu-v3-optimization-record.md#2026-10-07--two-stage-fpu-multiplier) preserves the frozen-suite comparison and offline validation boundary.

- 2026-10-09 — One shared integer shift barrel and direct scalar-response storage reduce whole-system Logic with unchanged instruction/transaction schedules; local audited fitting, functional regressions and the original cloud comparison are in the [record](cpu-v3-optimization-record.md#2026-10-09--shared-integer-shifter-and-scalar-memory-storage).

- 2026-10-11 — D-cache refill captures the requested halfword in its final CPU response slot, preserving complete-line publication, fault clearing and LCOPY ownership; the [record](cpu-v3-optimization-record.md#2026-10-11-d-cache-final-response-slot) links the matched qualification boundary.

- 2026-10-11 — One ProductPath issuer and existing-register address cursors replace separate MUL/DOT controllers and repeated lane-stride address generation, retaining ACC64, aliasing and abort calendars; the [record](cpu-v3-optimization-record.md#2026-10-11-unified-fpu-product-issuer-and-address-cursors) defines the qualified scope.

## Next work

Before the GPU v2 reset, the framebuffer storage/quad attachment to the display work-1 baseline
completed full integration regression and routed resources recorded in
[`architecture.md`](architecture.md#current-fitted-result-and-validation-boundary).

The historical [eight-DPB framebuffer component](framebuffer-cache.md) reduces LUT use in a matched
standalone comparison and removes the numerical color queue. Its contract and tests are complete;
bank-order execution with one latched lane-control bit further reduces selection logic while
preserving word-level memory/render concurrency. Production storage/quad integration retains
blocking color traffic and initializes local Z to far depth. Depth/blend execution, depth
surface binding and concurrent sector scheduling remain pending; whole-system fit is recorded
in the architecture document.

Future CPU or system optimizations are added here only after completion; planned GPU work is tracked
in the GPU design documents and the project todo rather than expanded in this index.

The 2026-10-02 development baseline integrates independent GPU v2 Rust components,
their explicit research alternatives and the shared vendor SDRAM service while
retaining serial production memory and an inactive GPU shell; current offline
qualification and the physical boundary are described in [architecture](architecture.md).

2026-09-28: source-held D-cache writeback removes duplicate FF payload storage and shares arbiter
payload qualification; details are in the append-only record and current fit in
[`architecture.md`](architecture.md#current-fitted-result-and-validation-boundary).
