misdake/DigitalDesign/ip/gpu-v2/docs/references/record-ownership.md

# Opaque record ownership

## Objects and capacity

`geometry::record_transport` is a Rust ownership/storage controller for opaque
36-bit rows. It executes no setup, raster or interpolation arithmetic.
`geometry::source_record_link` connects a normal-path snapshot lease from
SourceCapture to this controller.

Exactly two slots each hold 1..64 sequential rows. One writer can fill a Writing
slot while the shared coverage/attribute reader uses a different Published
slot. Payload arrays are not cleared on allocation; validity and generation
establish ownership. Keys bind slot, generation, source ticket, immutable context
and fan index. A source snapshot admits up to six fans. The third fan waits if
both slots are owned; there is no hidden fan FIFO.

| Boundary | Meaning |
| --- | --- |
| source_captured | Controller accepts an already-owned complete snapshot ticket/context |
| SnapshotLastUseAck | Every announced fan is fully written/published, or fan count is zero; snapshot may be consumed |
| RecordReleased | Last marked attribute return transfers and last_quad_ack arrives; record credit returns |

The source link holds one offered ticket through SnapshotAccepted, then returns
last-use feedback on a later enabled edge. Raw source-slot release, snapshot
consumption and numerical record release are distinct ownership events.
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
