misdake/DigitalDesign/systems/cpu-v3-tang-nano-20k/tools/gpu_profiler/tests/fixtures/pingpong/load.csv

cycle | dma | vt_owned | vt_step | t_queue | prepare_busy | r_busy | i_busy | r_quad | i_pixel | quad_total | quad_producer | light_pending | light_tokens | light_tick | sample_pending | sample_quads | sample_tick | texture_public | texture_work | texture_reserved | final_wait | final_tokens | rop_contexts | light_issue | sample_issue | final_issue | rop_lane | fb_hint | fb_maintenance | ro_wait | fb_read_wait | fb_write_wait | vt_owner | vt_kind | r_owner | i_owner | prepare_owner
10 | 0 | 0 | 0 | 0 | 0 | 0 | 0 | 0 | 0 | 0 | 0 | 0 | 0 | 0 | 0 | 0 | 0 | 0 | 0 | 0 | 0 | 0 | 0 | 0 | 0 | 0 | 0 | 0 | 0 | 0 | 0 | 0 | 0 | 0 | 0 | 0 | 0
11 | 1 | 0 | 0 | 0 | 0 | 0 | 0 | 0 | 0 | 0 | 0 | 0 | 0 | 0 | 0 | 0 | 0 | 0 | 0 | 0 | 0 | 0 | 0 | 0 | 0 | 0 | 0 | 0 | 0 | 0 | 0 | 0 | 0 | 0 | 0 | 0 | 0
12 | 1 | 0 | 0 | 0 | 0 | 0 | 0 | 0 | 0 | 0 | 0 | 0 | 0 | 0 | 0 | 0 | 0 | 0 | 0 | 0 | 0 | 0 | 0 | 0 | 0 | 0 | 0 | 0 | 0 | 0 | 0 | 0 | 0 | 0 | 0 | 0 | 0
13 | 1 | 0 | 0 | 0 | 0 | 0 | 0 | 0 | 0 | 0 | 0 | 0 | 0 | 0 | 0 | 0 | 0 | 0 | 0 | 0 | 0 | 0 | 0 | 0 | 0 | 0 | 0 | 0 | 0 | 0 | 0 | 0 | 0 | 0 | 0 | 0 | 0
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
