misdake/DigitalDesign/systems/cpu-v3-tang-nano-20k/tools/gpu_profiler/TODO.md

# GPU profiler remaining qualification

Implemented interfaces belong in [README.md](README.md), the
[session specification](/systems/cpu-v3-tang-nano-20k/docs/gpu-profiler.md) and
[driver bridge](/systems/cpu-v3-tang-nano-20k/docs/gpu-capture.md).
Detailed pending architecture remains in the local project design area.

- [ ] Extend physical-button qualification to initially held and simultaneous
  buttons. These cases must remain separate from automatic software stimulus;
  a completed transfer must never serve as a resume request.
- [ ] Preserve explicit cold-only/no-CPU-or-Display scope. Warm internal state or
  actual contention needs additional reconstructable state/workload evidence.
- [ ] Separate memory-read, codec/CRC and UART-line cost before increasing baud.
  Hardware stays at the qualified115200-baud configuration; faster dividers and
  sustained CPU/host feeding remain unqualified.
- [ ] Omitting preimages/static bytes later requires proof of initialization or
  exact recoverable content. Missing dependencies must still fail; catalog
  references alone are not captured bytes.
