misdake/DigitalDesign/systems/cpu-v3-tang-nano-20k/src/hardware/system_control/system_control.v

module {{ module_name }} (
    input wire clk,
    input wire reset,
    input wire [2:0] device_index,
    input wire [3:0] device_channel,
    input wire device_read_enable,
    input wire device_write_enable,
    input wire [15:0] device_write_data,
    input wire dcache_maintenance_busy,
    input wire dcache_maintenance_done,
    input wire dcache_maintenance_error,
    input wire [15:0] watch_read_data,
    output reg [15:0] device_read_data,
    output reg icache_invalidate = 0,
    output reg dcache_invalidate = 0,
    output reg dcache_clean = 0,
    // This hold is deliberately CPU-local. Cache write-back traffic and all
    // non-CPU clients of the shared SDRAM continue to run during maintenance.
    output reg cpu_hold = 0,
    output wire [2:0] watch_device_index,
    output wire [3:0] watch_device_channel,
    output wire watch_read_enable,
    output reg [5:0] leds = 0,
    output wire uart_tx
);

// 8N1 transmitter, adapted from the proven self-test shift logic: one start
// bit, eight data bits (LSB first), one stop bit, CLOCKS_PER_BIT clocks per
// bit. A channel-3 write while busy is dropped; software polls the busy
// readback before enqueueing the next byte.
reg uart_busy = 0;
reg [9:0] uart_frame = 10'h3ff;
reg [3:0] uart_bit = 0;
reg [15:0] uart_divider = 0;
reg [15:0] cache_maintenance_status = 0;
reg [1:0] pending_dcache_maintenance = 0;
reg watch_active = 0;
reg [2:0] watch_index = 0;
reg [3:0] watch_channel = 0;
reg [15:0] watch_expected = 0;

assign watch_device_index = watch_index;
assign watch_device_channel = watch_channel;
assign watch_read_enable = watch_active;

always @* begin
    device_read_data = 0;
    if (device_read_enable && device_index == 3'd0) begin
        case (device_channel)
            3: device_read_data = {15'b0, uart_busy};
            5: device_read_data = cache_maintenance_status;
            default: device_read_data = 0;
        endcase
    end
end

always @(posedge clk) begin
    if (reset) begin
        icache_invalidate <= 0;
        dcache_invalidate <= 0;
        dcache_clean <= 0;
        cpu_hold <= 0;
        watch_active <= 0;
        watch_index <= 0;
        watch_channel <= 0;
        watch_expected <= 0;
        cache_maintenance_status <= 0;
        pending_dcache_maintenance <= 0;
        leds <= 0;
        uart_busy <= 0;
        uart_frame <= 10'h3ff;
        uart_bit <= 0;
        uart_divider <= 0;
    end else begin
        icache_invalidate <= 0;
        dcache_invalidate <= 0;
        dcache_clean <= 0;
        if (cpu_hold && !watch_active && pending_dcache_maintenance != 0 &&
            !dcache_maintenance_busy) begin
            dcache_invalidate <= pending_dcache_maintenance == 1;
            dcache_clean <= pending_dcache_maintenance == 2;
            pending_dcache_maintenance <= 0;
        end
        // Ignore a completion from the operation that just released the
        // D-cache while a deferred command is being emitted.
        if (cpu_hold && !watch_active && pending_dcache_maintenance == 0 &&
            dcache_maintenance_done) begin
            cpu_hold <= 0;
            cache_maintenance_status <= dcache_maintenance_error ? 16'h8000 : 16'h0000;
        end
        if (watch_active && watch_read_data != watch_expected) begin
            watch_active <= 0;
            cpu_hold <= 0;
        end
        if (uart_busy) begin
            if (uart_divider == 16'd{{ clocks_per_bit_minus_one }}) begin
                uart_divider <= 0;
                if (uart_bit == 4'd9) begin
                    uart_busy <= 0;
                end else begin
                    uart_bit <= uart_bit + 1'b1;
                end
            end else begin
                uart_divider <= uart_divider + 1'b1;
            end
        end
        if (device_write_enable && device_index == 3'd0) begin
            case (device_channel)
                0: icache_invalidate <= 1;
                1: if (!cpu_hold) begin
                    cpu_hold <= 1;
                    if (dcache_maintenance_busy)
                        pending_dcache_maintenance <= 1;
                    else
                        dcache_invalidate <= 1;
                end
                2: leds <= device_write_data[5:0];
                3: if (!uart_busy) begin
                    uart_frame <= {1'b1, device_write_data[7:0], 1'b0};
                    uart_bit <= 0;
                    uart_divider <= 0;
                    uart_busy <= 1;
                end
                4: if (!cpu_hold) begin
                    cpu_hold <= 1;
                    if (dcache_maintenance_busy)
                        pending_dcache_maintenance <= 2;
                    else
                        dcache_clean <= 1;
                end
                6: begin
                    watch_index <= device_write_data[2:0];
                    watch_channel <= device_write_data[6:3];
                end
                7: if (!cpu_hold) begin
                    watch_expected <= device_write_data;
                    watch_active <= 1;
                    cpu_hold <= 1;
                end
                default: begin end
            endcase
        end
    end
end

assign uart_tx = uart_busy ? uart_frame[uart_bit] : 1'b1;

endmodule
