misdake/DigitalDesign/compiler/rcc/src/compiler/ir.rs

//! SSA-based CFG IR for the new compiler pipeline (compiler).
//!
//! A function is a CFG of basic blocks. Each block holds a list of phi nodes,
//! a list of instructions, and a terminator. Values are SSA virtual registers
//! (`VReg`), produced at most once. Branch conditions are always a single
//! comparison (`Cmp`) matching the ISA's cmp + j_cc model.

use crate::FuncName;
use std::fmt;

pub type VReg = u32;
pub type BlockId = usize;

#[repr(u8)]
#[derive(Copy, Clone, Debug, Eq, PartialEq, Hash)]
pub enum CompareOp {
    Never = 0,
    Greater = 1,
    Equal = 2,
    Less = 4,
    GreaterEqual = 3,
    NotEqual = 5,
    LessEqual = 6,
    Always = 7,
}

impl CompareOp {
    pub fn invert(self) -> Self {
        match self {
            Self::Never => Self::Always,
            Self::Greater => Self::LessEqual,
            Self::Equal => Self::NotEqual,
            Self::Less => Self::GreaterEqual,
            Self::GreaterEqual => Self::Less,
            Self::NotEqual => Self::Equal,
            Self::LessEqual => Self::Greater,
            Self::Always => Self::Never,
        }
    }
}

#[derive(Copy, Clone, Debug, Eq, PartialEq, Hash)]
pub enum BinOp {
    Add,
    Sub,
    And,
    Or,
    Xor,
}

/// right-hand side of an integer operation: a register or a literal immediate
#[derive(Copy, Clone, Debug, Eq, PartialEq, Hash)]
pub enum IntOperand {
    Reg(VReg),
    Imm(u16),
}

/// post-multiply window kept from the full unsigned 32-bit product
#[derive(Copy, Clone, Debug, Eq, PartialEq, Hash)]
pub enum MulWindow {
    /// bits [15:0] (MUL0 / MULI)
    Low,
    /// bits [23:8] (MUL8)
    Shift8,
    /// bits [31:16] (MUL16)
    Shift16,
}

/// architectural special register read by `Instr::Mfsr`
#[derive(Copy, Clone, Debug, Eq, PartialEq, Hash)]
pub enum SpecialReg {
    Cseg,
    Dseg,
    DsegPage(u8),
}

#[derive(Copy, Clone, Debug, Eq, PartialEq, Hash)]
pub enum UnOp {
    Inv,
    Neg,
    Not0,
    Cnt1,
    Log2,
    /// sign-extend the low byte (CpuV3 SEXTB; CpuV2 expands through shifts)
    Sextb,
    /// count leading zeros (CpuV3 CLZ; rejected for CpuV2)
    Clz,
}

/// shifts are destructive two-operand forms on the ISA (`rd = rd << n`),
/// so codegen inserts a mov when the SSA destination differs from the source
#[derive(Copy, Clone, Debug, Eq, PartialEq, Hash)]
pub enum ShiftOp {
    Lsl,
    Lsr,
    Asr,
}

/// FPU v2 scalar two-operand subops (design section 7.3). All operands are
/// single Q16.16 F registers.
#[derive(Copy, Clone, Debug, Eq, PartialEq, Hash)]
pub enum FpuBinOp {
    Add,
    Sub,
    Mul,
}

/// FPU v2 scalar unary subops (design section 7.3). The second source is
/// ignored by the hardware.
#[derive(Copy, Clone, Debug, Eq, PartialEq, Hash)]
pub enum FpuUnOp {
    Abs,
    Neg,
    Floor,
    Ceil,
    Round,
    Trunc,
}

/// Component-wise vector unary operations. Rounding is scalar-only.
#[derive(Copy, Clone, Debug, Eq, PartialEq, Hash)]
pub enum FpuVecUnOp {
    Abs,
    Neg,
}

/// FPU v2 scalar special-function subops (design sections 7.3 and 9.3). `Rcp`
/// and `Rsqrt` write one F register; `Sin`/`Cos` write one F register through
/// the `SINCOS` subop's single-output modes; `SinCos` writes the contiguous
/// pair `Fd`/`Fd+1` (so its destination carries two lanes).
#[derive(Copy, Clone, Debug, Eq, PartialEq, Hash)]
pub enum FpuSpecialOp {
    Rcp,
    Rsqrt,
    Sin,
    Cos,
    SinCos,
}

/// register file a virtual register belongs to
#[derive(Copy, Clone, Debug, Eq, PartialEq, Hash)]
pub enum RegClass {
    Gpr,
    /// CpuV3 FPU v2: one signed Q16.16 scalar F register per value. The
    /// frontend does not yet allocate it (C0 rejects FPU lowering); the class
    /// stays so the frozen `F0..F63` ABI convention is validated and the
    /// backend can refuse an FPU program explicitly.
    Fpu,
}

/// right-hand side of a comparison; immediates are legalized (u4/i4) in codegen
#[derive(Copy, Clone, Debug, Eq, PartialEq)]
pub enum CmpRhs {
    Reg(VReg),
    Imm(u16),
}

/// semantics: `lhs cond rhs`
#[derive(Copy, Clone, Debug)]
pub struct Cmp {
    pub lhs: VReg,
    pub rhs: CmpRhs,
    pub cond: CompareOp,
    pub signed: bool,
}

impl PartialEq for Cmp {
    fn eq(&self, other: &Self) -> bool {
        self.lhs == other.lhs
            && self.rhs == other.rhs
            && self.cond as u8 == other.cond as u8
            && self.signed == other.signed
    }
}
impl Eq for Cmp {}

#[derive(Clone, Debug, PartialEq)]
pub enum Instr {
    Bin {
        dst: VReg,
        op: BinOp,
        lhs: VReg,
        rhs: IntOperand,
    },
    /// unsigned multiply keeping one 16-bit window of the 32-bit product;
    /// CpuV3 lowers to MUL0/MUL8/MUL16 (or MULI for a Low immediate), CpuV2
    /// rewrites a Low register product to the rcc_std mul_16x16 library call
    Mul {
        dst: VReg,
        window: MulWindow,
        lhs: VReg,
        rhs: IntOperand,
    },
    Un {
        dst: VReg,
        op: UnOp,
        src: VReg,
    },
    /// destructive two-operand shift; a register amount is masked to the low
    /// four bits by the hardware (`rs & 15`)
    Shift {
        dst: VReg,
        op: ShiftOp,
        src: VReg,
        amount: IntOperand,
    },
    /// CpuV3 SIGNAL with a nonzero type (1..=15): a simulator-side event that
    /// retires as a NOP in hardware. This is an observable compiler barrier:
    /// it is never deleted or merged, and no instruction or memory operation
    /// moves across it. The host (CpuV2) implementation is a NOP.
    Signal {
        signal_type: u8,
        value: VReg,
    },
    /// CpuV3-only: read an architectural special register (MFSR)
    Mfsr {
        dst: VReg,
        sr: SpecialReg,
    },
    /// dst = (cmp.lhs cond cmp.rhs) as 0 or 1 (Boolean-producing comparison).
    /// The frontend emits it when a condition is materialized as a stored bool;
    /// the diamond-conversion pass emits it when it folds a 0/1 if/else.
    Bool {
        dst: VReg,
        cmp: Cmp,
    },
    /// dst = src when `cmp` holds, otherwise fallback. This is a single SSA
    /// definition; CpuV3 lowers the fallback copy before compare/conditional move.
    CMov {
        dst: VReg,
        cmp: Cmp,
        src: VReg,
        fallback: VReg,
    },
    Mov {
        dst: VReg,
        src: VReg,
    },
    LoadImm {
        dst: VReg,
        value: u16,
    },
    LoadMem {
        dst: VReg,
        base: VReg,
        offset: i16,
    },
    StoreMem {
        base: VReg,
        offset: i16,
        src: VReg,
    },
    /// Compiler-generated static data initialization. Codegen groups these by
    /// 256-word page and uses sp + u8 offset stores.
    StoreStatic {
        addr: u16,
        value: u16,
    },
    /// rets are SSA defs (filled by the callee per the calling convention)
    Call {
        func: FuncName,
        args: Vec<VReg>,
        rets: Vec<VReg>,
    },
    /// load the absolute address of a function (relocation slot)
    LoadFuncAddr {
        dst: VReg,
        func: FuncName,
    },
    /// indirect call through a function pointer (Harvard: distinct from data ptr)
    CallPtr {
        addr: VReg,
        args: Vec<VReg>,
        rets: Vec<VReg>,
    },
    DevRecv {
        dst: VReg,
        device: u8,
        channel: u8,
    },
    DevSend {
        device: u8,
        channel: u8,
        src: VReg,
    },
    /// CpuV3-only: blocking clean-plus-invalidate of the complete write-back
    /// data cache. This is a compiler memory and control barrier.
    DcacheInvalidateAll,
    /// CpuV3-only asynchronous copy of one aligned D-cache line to a physical
    /// destination page. This is an observable memory operation.
    DcacheLineCopy {
        source: VReg,
        destination_page: VReg,
    },
    /// CpuV3-only asynchronous clean of one resident D-cache line.
    DcacheCleanLine {
        address: VReg,
    },
    /// CpuV3-only completion/error boundary for asynchronous D-cache commands.
    DcacheWait,
    /// CpuV3-only: write the DSEG special register (MTSR DSEG)
    MtsrDseg {
        src: VReg,
        index: Option<u8>,
    },
    /// CpuV3-only: atomically switch CSEG and jump (JSEG); never returns
    Jseg {
        cseg: VReg,
        target: VReg,
    },
    /// frame slot access (register allocator spills only; offset is a frame
    /// slot index, resolved to load_sp/store_sp in codegen)
    LoadSp {
        dst: VReg,
        slot: u8,
    },
    StoreSp {
        slot: u8,
        src: VReg,
    },
    /// frame-local slot access for address-taken locals and local arrays;
    /// slots are assigned by the frontend (distinct from spill slots)
    LoadLocal {
        dst: VReg,
        slot: u8,
    },
    StoreLocal {
        slot: u8,
        src: VReg,
    },
    /// dst = sp + slot (address of a frame-local variable)
    AddrOfLocal {
        dst: VReg,
        slot: u8,
    },
    // ----- CpuV3 FPU v2 scalar instructions (Fpu-class vregs unless noted) -----
    /// `Fd = Fa op Fb` (scalar ADD/SUB/MUL)
    FpuBin {
        dst: VReg,
        op: FpuBinOp,
        lhs: VReg,
        rhs: VReg,
    },
    /// `Fd = op(Fa)` (scalar ABS/NEG/FLOOR/CEIL/ROUND/TRUNC)
    FpuUn {
        dst: VReg,
        op: FpuUnOp,
        src: VReg,
    },
    /// `Fd = op(Fa)` (scalar RCP/RSQRT, or SINCOS single/dual output). The
    /// destination lane count is `lanes(dst)`: one for RCP/RSQRT/SIN/COS and
    /// two for the dual-output SINCOS.
    FpuSpecial {
        dst: VReg,
        op: FpuSpecialOp,
        src: VReg,
    },
    /// `Fd = Fa` (FMOV)
    FpuMov {
        dst: VReg,
        src: VReg,
    },
    /// `I16TOF`: dst = sign_extend(src_gpr) << 16
    FpuFromInt {
        dst: VReg,
        src_gpr: VReg,
    },
    /// `FTOI16`: dst_gpr = trunc-toward-zero(src)
    FpuToInt {
        dst_gpr: VReg,
        src: VReg,
    },
    /// `ILO2F`: dst[15:0] = src_gpr, other bits preserved
    FpuFromLo {
        dst: VReg,
        src_gpr: VReg,
    },
    /// `IHI2F`: dst[31:16] = src_gpr, dst[15:0] comes from `src`
    FpuFromHi {
        dst: VReg,
        src: VReg,
        src_gpr: VReg,
    },
    /// `FLO2I`: dst_gpr = src[15:0]
    FpuToLo {
        dst_gpr: VReg,
        src: VReg,
    },
    /// `FHI2I`: dst_gpr = src[31:16]
    FpuToHi {
        dst_gpr: VReg,
        src: VReg,
    },
    /// `FLD`: dst = {mem[addr+1], mem[addr]}, low half first; addr = base_gpr + offset
    FpuLoad {
        dst: VReg,
        base_gpr: VReg,
        offset: i16,
    },
    /// `FST`: mem[addr] = src[15:0], mem[addr+1] = src[31:16]
    FpuStore {
        base_gpr: VReg,
        offset: i16,
        src: VReg,
    },
    // ----- CpuV3 FPU v2 vector instructions (contiguous F-register ranges) -----
    /// `D[i] = A[i] op B[i]` over a contiguous range (VADD/VSUB/VMUL); the
    /// lane count is `lanes(dst)`. The destination range must be either
    /// identical to a source range (in-place) or disjoint from both.
    FpuVecBin {
        dst: VReg,
        op: FpuBinOp,
        lhs: VReg,
        rhs: VReg,
    },
    /// `D[i] = A[i] * scalar` over a contiguous range (VMULS); the scalar is
    /// latched by the hardware before the lanes are written, but the
    /// destination range must not partially overlap the scalar register.
    FpuVecMulS {
        dst: VReg,
        lhs: VReg,
        scalar: VReg,
    },
    /// `D[i] = op(A[i])` over a contiguous range (VABS/VNEG); the second
    /// source is ignored by the hardware.
    FpuVecUn {
        dst: VReg,
        op: FpuVecUnOp,
        src: VReg,
    },
    /// `D[i] = A[i]` over a contiguous range. Lowered as a cycle-safe
    /// parallel move, so the two ranges may overlap in any way.
    FpuVecMove {
        dst: VReg,
        src: VReg,
    },
    /// build a vector from `lanes.len()` scalar values, one per lane. Lowered
    /// as a cycle-safe parallel move into the destination range.
    FpuVecConstruct {
        dst: VReg,
        lanes: Vec<VReg>,
    },
    /// `dst = src[lane]` (scalar lane extraction; FMOV from `base + lane`)
    FpuVecLane {
        dst: VReg,
        src: VReg,
        lane: u8,
    },
    /// `dst = q16(sum_i lhs[i] * rhs[i])` through the wide ACC (DOTSTORE).
    /// `dst` is scalar and the lane count is `lanes(lhs)`.
    FpuDotStore {
        dst: VReg,
        lhs: VReg,
        rhs: VReg,
    },
    /// vector load: `dst[i] = {mem[addr+2i+1], mem[addr+2i]}`, low half first
    /// (`FLDV`); the lane count is `lanes(dst)`.
    FpuVecLoad {
        dst: VReg,
        base_gpr: VReg,
        offset: i16,
    },
    /// vector store: `mem[addr+2i]`/`mem[addr+2i+1] = src[i]` (`FSTV`); the
    /// lane count is `lanes(src)`.
    FpuVecStore {
        base_gpr: VReg,
        offset: i16,
        src: VReg,
    },
    /// dst_gpr = 4-word-aligned address of FPU spill frame slot `slot`
    /// (register allocator spills only; the word offset is resolved in codegen)
    AddrOfFpuSpill {
        dst: VReg,
        slot: u8,
    },
}

impl Instr {
    /// calls `f` on every vreg this instruction reads (uses, never defs)
    pub fn for_each_use(&self, f: &mut impl FnMut(VReg)) {
        match self {
            Instr::Bin { lhs, rhs, .. } => {
                f(*lhs);
                rhs.for_each_reg(f);
            }
            Instr::Mul { lhs, rhs, .. } => {
                f(*lhs);
                rhs.for_each_reg(f);
            }
            Instr::Un { src, .. } | Instr::Mov { src, .. } => f(*src),
            Instr::Shift { src, amount, .. } => {
                f(*src);
                amount.for_each_reg(f);
            }
            Instr::Signal { value, .. } => f(*value),
            Instr::Bool { cmp, .. } => cmp.for_each_use(f),
            Instr::CMov {
                cmp, src, fallback, ..
            } => {
                cmp.for_each_use(f);
                f(*src);
                f(*fallback);
            }
            Instr::LoadMem { base, .. } => f(*base),
            Instr::StoreMem { base, src, .. } => {
                f(*base);
                f(*src);
            }
            Instr::Call { args, .. } => args.iter().copied().for_each(f),
            Instr::CallPtr { addr, args, .. } => {
                f(*addr);
                args.iter().copied().for_each(f);
            }
            Instr::DcacheLineCopy {
                source,
                destination_page,
            } => {
                f(*source);
                f(*destination_page);
            }
            Instr::DcacheCleanLine { address } => f(*address),
            Instr::DevSend { src, .. }
            | Instr::MtsrDseg { src, .. }
            | Instr::StoreSp { src, .. }
            | Instr::StoreLocal { src, .. } => f(*src),
            Instr::Jseg { cseg, target } => {
                f(*cseg);
                f(*target);
            }
            Instr::FpuBin { lhs, rhs, .. } => {
                f(*lhs);
                f(*rhs);
            }
            Instr::FpuUn { src, .. }
            | Instr::FpuSpecial { src, .. }
            | Instr::FpuMov { src, .. }
            | Instr::FpuToInt { src, .. }
            | Instr::FpuToLo { src, .. }
            | Instr::FpuToHi { src, .. } => f(*src),
            Instr::FpuFromInt { src_gpr, .. }
            | Instr::FpuFromLo { src_gpr, .. }
            | Instr::FpuLoad {
                base_gpr: src_gpr, ..
            } => f(*src_gpr),
            Instr::FpuFromHi { src, src_gpr, .. } => {
                f(*src);
                f(*src_gpr);
            }
            Instr::FpuStore { base_gpr, src, .. } => {
                f(*base_gpr);
                f(*src);
            }
            Instr::FpuVecBin { lhs, rhs, .. } => {
                f(*lhs);
                f(*rhs);
            }
            Instr::FpuVecMulS { lhs, scalar, .. } => {
                f(*lhs);
                f(*scalar);
            }
            Instr::FpuVecUn { src, .. } | Instr::FpuVecMove { src, .. } => f(*src),
            Instr::FpuVecConstruct { lanes, .. } => lanes.iter().copied().for_each(f),
            Instr::FpuVecLane { src, .. } => f(*src),
            Instr::FpuDotStore { lhs, rhs, .. } => {
                f(*lhs);
                f(*rhs);
            }
            Instr::FpuVecLoad { base_gpr, .. } => f(*base_gpr),
            Instr::FpuVecStore { base_gpr, src, .. } => {
                f(*base_gpr);
                f(*src);
            }
            Instr::LoadImm { .. }
            | Instr::StoreStatic { .. }
            | Instr::DevRecv { .. }
            | Instr::DcacheInvalidateAll
            | Instr::DcacheWait
            | Instr::LoadSp { .. }
            | Instr::LoadLocal { .. }
            | Instr::AddrOfLocal { .. }
            | Instr::LoadFuncAddr { .. }
            | Instr::AddrOfFpuSpill { .. }
            | Instr::Mfsr { .. } => {}
        }
    }

    /// calls `f` on a mutable reference to every vreg this instruction reads
    pub fn for_each_use_mut(&mut self, f: &mut impl FnMut(&mut VReg)) {
        match self {
            Instr::Bin { lhs, rhs, .. } => {
                f(lhs);
                rhs.for_each_reg_mut(f);
            }
            Instr::Mul { lhs, rhs, .. } => {
                f(lhs);
                rhs.for_each_reg_mut(f);
            }
            Instr::Un { src, .. } | Instr::Mov { src, .. } => f(src),
            Instr::Shift { src, amount, .. } => {
                f(src);
                amount.for_each_reg_mut(f);
            }
            Instr::Signal { value, .. } => f(value),
            Instr::Bool { cmp, .. } => cmp.for_each_use_mut(f),
            Instr::CMov {
                cmp, src, fallback, ..
            } => {
                cmp.for_each_use_mut(f);
                f(src);
                f(fallback);
            }
            Instr::LoadMem { base, .. } => f(base),
            Instr::StoreMem { base, src, .. } => {
                f(base);
                f(src);
            }
            Instr::Call { args, .. } => args.iter_mut().for_each(f),
            Instr::CallPtr { addr, args, .. } => {
                f(addr);
                args.iter_mut().for_each(f);
            }
            Instr::DcacheLineCopy {
                source,
                destination_page,
            } => {
                f(source);
                f(destination_page);
            }
            Instr::DcacheCleanLine { address } => f(address),
            Instr::DevSend { src, .. }
            | Instr::MtsrDseg { src, .. }
            | Instr::StoreSp { src, .. }
            | Instr::StoreLocal { src, .. } => f(src),
            Instr::Jseg { cseg, target } => {
                f(cseg);
                f(target);
            }
            Instr::FpuBin { lhs, rhs, .. } => {
                f(lhs);
                f(rhs);
            }
            Instr::FpuUn { src, .. }
            | Instr::FpuSpecial { src, .. }
            | Instr::FpuMov { src, .. }
            | Instr::FpuToInt { src, .. }
            | Instr::FpuToLo { src, .. }
            | Instr::FpuToHi { src, .. } => f(src),
            Instr::FpuFromInt { src_gpr, .. }
            | Instr::FpuFromLo { src_gpr, .. }
            | Instr::FpuLoad {
                base_gpr: src_gpr, ..
            } => f(src_gpr),
            Instr::FpuFromHi { src, src_gpr, .. } => {
                f(src);
                f(src_gpr);
            }
            Instr::FpuStore { base_gpr, src, .. } => {
                f(base_gpr);
                f(src);
            }
            Instr::FpuVecBin { lhs, rhs, .. } => {
                f(lhs);
                f(rhs);
            }
            Instr::FpuVecMulS { lhs, scalar, .. } => {
                f(lhs);
                f(scalar);
            }
            Instr::FpuVecUn { src, .. } | Instr::FpuVecMove { src, .. } => f(src),
            Instr::FpuVecConstruct { lanes, .. } => lanes.iter_mut().for_each(f),
            Instr::FpuVecLane { src, .. } => f(src),
            Instr::FpuDotStore { lhs, rhs, .. } => {
                f(lhs);
                f(rhs);
            }
            Instr::FpuVecLoad { base_gpr, .. } => f(base_gpr),
            Instr::FpuVecStore { base_gpr, src, .. } => {
                f(base_gpr);
                f(src);
            }
            Instr::LoadImm { .. }
            | Instr::StoreStatic { .. }
            | Instr::DevRecv { .. }
            | Instr::DcacheInvalidateAll
            | Instr::DcacheWait
            | Instr::LoadSp { .. }
            | Instr::LoadLocal { .. }
            | Instr::AddrOfLocal { .. }
            | Instr::LoadFuncAddr { .. }
            | Instr::AddrOfFpuSpill { .. }
            | Instr::Mfsr { .. } => {}
        }
    }
}

impl IntOperand {
    pub fn for_each_reg(&self, f: &mut impl FnMut(VReg)) {
        if let IntOperand::Reg(v) = self {
            f(*v);
        }
    }
    pub fn for_each_reg_mut(&mut self, f: &mut impl FnMut(&mut VReg)) {
        if let IntOperand::Reg(v) = self {
            f(v);
        }
    }
}

impl Cmp {
    fn for_each_use(&self, f: &mut impl FnMut(VReg)) {
        f(self.lhs);
        if let CmpRhs::Reg(r) = &self.rhs {
            f(*r);
        }
    }
    fn for_each_use_mut(&mut self, f: &mut impl FnMut(&mut VReg)) {
        f(&mut self.lhs);
        if let CmpRhs::Reg(r) = &mut self.rhs {
            f(r);
        }
    }
}

#[derive(Clone, Debug, PartialEq)]
pub struct Phi {
    pub dst: VReg,
    pub args: Vec<(BlockId, VReg)>,
}

#[derive(Clone, Debug, PartialEq)]
pub enum Terminator {
    Jmp {
        target: BlockId,
    },
    Br {
        cmp: Cmp,
        if_true: BlockId,
        if_false: BlockId,
    },
    Ret {
        values: Vec<VReg>,
    },
    /// halt with a signal value (main program exit)
    Halt {
        signal: VReg,
    },
    /// CpuV3-only terminal handoff. Codegen must emit the delayed complete
    /// instruction-cache invalidate command immediately followed by JSEG.
    IcacheInvalidateDelayedAndJump {
        cseg: VReg,
        target: VReg,
    },
}

#[derive(Clone, Debug, Default, PartialEq)]
pub struct Block {
    pub phis: Vec<Phi>,
    pub insts: Vec<Instr>,
    /// source line per instruction, parallel to `insts` (debugger line table;
    /// None = no source line, e.g. compiler-generated)
    pub lines: Vec<Option<u32>>,
    /// None while the block is still being built (or unreachable)
    pub term: Option<Terminator>,
    /// source line of the terminator (debuggers map halts/rets/branches too)
    pub term_line: Option<u32>,
    pub preds: Vec<BlockId>,
}

#[derive(Clone, Debug)]
pub struct IrFunc {
    pub name: FuncName,
    /// vregs holding the parameters at function entry (defined by the ABI)
    pub params: Vec<VReg>,
    pub n_rets: usize,
    pub blocks: Vec<Block>,
    pub entry: BlockId,
    pub vreg_count: u32,
    /// source-level names for the disassembly listing (optional)
    pub param_names: Vec<&'static str>,
    pub ret_names: Vec<&'static str>,
    /// per-block role notes for the disassembly listing (loop header, then, ...)
    pub block_notes: Vec<Option<&'static str>>,
    /// per-block source line numbers for the disassembly listing (best effort)
    pub block_lines: Vec<Option<u32>>,
    /// number of frame-local slots assigned by the frontend (address-taken
    /// locals and local arrays); frame layout puts these after callee saves
    /// and before spill slots
    pub local_slots: u8,
    /// register class of every vreg (indexed by vreg id)
    pub vreg_class: Vec<RegClass>,
    /// number of contiguous F registers a vreg occupies (indexed by vreg id):
    /// `1` for every GPR and every scalar `fix32`, `2`/`3`/`4` for a
    /// `vec2`/`vec3`/`vec4` value. The register allocator assigns the range
    /// `base .. base + lanes - 1` and codegen reads the base.
    pub vreg_lanes: Vec<u8>,
}

impl IrFunc {
    /// allocate a fresh vreg of the given class (one lane)
    pub fn fresh_vreg(&mut self, class: RegClass) -> VReg {
        self.fresh_vreg_lanes(class, 1)
    }

    /// allocate a fresh vreg of the given class occupying `lanes` contiguous
    /// F registers (`lanes` must be 1 for a GPR)
    pub fn fresh_vreg_lanes(&mut self, class: RegClass, lanes: u8) -> VReg {
        assert!(
            (1..=4).contains(&lanes),
            "vreg lane count {lanes} is outside 1..=4"
        );
        assert!(
            class == RegClass::Fpu || lanes == 1,
            "a GPR vreg cannot occupy {lanes} registers"
        );
        let v = self.vreg_count;
        self.vreg_count += 1;
        self.vreg_class.push(class);
        self.vreg_lanes.push(lanes);
        v
    }
    /// register class of vreg `v`
    pub fn class_of(&self, v: VReg) -> RegClass {
        self.vreg_class[v as usize]
    }
    /// number of contiguous F registers vreg `v` occupies
    pub fn lanes(&self, v: VReg) -> u8 {
        self.vreg_lanes[v as usize]
    }
    /// whether vreg `v` is a multi-lane FPU vector value
    pub fn is_vector(&self, v: VReg) -> bool {
        self.vreg_lanes[v as usize] > 1
    }

    /// successor blocks of `b` (terminator targets)
    pub fn successors(&self, b: BlockId) -> Vec<BlockId> {
        match &self.blocks[b].term {
            Some(Terminator::Jmp { target }) => vec![*target],
            Some(Terminator::Br {
                if_true, if_false, ..
            }) => vec![*if_true, *if_false],
            _ => vec![],
        }
    }

    /// blocks in reverse post-order starting from entry
    pub fn rpo(&self) -> Vec<BlockId> {
        let mut visited = vec![false; self.blocks.len()];
        let mut post = vec![];
        fn dfs(f: &IrFunc, b: BlockId, visited: &mut [bool], post: &mut Vec<BlockId>) {
            if visited[b] {
                return;
            }
            visited[b] = true;
            for s in f.successors(b) {
                dfs(f, s, visited, post);
            }
            post.push(b);
        }
        dfs(self, self.entry, &mut visited, &mut post);
        post.reverse();
        post
    }
}

fn fmt_vregs(v: &[VReg]) -> String {
    v.iter()
        .map(|r| format!("v{r}"))
        .collect::<Vec<_>>()
        .join(", ")
}

impl fmt::Display for IrFunc {
    fn fmt(&self, f: &mut fmt::Formatter) -> fmt::Result {
        writeln!(
            f,
            "fn {} params=({}) rets={}",
            self.name,
            fmt_vregs(&self.params),
            self.n_rets
        )?;
        for (i, b) in self.blocks.iter().enumerate() {
            let preds = b
                .preds
                .iter()
                .map(|p| format!("b{p}"))
                .collect::<Vec<_>>()
                .join(", ");
            writeln!(f, "b{i}: ; preds=[{preds}]")?;
            for phi in &b.phis {
                let args = phi
                    .args
                    .iter()
                    .map(|(b, v)| format!("(b{b}, v{v})"))
                    .collect::<Vec<_>>()
                    .join(", ");
                writeln!(f, "  v{} = phi [{args}]", phi.dst)?;
            }
            for inst in &b.insts {
                writeln!(f, "  {inst}")?;
            }
            match &b.term {
                Some(t) => writeln!(f, "  {t}")?,
                None => writeln!(f, "  <unterminated>")?,
            }
        }
        Ok(())
    }
}

impl fmt::Display for IntOperand {
    fn fmt(&self, f: &mut fmt::Formatter) -> fmt::Result {
        match self {
            IntOperand::Reg(v) => write!(f, "v{v}"),
            IntOperand::Imm(value) => write!(f, "{value}"),
        }
    }
}

impl fmt::Display for MulWindow {
    fn fmt(&self, f: &mut fmt::Formatter) -> fmt::Result {
        match self {
            MulWindow::Low => write!(f, "mul0"),
            MulWindow::Shift8 => write!(f, "mul8"),
            MulWindow::Shift16 => write!(f, "mul16"),
        }
    }
}

fn fmt_cmp(cmp: &Cmp) -> String {
    let rhs = match &cmp.rhs {
        CmpRhs::Reg(r) => format!("v{r}"),
        CmpRhs::Imm(i) => format!("{i}"),
    };
    let sign = if cmp.signed { "s" } else { "" };
    format!("v{} {}{} {}", cmp.lhs, cond_symbol(cmp.cond), sign, rhs)
}

impl fmt::Display for Instr {
    fn fmt(&self, f: &mut fmt::Formatter) -> fmt::Result {
        match self {
            Instr::Bin { dst, op, lhs, rhs } => {
                let op = match op {
                    BinOp::Add => "add",
                    BinOp::Sub => "sub",
                    BinOp::And => "and",
                    BinOp::Or => "or",
                    BinOp::Xor => "xor",
                };
                write!(f, "v{dst} = {op} v{lhs}, {rhs}")
            }
            Instr::Mul {
                dst,
                window,
                lhs,
                rhs,
            } => write!(f, "v{dst} = {window} v{lhs}, {rhs}"),
            Instr::Un { dst, op, src } => {
                let op = match op {
                    UnOp::Inv => "inv",
                    UnOp::Neg => "neg",
                    UnOp::Not0 => "not0",
                    UnOp::Cnt1 => "cnt1",
                    UnOp::Log2 => "log2",
                    UnOp::Sextb => "sextb",
                    UnOp::Clz => "clz",
                };
                write!(f, "v{dst} = {op} v{src}")
            }
            Instr::Shift {
                dst,
                op,
                src,
                amount,
            } => {
                let op = match op {
                    ShiftOp::Lsl => "lsl",
                    ShiftOp::Lsr => "lsr",
                    ShiftOp::Asr => "asr",
                };
                write!(f, "v{dst} = {op} v{src}, {amount}")
            }
            Instr::Signal { signal_type, value } => {
                write!(f, "signal {signal_type}, v{value}")
            }
            Instr::Mfsr { dst, sr } => {
                if let SpecialReg::DsegPage(index) = sr {
                    return write!(f, "v{dst} = mfsr DSEG{index}");
                }
                let sr = match sr {
                    SpecialReg::Cseg => "CSEG",
                    SpecialReg::Dseg => "DSEG",
                    SpecialReg::DsegPage(_) => unreachable!(),
                };
                write!(f, "v{dst} = mfsr {sr}")
            }
            Instr::Bool { dst, cmp } => write!(f, "v{dst} = bool {}", fmt_cmp(cmp)),
            Instr::CMov {
                dst,
                cmp,
                src,
                fallback,
            } => {
                write!(
                    f,
                    "v{dst} = cmov v{src} if {} else v{fallback}",
                    fmt_cmp(cmp)
                )
            }
            Instr::Mov { dst, src } => write!(f, "v{dst} = mov v{src}"),
            Instr::LoadImm { dst, value } => write!(f, "v{dst} = imm {value}"),
            Instr::LoadMem { dst, base, offset } => write!(f, "v{dst} = load [v{base} + {offset}]"),
            Instr::StoreMem { base, offset, src } => {
                write!(f, "store [v{base} + {offset}] = v{src}")
            }
            Instr::StoreStatic { addr, value } => write!(f, "static[{addr:#06x}] = {value:#06x}"),
            Instr::Call { func, args, rets } => {
                write!(
                    f,
                    "({}) = call {}({})",
                    fmt_vregs(rets),
                    func,
                    fmt_vregs(args)
                )
            }
            Instr::LoadFuncAddr { dst, func } => write!(f, "v{dst} = &{func}"),
            Instr::CallPtr { addr, args, rets } => {
                write!(
                    f,
                    "({}) = call_ptr v{}({})",
                    fmt_vregs(rets),
                    addr,
                    fmt_vregs(args)
                )
            }
            Instr::DevRecv {
                dst,
                device,
                channel,
            } => write!(f, "v{dst} = dev_recv {device}, {channel}"),
            Instr::DevSend {
                device,
                channel,
                src,
            } => write!(f, "dev_send {device}, {channel}, v{src}"),
            Instr::DcacheInvalidateAll => write!(f, "dcache_invalidate_all"),
            Instr::DcacheLineCopy {
                source,
                destination_page,
            } => write!(f, "dcache_line_copy v{source}, v{destination_page}"),
            Instr::DcacheCleanLine { address } => write!(f, "dcache_clean_line v{address}"),
            Instr::DcacheWait => write!(f, "dcache_wait"),
            Instr::MtsrDseg { src, index } => match index {
                Some(i) => write!(f, "mtsr_dseg_page {i}, v{src}"),
                None => write!(f, "mtsr_dseg v{src}"),
            },
            Instr::Jseg { cseg, target } => write!(f, "jseg v{cseg}, v{target}"),
            Instr::LoadSp { dst, slot } => write!(f, "v{dst} = load_sp #{slot}"),
            Instr::StoreSp { slot, src } => write!(f, "store_sp #{slot} = v{src}"),
            Instr::LoadLocal { dst, slot } => write!(f, "v{dst} = load_local #{slot}"),
            Instr::StoreLocal { slot, src } => write!(f, "store_local #{slot} = v{src}"),
            Instr::AddrOfLocal { dst, slot } => write!(f, "v{dst} = &local #{slot}"),
            Instr::FpuBin { dst, op, lhs, rhs } => {
                let op = match op {
                    FpuBinOp::Add => "fadd",
                    FpuBinOp::Sub => "fsub",
                    FpuBinOp::Mul => "fmul",
                };
                write!(f, "v{dst} = {op} v{lhs}, v{rhs}")
            }
            Instr::FpuUn { dst, op, src } => {
                let op = match op {
                    FpuUnOp::Abs => "fabs",
                    FpuUnOp::Neg => "fneg",
                    FpuUnOp::Floor => "ffloor",
                    FpuUnOp::Ceil => "fceil",
                    FpuUnOp::Round => "fround",
                    FpuUnOp::Trunc => "ftrunc",
                };
                write!(f, "v{dst} = {op} v{src}")
            }
            Instr::FpuSpecial { dst, op, src } => {
                let op = match op {
                    FpuSpecialOp::Rcp => "frcp",
                    FpuSpecialOp::Rsqrt => "frsqrt",
                    FpuSpecialOp::Sin => "fsin",
                    FpuSpecialOp::Cos => "fcos",
                    FpuSpecialOp::SinCos => "fsincos",
                };
                write!(f, "v{dst} = {op} v{src}")
            }
            Instr::FpuMov { dst, src } => write!(f, "v{dst} = fmov v{src}"),
            Instr::FpuFromInt { dst, src_gpr } => write!(f, "v{dst} = ffromint v{src_gpr}"),
            Instr::FpuToInt { dst_gpr, src } => write!(f, "v{dst_gpr} = ftoint v{src}"),
            Instr::FpuFromLo { dst, src_gpr } => write!(f, "v{dst} = ffromlo v{src_gpr}"),
            Instr::FpuFromHi { dst, src, src_gpr } => {
                write!(f, "v{dst} = ffromhi v{src}, v{src_gpr}")
            }
            Instr::FpuToLo { dst_gpr, src } => write!(f, "v{dst_gpr} = ftolo v{src}"),
            Instr::FpuToHi { dst_gpr, src } => write!(f, "v{dst_gpr} = ftohi v{src}"),
            Instr::FpuLoad {
                dst,
                base_gpr,
                offset,
            } => write!(f, "v{dst} = fld [v{base_gpr} + {offset}]"),
            Instr::FpuStore {
                base_gpr,
                offset,
                src,
            } => write!(f, "fst [v{base_gpr} + {offset}] = v{src}"),
            Instr::FpuVecBin { dst, op, lhs, rhs } => {
                let op = match op {
                    FpuBinOp::Add => "vadd",
                    FpuBinOp::Sub => "vsub",
                    FpuBinOp::Mul => "vmul",
                };
                write!(f, "v{dst} = {op} v{lhs}, v{rhs}")
            }
            Instr::FpuVecMulS { dst, lhs, scalar } => {
                write!(f, "v{dst} = vmuls v{lhs}, v{scalar}")
            }
            Instr::FpuVecUn { dst, op, src } => {
                let op = match op {
                    FpuVecUnOp::Abs => "vabs",
                    FpuVecUnOp::Neg => "vneg",
                };
                write!(f, "v{dst} = {op} v{src}")
            }
            Instr::FpuVecMove { dst, src } => write!(f, "v{dst} = vmov v{src}"),
            Instr::FpuVecConstruct { dst, lanes } => {
                write!(f, "v{dst} = vconstruct [{}]", fmt_vregs(lanes))
            }
            Instr::FpuVecLane { dst, src, lane } => {
                write!(f, "v{dst} = vlanes v{src}[{lane}]")
            }
            Instr::FpuDotStore { dst, lhs, rhs } => {
                write!(f, "v{dst} = dotstore v{lhs}, v{rhs}")
            }
            Instr::FpuVecLoad {
                dst,
                base_gpr,
                offset,
            } => write!(f, "v{dst} = fldv [v{base_gpr} + {offset}]"),
            Instr::FpuVecStore {
                base_gpr,
                offset,
                src,
            } => write!(f, "fstv [v{base_gpr} + {offset}] = v{src}"),
            Instr::AddrOfFpuSpill { dst, slot } => write!(f, "v{dst} = &fpu_spill #{slot}"),
        }
    }
}

pub(crate) fn cond_symbol(cond: CompareOp) -> &'static str {
    match cond {
        CompareOp::Never => "never",
        CompareOp::Greater => ">",
        CompareOp::Equal => "==",
        CompareOp::Less => "<",
        CompareOp::GreaterEqual => ">=",
        CompareOp::NotEqual => "!=",
        CompareOp::LessEqual => "<=",
        CompareOp::Always => "always",
    }
}

impl fmt::Display for Terminator {
    fn fmt(&self, f: &mut fmt::Formatter) -> fmt::Result {
        match self {
            Terminator::Jmp { target } => write!(f, "jmp b{target}"),
            Terminator::Br {
                cmp,
                if_true,
                if_false,
            } => {
                let rhs = match &cmp.rhs {
                    CmpRhs::Reg(r) => format!("v{r}"),
                    CmpRhs::Imm(i) => format!("{i}"),
                };
                let sign = if cmp.signed { "s" } else { "" };
                write!(
                    f,
                    "br v{} {}{} {} -> b{}, b{}",
                    cmp.lhs,
                    cond_symbol(cmp.cond),
                    sign,
                    rhs,
                    if_true,
                    if_false
                )
            }
            Terminator::Ret { values } => write!(f, "ret [{}]", fmt_vregs(values)),
            Terminator::Halt { signal } => write!(f, "halt v{signal}"),
            Terminator::IcacheInvalidateDelayedAndJump { cseg, target } => {
                write!(f, "icache_invalidate_delayed_and_jump v{cseg}, v{target}")
            }
        }
    }
}
