misdake/DigitalDesign/ip/cpu-v3/src/hardware/cache/cpu_v3_two_way_cache.v

module CpuV3TwoWayCache (
    input wire clk,
    input wire reset,
    input wire invalidate_all,
    input wire cpu_request_valid,
    input wire cpu_write,
    input wire [31:0] cpu_address,
    input wire [15:0] cpu_write_data,
    input wire cpu_response_ready,
    input wire memory_request_ready,
    input wire memory_response_valid,
    input wire [63:0] memory_read_data,
    input wire memory_error,
    output wire cpu_request_ready,
    output wire cpu_response_valid,
    output wire [15:0] cpu_read_data,
    output wire cpu_error,
    output wire memory_request_valid,
    output wire memory_write,
    output wire memory_line,
    output wire [21:0] memory_address,
    output wire [63:0] memory_write_data,
    output wire memory_response_ready
);

// A read miss issues one aligned line request and receives exactly four
// ordered 64-bit beats; beat n carries words 4*n through 4*n+3. A write
// issues one word request and receives one
// completion response. An error beat terminates a line response early; no
// further beats follow it. Each line beat writes four words directly through
// the two ports of each parity bank. The victim remains invalid until the
// final error-free beat commits its tag.

localparam [3:0] ST_IDLE = 0;
localparam [3:0] ST_WORD_REQUEST = 3;
localparam [3:0] ST_WORD_RESPONSE = 4;
localparam [3:0] ST_LINE_REQUEST = 5;
localparam [3:0] ST_LINE_RECEIVE = 6;

reg [3:0] state = ST_IDLE;
reg lookup_valid = 0;
reg pending_write = 0;
reg [31:0] pending_address = 0;
reg [15:0] pending_write_data = 0;
reg [2:0] refill_beat = 0;
reg pending_way = 0;
// A miss owns the already-free final response slot. Capture the requested
// word there as its beat arrives, but publish valid only after all four
// error-free beats. A later error replaces the speculative payload with zero.
reg [15:0] response_data = 0;
reg response_error = 0;
reg response_valid = 0;
reg refill_discard = 0;
// Tags, validity and the way-zero victim bit share one synchronous metadata
// DPB. Its two ports read the two ways alongside the data lookup. Sweep
// writes hold both old Q values; one pending-lookup bit records whether its
// set has since been cleared, preserving lookup behavior under backpressure.
reg sweep_active = 0;
reg [5:0] sweep_set = 0;
reg lookup_invalidated = 0;
wire [15:0] meta0, meta1;
wire way_0_valid_read = meta0[12] && !lookup_invalidated;
wire way_1_valid_read = meta1[12] && !lookup_invalidated;
wire victim_read = meta0[14];

wire pending_address_valid = pending_address[31:22] == 0;

wire [5:0] pending_set = pending_address[9:4];
wire [11:0] pending_tag = pending_address[21:10];
wire [3:0] pending_word = pending_address[3:0];
wire [11:0] way_0_tag_read_data = meta0[11:0];
wire [11:0] way_1_tag_read_data = meta1[11:0];
wire [5:0] cache_lookup_set;
wire invalidating = invalidate_all || sweep_active;
// The sweep blocks new requests through cpu_request_ready, so hit
// qualification does not need its own `!invalidating` term. Keeping the gate
// off this expression removes a LUT level from the tight fetch-frontend to
// I-cache way-valid path that the old instant valid clear did not pay.
wire way_0_hit = way_0_valid_read && way_0_tag_read_data == pending_tag;
wire way_1_hit = way_1_valid_read && way_1_tag_read_data == pending_tag;
wire pending_hit = way_0_hit || way_1_hit;
wire hit_way = !way_0_hit && way_1_hit;
wire selected_victim = !way_0_valid_read ? 1'b0 :
                       !way_1_valid_read ? 1'b1 : victim_read;
wire refill_commit = state == ST_LINE_RECEIVE && memory_response_valid &&
                        !memory_error && refill_beat == 3 &&
                        !refill_discard && !invalidating;
wire invalidate_victim = state == ST_LINE_REQUEST;
wire meta_write0 = sweep_active || refill_commit || (invalidate_victim && !pending_way);
wire meta_write1 = sweep_active || (pending_way && (refill_commit || invalidate_victim));
wire [5:0] meta_write_set = sweep_active ? sweep_set : pending_set;
wire [15:0] install_word = {1'b0,!pending_way,1'b0,1'b1,pending_tag};
wire [15:0] meta_word0 = sweep_active ? 16'b0 : refill_commit ?
    (pending_way ? (meta0 & 16'hbfff) : install_word) : (meta0 & 16'hefff);
wire [15:0] meta_word1 = sweep_active ? 16'b0 : refill_commit ?
    install_word : (meta1 & 16'hefff);
__CACHE_METADATA__ u_metadata (
    .clk(clk), .read_set(cache_lookup_set),
    .write_0(meta_write0), .write_set_0(meta_write_set), .write_data_0(meta_word0),
    .write_1(meta_write1), .write_set_1(meta_write_set), .write_data_1(meta_word1),
    .q0(meta0), .q1(meta1)
);

wire response_space = !response_valid || cpu_response_ready;
wire hit_write = state == ST_IDLE && lookup_valid && pending_write && pending_hit &&
                 response_space && !invalidating;
wire refill_write = state == ST_LINE_RECEIVE && memory_response_valid && !memory_error &&
                    !refill_discard && !invalidating;
// Start both candidate-way reads on the request-acceptance edge. The data and
// parallel tag comparison are therefore ready when the lookup resolves on the
// following cycle.
wire lookup_read_hit = lookup_valid && pending_address_valid &&
                       !pending_write && pending_hit;
assign cpu_request_ready = !invalidate_all && !sweep_active &&
    (state == ST_IDLE && (!lookup_valid || lookup_read_hit && response_space));
wire accept_cpu_request = cpu_request_valid && cpu_request_ready;
wire [31:0] cache_lookup_address = accept_cpu_request ? cpu_address :
                                   pending_address;
assign cache_lookup_set = cache_lookup_address[9:4];
wire [3:0] cache_lookup_word = cache_lookup_address[3:0];
wire [9:0] lookup_way_0_address = {1'b0, cache_lookup_set, cache_lookup_word[3:1]};
wire [9:0] lookup_way_1_address = {1'b1, cache_lookup_set, cache_lookup_word[3:1]};
wire [9:0] refill_address_a = {pending_way, pending_set, refill_beat[1:0], 1'b0};
wire [9:0] refill_address_b = {pending_way, pending_set, refill_beat[1:0], 1'b1};
wire [9:0] hit_write_address = {hit_way, pending_set, pending_word[3:1]};
wire [15:0] bank_0_a_read_data, bank_0_b_read_data;
wire [15:0] bank_1_a_read_data, bank_1_b_read_data;
wire [15:0] way_0_cache_read_data = pending_word[0] ?
    bank_1_a_read_data : bank_0_a_read_data;
wire [15:0] way_1_cache_read_data = pending_word[0] ?
    bank_1_b_read_data : bank_0_b_read_data;
wire [15:0] cache_read_data = hit_way ? way_1_cache_read_data : way_0_cache_read_data;

__CACHE_DATA_BANKS__ u_data_banks (
    .clk(clk),
    .bank_0_a_write_enable(refill_write || (hit_write && !pending_word[0])),
    .bank_0_a_address(refill_write ? refill_address_a :
        (hit_write && !pending_word[0] ? hit_write_address : lookup_way_0_address)),
    .bank_0_a_write_data(refill_write ? memory_read_data[15:0] : pending_write_data),
    .bank_0_a_read_data(bank_0_a_read_data),
    .bank_0_b_write_enable(refill_write),
    .bank_0_b_address(refill_write ? refill_address_b : lookup_way_1_address),
    .bank_0_b_write_data(memory_read_data[47:32]),
    .bank_0_b_read_data(bank_0_b_read_data),
    .bank_1_a_write_enable(refill_write || (hit_write && pending_word[0])),
    .bank_1_a_address(refill_write ? refill_address_a :
        (hit_write && pending_word[0] ? hit_write_address : lookup_way_0_address)),
    .bank_1_a_write_data(refill_write ? memory_read_data[31:16] : pending_write_data),
    .bank_1_a_read_data(bank_1_a_read_data),
    .bank_1_b_write_enable(refill_write),
    .bank_1_b_address(refill_write ? refill_address_b : lookup_way_1_address),
    .bank_1_b_write_data(memory_read_data[63:48]),
    .bank_1_b_read_data(bank_1_b_read_data)
);

assign cpu_response_valid = response_valid;
assign cpu_read_data = response_data;
assign cpu_error = response_valid && response_error;
assign memory_request_valid = state == ST_WORD_REQUEST || state == ST_LINE_REQUEST;
assign memory_write = pending_write;
assign memory_line = !pending_write;
assign memory_address = pending_write ? pending_address[21:0] :
                        {pending_address[21:4], 4'b0};
assign memory_write_data = {48'b0, pending_write_data};
assign memory_response_ready = state == ST_WORD_RESPONSE || state == ST_LINE_RECEIVE;

always @(posedge clk) begin
    if (reset) begin
        state <= ST_IDLE;
        lookup_valid <= 0;
        response_error <= 0;
        response_valid <= 0;
        refill_discard <= 0;
        sweep_active <= 0;
        sweep_set <= 0;
        lookup_invalidated <= 0;
    end else begin
        if (response_valid && cpu_response_ready)
            response_valid <= 0;
        if (invalidate_all) begin
            sweep_active <= 1;
            sweep_set <= 0;
        end else if (sweep_active) begin
            sweep_set <= sweep_set + 1'b1;
            if (sweep_set == 63)
                sweep_active <= 0;
        end
        if (sweep_active && sweep_set == pending_set)
            lookup_invalidated <= 1;
        case (state)
            ST_IDLE: begin
                if (lookup_valid && response_space) begin
                    if (!pending_address_valid) begin
                        response_data <= 0;
                        response_error <= 1;
                        response_valid <= 1;
                        lookup_valid <= 0;
                    end else if (pending_write) begin
                        lookup_valid <= 0;
                        state <= ST_WORD_REQUEST;
                    end else if (pending_hit) begin
                        response_data <= cache_read_data;
                        response_error <= 0;
                        response_valid <= 1;
                        lookup_valid <= 0;
                    end else begin
                        lookup_valid <= 0;
                        pending_way <= selected_victim;
                        refill_beat <= 0;
                        // An invalidate coincident with miss detection
                        // belongs to the old fetch epoch. Complete its
                        // protocol response, but never install the line.
                        refill_discard <= invalidate_all;
                        state <= ST_LINE_REQUEST;
                    end
                end
            end

            ST_WORD_REQUEST: if (memory_request_ready)
                state <= ST_WORD_RESPONSE;

            ST_WORD_RESPONSE: if (memory_response_valid) begin
                response_data <= 0;
                response_error <= memory_error;
                response_valid <= 1;
                state <= ST_IDLE;
            end

            ST_LINE_REQUEST: begin
                if (memory_request_ready) begin
                    refill_beat <= 0;
                    state <= ST_LINE_RECEIVE;
                end
            end

            ST_LINE_RECEIVE: if (memory_response_valid) begin
                if (memory_error) begin
                    response_data <= 0;
                    response_error <= 1;
                    response_valid <= 1;
                    state <= ST_IDLE;
                end else begin
                    if (refill_beat == pending_word[3:2])
                        case (pending_word[1:0])
                            0: response_data <= memory_read_data[15:0];
                            1: response_data <= memory_read_data[31:16];
                            2: response_data <= memory_read_data[47:32];
                            default: response_data <= memory_read_data[63:48];
                        endcase
                    if (refill_beat == 3) begin
                    response_error <= 0;
                    response_valid <= 1;
                    state <= ST_IDLE;
                    end else refill_beat <= refill_beat + 1'b1;
                end
            end

            default: state <= ST_IDLE;
        endcase

        if (accept_cpu_request) begin
            lookup_invalidated <= 0;
            pending_write <= cpu_write;
            pending_address <= cpu_address;
            pending_write_data <= cpu_write_data;
            // A successor owns lookup state, not the still-held response.
            // Publish data/error together only when that response slot is free.
            refill_discard <= 0;
            lookup_valid <= 1;
        end

        if (invalidate_all) begin
            if (state == ST_LINE_REQUEST || state == ST_LINE_RECEIVE)
                refill_discard <= 1;
        end
    end
end

endmodule
