misdake/DigitalDesign/ip/cpu-v3/src/hardware/fpu/cpu_v3_fpu_exec_special.v

// Single phase calendar: RCP normalize/read -> interpolate -> write;
// SINCOS range -> LUT -> interpolate -> write (+dual beat).
module CpuV3FpuExecSpecial (
    input wire clk,
    input wire abort,
    input wire instr_complete,
    input wire [3:0] instr_opcode,
    input wire [15:0] word1_raw,
    input wire [31:0] rf_read_a_data,
    input wire [31:0] rf_read_b_data,
    output wire [8:0] rf_read_a_address,
    output wire [8:0] rf_read_b_address,
    output wire rf_write_enable,
    output wire [8:0] rf_write_address,
    output wire [31:0] rf_write_data,
    output wire busy,
    output wire [3:0] r_wait,
    output wire [3:0] w_wait,
    output wire [3:0] x_wait,
    output wire mul_in_valid,
    output wire signed [35:0] mul_in_a,
    output wire signed [35:0] mul_in_b,
    output wire [8:0] mul_in_tag,
    input wire mul_out_valid,
    input wire signed [63:0] mul_out_product,
    input wire [8:0] mul_out_tag
);

wire [5:0] subop = word1_raw[9:4];
wire [5:0] fd = word1_raw[15:10];
wire [1:0] mode = word1_raw[1:0];
wire mode_single = mode[0] ^ mode[1];

wire is_scalar = (instr_opcode == 4'hD);
wire is_rcp = is_scalar && (subop == 6'h0C);
wire is_rsqrt = is_scalar && (subop == 6'h0D);
wire is_sincos = is_scalar && (subop == 6'h0E);
wire is_special = is_rcp || is_rsqrt || is_sincos;

wire load_now = instr_complete && is_special && !abort;
reg [2:0] phase = 0;
// Capture only the function family at the existing launch edge. Late math
// consumes this owner instead of decoding the frontend words through writeback.
reg active_rcp = 0, active_sincos = 0;

wire [31:0] x0 = rf_read_a_data;
wire x0_negative = x0[31];
wire [31:0] x0_magnitude = x0_negative ? (~x0 + 32'd1) : x0;

wire p0_valid = load_now && !is_sincos;
wire p0_rcp = is_rcp;
reg p0_negative = 1'b0;
wire [31:0] p0_magnitude = x0_magnitude;


wire p0_zero = (p0_magnitude == 32'd0);

// Find the leading one while carrying the only normalized window consumed
// by lookup/interpolation. Each stage discards bits below the reach of all
// remaining shifts, rather than shifting the original word a second time.
wire norm_by16 = p0_magnitude[31:16] == 0;
wire [31:0] norm16 = norm_by16 ? {p0_magnitude[15:0],16'd0} : p0_magnitude;
wire norm_by8 = norm16[31:24] == 0;
wire [23:0] norm8 = norm_by8 ? norm16[23:0] : norm16[31:8];
wire norm_by4 = norm8[23:20] == 0;
wire [19:0] norm4 = norm_by4 ? norm8[19:0] : norm8[23:4];
wire norm_by2 = norm4[19:18] == 0;
wire [17:0] norm2 = norm_by2 ? norm4[17:0] : norm4[19:2];
wire norm_by1 = !norm2[17];
wire [15:0] norm_window = norm_by1 ? norm2[15:0] : norm2[16:1];
wire [5:0] clz = p0_zero ? 6'd32 :
    {1'b0,norm_by16,norm_by8,norm_by4,norm_by2,norm_by1};
wire [6:0] norm_index = norm_window[15:9];
wire [8:0] norm_residue = norm_window[8:0];

// Align the interpolated magnitude at bit 16 of a 33-bit window. The
// final RCP exponent is CLZ-15; RSQRT uses its rounded half exponent. Encode
// the required right-window position directly, rather than direction/distance.
// RCP CLZ=32 is zero and is handled by s1_zero before architectural writeback.
wire [4:0] scale_distance = p0_rcp ? ~clz[4:0] : (5'd23 - clz[5:1]);
wire rsqrt_odd = !clz[0];

wire [8:0] table_address = p0_rcp
    ? {2'b01, norm_index}
    : (rsqrt_odd ? {2'b10, norm_index} : {2'b01, norm_index});

wire s1_valid = phase == 1 && !active_sincos;
reg [8:0] s1_residue = 9'd0;
reg [4:0] s1_scale_distance = 5'd0;
reg s1_zero = 1'b0;

reg [1:0] meta_flags = 0;
reg [16:0] meta_s1_base = 17'd0;
wire rcp_return = mul_out_valid && phase == 2 && !active_sincos;
wire sc_return = mul_out_valid && active_sincos && (phase == 3 || phase == 4);
wire [16:0] s2_interpolated;

localparam [35:0] SINCOS_K = 36'h0_A2F9836E;

wire sc_valid = phase != 0 && active_sincos;
wire [2:0] sc_stage = phase;

wire [1:0] sc_mode = mode;

// The DSP range product remains held until the first interpolation issue.
wire [17:0] sc_phase_reg = mul_out_product[49:32];
wire [1:0] sc_q = sc_phase_reg[17:16];
wire [15:0] sc_f = sc_phase_reg[15:0];
reg [9:0] second_parameters = 0;
wire [16:0] sc_u_sin = sc_q[0]
    ? (17'h10000 - {1'b0, sc_f})
    : {1'b0, sc_f};
wire [16:0] sc_u_cos = sc_q[0]
    ? {1'b0, sc_f}
    : (17'h10000 - {1'b0, sc_f});
wire sc_single = sc_mode[0] ^ sc_mode[1];
wire sc_first_is_cos = sc_mode[1] && !sc_mode[0];
wire sc_interp_is_cos = sc_first_is_cos || (!sc_single && (sc_stage == 3'd3));
wire second_issue = sc_valid && phase == 3;
wire [16:0] sc_interp_u = second_issue ? {second_parameters[8],8'd0,second_parameters[7:0]} :
    sc_interp_is_cos ? sc_u_cos : sc_u_sin;
wire signed [17:0] sc_residue_ext = $signed({10'b0, sc_interp_u[7:0]});

wire [16:0] sc_current = rf_read_a_data[16:0];
wire signed [9:0] sc_delta_raw = $signed(rf_read_a_data[26:17]);
wire signed [17:0] sc_delta_ext = {{8{sc_delta_raw[9]}}, sc_delta_raw};

wire signed [17:0] mul_x;
wire signed [17:0] mul_y;
wire [16:0] interval_current;
wire sc_result_sign;
wire interp_issue = s1_valid || (sc_valid &&
    (sc_stage == 3'd2 || (!sc_single && sc_stage == 3'd3)));
wire range_issue = load_now && is_sincos;
assign mul_in_valid = (range_issue || interp_issue) && !abort;
assign mul_in_a = range_issue ? $signed({{4{x0[31]}}, x0})
    : $signed({{18{mul_x[17]}}, mul_x});
assign mul_in_b = range_issue ? $signed(SINCOS_K)
    : $signed({{18{mul_y[17]}}, mul_y});
assign mul_in_tag = range_issue ? 9'h081 : 9'h080;
always @(posedge clk) begin
    if (!abort && interp_issue) begin
        meta_s1_base <= sc_valid ? sc_current : interval_current;
        meta_flags <= {sc_interp_u[16],sc_result_sign};
    end
end

wire [31:0] packed_interval = active_rcp ? rf_read_a_data : rf_read_b_data;
assign interval_current = packed_interval[16:0];
wire signed [9:0] interval_delta = $signed(packed_interval[26:17]);
wire signed [17:0] interp_delta = {{8{interval_delta[9]}}, interval_delta};
wire signed [17:0] interp_residue = $signed({9'b0, s1_residue});

assign mul_x = sc_valid ? sc_delta_ext : interp_delta;
assign mul_y = sc_valid ? sc_residue_ext : interp_residue;
wire signed [35:0] mul_product = mul_out_product[35:0];

wire [16:0] sc_addr_u = ((sc_stage == 3'd2) || sc_first_is_cos)
    ? sc_u_cos
    : sc_u_sin;
wire [8:0] sc_lut_address = 9'd256 + {1'b0, sc_addr_u[15:8]};

wire signed [35:0] interp_shifted = mul_product >>> 9;
wire signed [9:0] interp_correction = interp_shifted[9:0];
wire signed [35:0] sc_interp_shifted = mul_product >>> 8;
// Both final consumers use only the low 17 sum bits. Preserve RCP's signed
// ten-bit correction truncation before extending; SINCOS consumes the low
// 17 bits after its own signed shift. The shared add is exact modulo 2^17
// for arbitrary product bits, independently of interpolation value bounds.
wire [16:0] return_correction = sc_valid ? sc_interp_shifted[16:0] :
    {{7{interp_correction[9]}},interp_correction};
wire [16:0] return_interpolated = meta_s1_base + return_correction;
assign s2_interpolated = return_interpolated;
wire [16:0] sc_interp_mag = meta_flags[1] ? 17'h10000 : return_interpolated;
assign sc_result_sign = second_issue ? second_parameters[9] :
    sc_interp_is_cos ? (sc_q[1] ^ sc_q[0]) : sc_q[1];
wire sc_write = sc_valid && sc_return && !abort;

// One right-shifted window produces both scaling directions without data
// reversal muxes. Preserve bit 32 and bit 31 until reciprocal saturation;
// the existing magnitude/sign and zero/invalid overrides consume this result.
wire [32:0] scale_result = {s2_interpolated,16'd0} >> s1_scale_distance;
wire rcp_left_overflow = |scale_result[32:31];
wire [31:0] scaled = active_rcp && rcp_left_overflow
    ? 32'h7FFFFFFF : scale_result[31:0];
// Select the final architectural magnitude/sign before a single 32-bit
// conditional negation. A 17-bit SINCOS magnitude fits signed18, so zero
// extension followed by negation is exactly its old sign-extended result.
// Reciprocal right-shift/saturation precede sign; zero/invalid RSQRT overrides
// still have priority over the signed result, except for a live SINCOS write.
wire [31:0] result_magnitude = sc_write ? {15'd0,sc_interp_mag} : scaled;
wire result_negative = sc_write ? meta_flags[0] : (active_rcp && p0_negative);
wire [31:0] signed_result = result_negative ? (~result_magnitude + 32'd1) : result_magnitude;
wire [31:0] zero_result = active_rcp ?
    (p0_negative ? 32'h80000001 : 32'h7FFFFFFF) : 32'd0;



assign rf_read_a_address = (p0_valid && p0_rcp) ? table_address
                         : (sc_valid && (sc_stage == 3'd1
                             || (!sc_single && (sc_stage == 3'd2))))
                             ? sc_lut_address
                             : 9'd0;
assign rf_read_b_address = (p0_valid && !p0_rcp) ? table_address : 9'd0;

always @(posedge clk) begin
    if (abort) phase <= 0;
    else if (load_now) begin
        phase <= 1;
        active_rcp <= is_rcp;
        active_sincos <= is_sincos;
        if (!is_sincos) begin
            p0_negative <= x0_negative;
        end
    end else if (phase != 0) begin
        if ((!active_sincos && phase == 2) || (active_sincos &&
            ((sc_single && phase == 3) || phase == 4))) phase <= 0;
        else phase <= phase + 3'd1;

    end
    if (!abort && p0_valid) begin
        s1_residue <= norm_residue;
        s1_scale_distance <= scale_distance;
        s1_zero <= p0_rcp ? p0_zero : (x0_negative || p0_zero);
    end
    if (!abort && sc_valid && phase == 2)
        second_parameters <= {sc_q[1]^sc_q[0],sc_u_cos[16],sc_u_cos[7:0]};
end

assign rf_write_enable = (rcp_return || sc_write) && !abort;
assign rf_write_address = {8'd0,sc_write && phase == 4};
assign rf_write_data = !sc_write && s1_zero ? zero_result : signed_result;

assign busy = (load_now || phase != 0) && !abort;

assign r_wait = 4'd0;
assign w_wait = load_now ? (is_sincos ? (mode_single ? 4'd4 : 4'd5)
    : 4'd3) : 4'd0;
assign x_wait = load_now ? (is_sincos ? (mode_single ? 4'd4 : 4'd5)
    : 4'd3) : 4'd0;

endmodule
