misdake/DigitalDesign/(commit log)

2022-10-29 fix reg update. add flipflop.
    [basic.rs, main.rs, reg.rs]
2022-11-13 Wires impl copy
2022-12-15 fix pc, add pc test. move shared util upper.
    [main.rs, mod.rs]
2023-01-15 constant wire for 0 and 1.
2023-01-15 add eq_const for Wires.
2023-03-26 finish decoder hw impl. replace enum values with bit indices.
    [mod.rs, reg.rs]
2023-03-28 add decoder test framework. add decoder alu tests. fix decoder bugs.
    [mod.rs]
2023-03-28 test all current instructions.
2023-04-02 test regfile. fix cpu reg init.
    [mod.rs]
2023-04-02 wire/reg impl debug. test regs.
2023-04-02 test binary. refine wires debug.
2023-04-03 test jmp. fix conditional branch. fix next pc emu.
    [mod.rs, wires.rs]
2023-04-03 test loop, test mem. fix jg.
    [mod.rs]
2023-04-05 test mem bank. fix test callback.
    [mod.rs]
2023-04-08 print circuit statistics.
2023-04-15 impl bus and basic device. (not tested)
2023-04-23 set correct output latency for component emu. simplify latency calculation. impl grouped gates by latency value with parallel exec (to be optimized).
    [basic.rs, mod.rs, wires.rs]
2023-04-30 wip. refine Device interface. support bus read to reg0.
2023-05-01 move devices to dir. add basic test. fix decoder.
    [mod.rs]
2023-05-01 support set_bus_addr inst. pass device print test.
2023-05-01 add and pass device math test.
2023-05-01 fix mem emu. refine test.
    [mod.rs]
2023-07-02 refine device registering.
2023-07-03 rewrite frame_id.
2023-07-08 support two bus devices
2023-07-08 use two bus devices.
2023-07-10 design assembler api.
2023-07-11 more assembler impl.
2023-07-12 finish basic assembler impl.
2023-07-14 try assembler.
2023-07-14 repurpose device print.
2023-10-03 reg support. fix gate.
    [basic.rs, mod.rs, verilog_module.rs]
2023-10-31 add device rom.
2023-11-02 replace je with jne.
    [mod.rs]
2023-11-13 replace test_cpu with test_cpu_with_emu.
    [main.rs, mod.rs]
2023-11-14 more sokoban code with several assembler improvements:
    sokoban:
    reorganize map memory to simplify instructions
    implement basic gameloop and gamewin fn. (gameplay wip.)
    assmebler:
    write rename InstructionType->InstructionSlot
    rewrite asm.func
    split func decl/impl
    fix gamepadstate nextframe
    fix graphicsv1 "vsync"
    [mod.rs]
2023-11-19 wip sokoban gameplay. add if to assembler.
2023-11-19 add push and move (buggy). add debug print. skip gamelogic if no input. fix dy. fix gameloop typo.
    [mod.rs]
2024-03-08 replace prev isa impl.
    [lib.rs, main.rs, sim.rs]
2024-03-25 complete sim (except device). rewrite StateChange.
2024-03-26 fix i4 and i8.
    [sim.rs]
2024-04-19 (wip) extract Circuit struct. super wip.
2024-04-24 (wip) extract Circuit struct.
2024-04-28 extract Circuit struct probably done.
2024-04-29 begin assembler.
2024-04-30 wip. tweak isa. basic assembler structs.
2024-05-02 more assembler.
2024-05-02 add jmp/call to assembler.
2024-05-06 move to assembler1.
2024-05-07 add variable/register allocator. rename assembler dir.
2024-05-08 prepare for control flow.
2024-05-09 prepare for control flow. better variable lifetime.
2024-05-17 redesign register allocator1. simplify ValidReg. save living/ever_allocated registers to ro1.
    [mod.rs]
2024-06-06 impl func + return. fix restore. test basic_program.
    [mod.rs]
2024-06-08 test spill. fix move_items.
    [lib.rs]
2024-06-08 write ro to assembler.
2024-06-08 fix print and clippy.
2024-06-08 tweak inst print.
2024-06-13 print sim change.
2024-06-15 halt with a signal to help testing. fix if and loop condition. fix compose lock.
    [mod.rs, sim.rs]
2024-06-16 multiply func. fix neg. add initial ptr & array code.
    [mod.rs, sim.rs]
2024-06-21 fix if. improve flag print. fix sub sim.
    [sim.rs]
2024-06-26 fix heap. add mem_set, mem_copy.
    [mod.rs]
2024-07-06 more vec impl. refine struct. skip move-to-self instructions.
    [lib.rs]
2024-09-02 better function asm printer. fix assert. add basic vec test (wip).
    [mod.rs]
2024-09-02 better function asm printer.
2026-07-18 export Exporter trait. use sparse registry. fix heap test alloc_size.
    [mod.rs]
2026-07-18 isa v2.6: mask-based j_cc, fixed-ra calls (call_rel/call_abs), sp_add/sp_sub, store_sp/load_sp, zero-less addi, n3 regroup.
    [sim.rs]
2026-07-18 programmer2 M1: SSA/CFG IR + Braun-style FuncBuilder with structured control flow
2026-07-18 programmer2 M2: backend skeleton (linear-scan regalloc with ABI shims, on-demand frames, codegen, Compiler2 driver)
2026-07-18 programmer2 M5: optimization passes (const-prop/CSE/DCE), mov coalescing, branch relaxation
2026-07-19 programmer2 M6: replace legacy programmer with the new pipeline; drop minifb; add property tests
    [builder.rs, ir.rs, lib.rs, mod.rs, passes.rs]
2026-07-19 fix all compile warnings and clippy lints in cpu_v2
    [builder.rs, passes.rs, regalloc.rs]
2026-07-19 rcc frontend: Rust-subset spec, syn-based parser/lowering, fn pointers, dsl_rt host runtime, sample programs
2026-07-19 rcc tests: categorized integration tests (basics/control/calls/memory/errors); fix frontend bugs (short-circuit, for-continue, inclusive range wrap, strict coercion, return checks, fn ptr sig)
    [builder.rs, lib.rs, mod.rs]
2026-07-19 instruction line side-table (builder line_hint through regalloc), fix zip truncation dropping prepended init instructions
    [builder.rs, ir.rs, mod.rs, passes.rs, regalloc.rs]
2026-07-19 rcc-dbg: jump/call arrows in disassembly (SVG overlay), call stack with call-site source lines, fix missing esc()
    [mod.rs]
2026-07-20 rcc: report source locations in compiler errors
    [mod.rs]
2026-07-23 Scaffold cpu_v2 emulation framework
2026-07-23 Share component emulation framework
2026-07-30 Clean up clippy warnings on nightly-2026-07-29
    Mechanical fixes only, no behavior change:
    - annotate transmute types in cpu_v1 isa/gamepad
    - unwrap_or_default, elided lifetime '_> syntax in assembler
    - array map with dropped result -> into_iter().for_each in mem
    - redundant closures, identity op in cpu_v1
    - repeat().take(n) -> repeat_n, chunks_exact -> as_chunks in cpu_v2
    - allow(dead_code) for test-only VerilogModuleExporter
    cargo clippy --workspace --all-targets is now warning-free;
    all 233 workspace tests pass.
    [mod.rs, regalloc.rs, verilog_module.rs]
2026-08-12 Track handwritten hardware resources per instance
2026-08-16 Add streaming SPI flash reader component
2026-08-16 Model staged G16 boot loading
2026-08-16 Enable rcc device register intrinsics
2026-08-16 Define G16 boot DMA handoff ABI
2026-08-17 Add streaming G16 boot DMA hardware
2026-08-18 Document UART capture workflow and complete DDHT test ID table
    - Add hardware/scripts/capture_uart.ps1: record raw bytes from the Tang
    Nano 20K debug UART into a capture file (the checker previously assumed
    an undocumented external serial receiver).
    - scripts/README.md: capture usage, 115200 baud note (divider 233 at
    27 MHz, 468 at 54 MHz), full test ID table (add 0x01 bsram, 0x06 boot
    DMA), and the sdram_word_port private SDWP exception.
    - boot_dma self-test: move from test ID 0x05 to 0x06 so its capture can
    no longer be mistaken for the G16 boot test.
    - hardware/README.md: bsram section now names the capture script.
    - SDRAM.md: record the confirmed 0x05 board capture for g16_sdra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
2026-08-19 Remove CRC32 from the G16 boot flow and add the system control device
    Boot image format v3: the descriptor, manifest header, and section record
    CRC fields become reserved-zero, g16-pack stops computing them, and the
    boot DMA engine drops its CRC32 hardware, the verify/expected/actual
    ports, MMIO channels 10-13, and error code 6.
    Stage0 now reads the boot descriptor the way hardware must: a DMA copy
    into the fixed scratch words at 0x0000_0040 (reserved by the packer like
    the Stage1 handoff range), validation from SDRAM, then the Stage1 DMA
    and the descriptor mirror to the handoff address.
    New device 0 (system control) occupies 0xff00..0xff0f: channel 0/1 pulse
    instruction/data cache invalid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
    [loader.rs, mod.rs, system_control.v, system_control_tb.v]
2026-08-20 Add G16 cache, MMIO bridge, and memory arbiter components
    G16DirectMappedCache is the split instruction/data cache of the first
    G16 processor: direct-mapped, write-through, 64 sets of 16-word lines,
    physical 22-bit word addresses. Cache data lives in one characterized
    1024x16 BSRAM leaf per cache; the 64 12-bit tags map through a new
    G16CacheTagRam SSRAM leaf to 12 RAM16 primitives (768 physical bits).
    Stores convert to one 32-bit masked SDRAM write and line refills use 16
    serialized word transactions, keeping one word-port contract with the
    CPU and DMA. The cache exposes invalidate_all and DMA snoop ports for
    the boot flow.
    G16MmioBridge decodes the fixed MMIO page 0x0000_ff00..0xffff into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
    [cache.rs, mod.rs, resources.rs]
2026-08-20 Rebuild the g16_sdram example from the reusable G16 components
    The board self-test now instantiates G16Core, two G16DirectMappedCache
    instances, G16MemoryArbiter, G16MmioBridge, the SDRAM word port, and
    the boot DMA register bank instead of carrying a private CPU, cache,
    and SDRAM sequencer. The compiler-produced program boots from the
    initialized BSRAM ROM below word 0x400, executes from the instruction
    cache, and exercises write-through plus line refill on the data cache.
    Cache invalidate/snoop and the DMA engine ports stay tied off until the
    system-control device and Stage0 land.
    SDRAM.md records the measured facts of this build: three BSRAM blocks,
    24 RAM16 tag primitives, one MULT18X18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
2026-08-20 Fix two latent iverilog testbench failures
    boot_dma_tb: drive start with non-blocking assignments so the DUT
    actually samples it, and hold each flash byte until the engine consumes
    it; the previous driver pushed a byte every clock while ready was high
    and lost a byte whenever the engine paused streaming for the memory
    write, deadlocking the simulation.
    sdram_word_port_tb: rename the root module to tb to match the -s tb
    elaboration and print the DIGITAL_DESIGN_PASS marker the framework
    checks for.
    Both testbenches had never actually run on a machine with Icarus
    installed.
2026-08-20 Add rcc segment intrinsics and the Stage0/Stage1 boot programs
    New G16-only rcc intrinsics mtsr_dseg(v) and jseg(cseg, target) lower to
    MTSR DSEG and JSEG, making the boot chain's segment switches writable in
    rcc instead of hand-assembled tails. The v2.6 backend rejects them.
    cpu_v2/src/dsl_progs gains the real boot programs, mirroring the host
    reference loaders: stage0_dsl (DMA descriptor from flash 0x100000 to the
    scratch words, validates, DMAs Stage1, mirrors the descriptor to the
    handoff address, invalidates both caches through device 0, MTSR+JSEG;
    590 words at code base 0), stage1_dsl (DMAs the manifest into a static
    buffer, loads every section but itself, invalidates, enters the
    appli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
2026-08-20 Add the g16_boot example: two-stage flash boot on Tang Nano 20K
    The harness wires the full boot machine: G16Core behind a BSRAM boot
    window (instruction words below 0x400), split direct-mapped caches, the
    memory arbiter, the MMIO bridge, the boot DMA engine with its SPI flash
    reader on the arbiter's DMA client port, and the system-control device
    driving the board LEDs and debug UART with cache-invalidate pulses wired
    to both caches. Reporting is entirely software-driven through device 0.
    The Stage0 boot ROM image and the flash package are baked const arrays
    kept in sync by recompile-and-repack tests. The iverilog harness
    preloads an SPI flash model with the packed image and an SDRAM model
    c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
2026-08-20 Add --program-flash to the Gowin example CLI
    Every Gowin example can now write a raw binary to the external SPI
    flash at the G16 package base 0x100000 (operation 32) without a build,
    with the range validated against the target's fitted flash capacity.
    Adds the g16_boot package manifest and records the CLI entry in
    FLASH_LAYOUT.md.
2026-08-21 Add sysctl and MMIO board characterization examples
    Three small probes that isolate the pieces the full boot machine needs:
    - sysctl_uart: an FSM drives the system-control device directly (no CPU)
    and repeats the DDHT 0x08 frame; LEDs mirror busy/state for visibility.
    Board-proven on Tang Nano 20K (782 clean frames).
    - g16_mmio: G16Core running a leaf diagnostic from BSRAM through the
    NAND-exported MMIO bridge to the system-control device, emitting DDHT
    0x09. Board-proven (633 clean frames); every non-MMIO data access
    faults at the bridge by construction.
    - flash_readback: reads the boot package magic at 0x100000 through the
    fitted flash reader and shows per-byte matches on the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
2026-08-21 Report the G16 boot result on the LEDs
    The demo application now lights 0b11_0000 through device 0 channel 2 once
    it starts; boot failures keep the {stage, category} patterns whose stage
    bits are 01 or 10, so the LED word alone distinguishes success, Stage0
    failure, and Stage1 failure without a working UART. The G16 spec records
    the success pattern; the oracle integration test and the g16_boot board
    simulation assert it.
    [main.rs]
2026-08-23 Make UART capture deadline robust
2026-08-24 Add stable Gowin board bring-up workflow
2026-08-24 Add reusable board reset and diagnostics
    [diagnostic_reporter.v, diagnostic_reporter_tb.v, lib.rs, main.rs, mod.rs, reset_controller.v, reset_controller_tb.v]
2026-08-24 Add staged board validation workflow
2026-08-24 Stabilize adjacent SDRAM halfword transfers
    [main.rs]
2026-08-24 feat(cpu-v3): select boot application from reset buttons
2026-08-24 feat(gowin): program complete power-on flash image
2026-08-25 docs(cpu-v3): align ISA v0.4 companion documents with the implementation
    Refresh the implementation-status tables (reusable v0.4 RTL core, passed
    cpu-v3-boot board validation), document the boot-select strap device,
    correct the Stage0 cache-invalidation and stack-pointer description,
    drop the unimplemented 0b11_0000 LED success code in favor of the
    UART-frame success rule, describe the three-client memory arbiter, and
    fix stale post-layering source-of-truth paths.
    [encoding.rs]
2026-08-26 migrate cpu-v3 crate to ISA v0.5
    B family is now 'B cond imm8' with six predicates on a transient pending
    test result (set only by CMPS/CMPU/CMPSI/CMPUI, consumed by a conditional
    branch, expired by any other retiring instruction, transparent to IMMHI12;
    a conditional branch with no pending test faults InvalidInstruction).
    Jumps move into B as cond 8/9 with the link register architecturally
    fixed to r14 (JALR requires link=14). Opcode C becomes single-word
    DEVRECV/DEVSEND for devices 0..7 x 16 channels. r15 leaves the reserved
    set; the backend fuses comparisons into CMP+branch pairs.
    RTL Verilog, systems, and documents are still v0.4.
    [encoding.rs, mod.rs, sim.rs]
2026-08-26 adapt cpu-v3 Tang Nano 20K system to ISA v0.5
    The host reference loader's cache-invalidation sequence now emits the
    single-word device instructions instead of r15-based MMIO stores, and
    the build-script package fingerprints are rebaselined for the v0.5
    encoding. Workspace tests, clippy, layering, and hygiene checks pass.
    RTL Verilog is still v0.4.
2026-08-26 document CPU V3 ISA revision 0.5
    isa.html and spec.md now describe the B-family pending-test branches with
    imm8 offsets, the B-embedded relative jumps with architecturally fixed
    r14 link, the C-family device instructions, the CMP-class writers of the
    transient pending test, the stale-branch fault, and the unreserved r15.
    The RTL row is marked as v0.5 migration in progress; the board validation
    record is explicitly attributed to the v0.4 baseline.
2026-08-26 migrate CpuV3 RTL core to ISA v0.5
    The core now keeps the transient pending test (valid bit + two-bit
    ordering), executes the B-family conditional predicates and embedded
    JREL/JALREL with fixed r14 link, faults stale conditional branches with
    InvalidInstruction, and implements the single-word C-family device
    instructions over the fixed MMIO page. The testbench is restructured
    into sixteen reset-isolated scenarios and passes under Icarus Verilog
    through verify_verilog_with_iverilog.
    [cpu_v3_core.v, cpu_v3_core_tb.v, mod.rs]
2026-08-26 rearrange the CpuV3 E family so the comparisons sit together
    SLT/SLTU keep 9/A, CMPS/CMPU take B/C, POPCNT moves to 0, and
    MFSR/MTSR/JSEG shift to D/E/F, filling all sixteen E slots. The unsigned
    immediate compare is spelled CMPUI to match CMPSI. Boot package
    fingerprints are rebaselined for the recoded Stage0. Full workspace
    tests, clippy, iverilog core/cache benches, layering, and hygiene all
    pass.
2026-08-26 Validate the CpuV3 v0.5 design on the Tang Nano 20K
    Fix the checked-in boot manifest section sizes for the v0.5 outputs
    (stage1 1456->1346, application 232->218, application-alt 198->188
    bytes) so the independent repack matches the generated package.
    Board evidence under target/board-validation/cpu-v3-boot: the Full
    profile wrote the v0.5 boot package to external Flash, programmed the
    audited SRAM bitstream, and captured 52 DDHT success frames for test
    0x07 with no failure or CV3B boot-error frames; the complete power-on
    Flash image passed the repack comparison and programmer verify; after
    a power cycle an Observe-mode capture recorded 50 success frames from
    the Flash cold boot.
2026-08-26 feat(cpu-v3): add SDRAM framebuffer HDMI display
2026-08-27 Fix CPU V3 display timing, pixel pipeline, and framebuffer layout
    - Synchronize the board reset into the pixel domain instead of using
    the 54 MHz domain reset synchronously in pixel-clock logic.
    - Name the PLL-derived 54 MHz clock with create_generated_clock so the
    SDRAM/pixel set_clock_groups constraint actually applies; the
    auto-derived clock name is not resolvable in SDC.
    - Align the pixel data path: the line buffer's two-cycle read latency
    needs a twice-delayed lane select, and pixel data plus all video
    strobes share one three-stage pipeline into the TMDS encoders.
    - Drive the SDRAM DQM byte mask to all-enabled during read commands;
    a stale halfword mask suppresses the corres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
    [main.rs]
2026-08-27 fix(cpu-v3): generate board test programs from RCC sources
    Compile the CPU, MMIO, and SDRAM board-test programs in the system build script and expose their exact words through OUT_DIR bindings. Remove stale hand-maintained instruction arrays so ISA changes cannot leave the Verilog harnesses executing old encodings.
    [main.rs]
2026-08-27 refactor(cpu-v3): replace MMIO with a device port
    [cpu_v3_core.v, cpu_v3_core_tb.v, device_abi.rs, devices.rs, encoding.rs, loader.rs]
2026-08-27 refactor(cpu-v3-display): restore contiguous framebuffer layout
2026-08-27 feat(cpu-v3-display): add vblank framebuffer swaps
    [lib.rs]
2026-08-27 refactor(cpu-v3): name device instruction channels
2026-08-28 cpu-v3: specify fix16 FPU ISA and math model
    [encoding.rs, fpu.rs, mod.rs, sim.rs]
2026-08-28 cpu-v3: implement fix16 FPU register and vector datapath
    [cpu_v3_core.v, cpu_v3_core_tb.v, mod.rs]
2026-08-28 cpu-v3: add fix16 ROM unary operations and slim the FPU datapath
    Add the ROM-backed reciprocal, reciprocal-sqrt, and sin/cos unary
    operations with a generated 1024-word lookup image shared by the
    architecture model and the RTL.
    Rework the FPU datapath for area: the sixteen four-lane F registers move
    from distributed flip-flops with per-register write muxes into one SDPB
    BSRAM block, every vector operation streams one word per cycle through a
    single lane ALU and a single serial write port, ROM normalization and
    scaling share one 17-bit variable round shifter, and the priority encoder
    runs once. Logic on the cpu_v3_cpu board test drops from 12007 to 4399
    LUTs (58% to 22% of the GW2AR-18) and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
    [cpu_v3_core.v, cpu_v3_core_tb.v, fpu.rs, main.rs, mod.rs]
2026-08-28 cpu-v3: pipeline fix16 FPU lanes
    [cpu_v3_core.v, cpu_v3_core_tb.v, mod.rs]
2026-08-28 cpu-v3: register FPR issue addresses and pipeline unary ROM stages
    FPR read addresses are now registered at FPU dispatch and each
    multi-cycle phase schedules the next lane address while consuming the
    current asynchronous data, removing the state mux in front of RAM16.
    RCP/RSQRT move the domain check behind a latched operand, register the
    normalized mantissa before index adjustment, and register the scaled
    result before the FPR write, adding two cycles (7 -> 9).
    The FPR leaf carries an explicit distributed_ram attribute so the
    registered issue addresses cannot remap it to BSRAM.
    [cpu_v3_core.v, cpu_v3_fpu_register_ram.v, mod.rs]
2026-08-28 cpu-v3: register unary magnitude before the shared variable shifter
    The domain-check phase now captures the absolute magnitude alongside the
    exponent, so the shared normalize/scale barrel shifter only ever reads
    registered inputs (the magnitude register or the ROM output register).
    This removes the last cross-phase combinational cone from the latched
    unary operand into the scale result without adding cycles.
    The display system meets a 64.75 MHz logic-clock constraint (was 61.0);
    65 MHz fails reproducibly with a single endpoint.
    [cpu_v3_core.v]
2026-08-28 cpu-v3: widen the FPR to 64-bit vectors with per-lane write enables
    The FPR reorganizes from 64 lane-addressed words to sixteen 64-bit
    vectors. Both asynchronous read ports now return a whole vec4, so
    data-movement instructions stop serializing lanes: FLOAD/FMOV commit one
    wide write at dispatch, FPACK4 reads two sources per cycle, FUNPACK4 and
    FTRANSPOSE4 snapshot then write one row per cycle, FSINCOS lands both ROM
    results in one write, and FIMPORT4 commits its assembled buffer directly.
    Reset clearing walks sixteen vectors instead of 64 words.
    The lane ALU, multiply pipeline, and ROM sequences keep their serial
    schedules; per-lane write enables preserve in-place aliasing. RAM16 usage
    is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
    [cpu_v3_core.v, cpu_v3_core_tb.v, cpu_v3_fpu_register_ram.v, cpu_v3_fpu_register_ram_tb.v, mod.rs]
2026-08-29 cpu-v3: remove dead cache coherence machinery and freeze the maintenance ABI
    Complete Stage 0 of the cache/fetch/DRAM roadmap: drop the unused
    per-line snoop/invalidate direction, expose semantic cache maintenance
    APIs, lower icache_invalidate_delayed_and_jump as one terminal IR
    operation into adjacent ICACHE_INVALIDATE_ALL_DELAYED + JSEG words,
    and update the boot stages, baselines, and roadmap accordingly.
2026-08-29 cpu-v3: add private 256-bit line refill buffers to both caches
    Complete Stage 1 of the cache/fetch/DRAM roadmap: a read miss now issues
    one aligned line request and the arbiter owns the SDRAM word port for the
    whole line, streaming eight ordered 32-bit beats into each cache's private
    flip-flop refill buffer and releasing the port after the final beat. The
    cache drains sixteen words into its BSRAM privately and commits tag/valid
    only after a complete error-free line, so an error or invalidate never
    exposes a partially installed line. Writes and the boot DMA stay
    single-word transactions; the SDRAM adapter still issues sixteen word
    reads per line until Stage 2. Also fix the stale stage1 manife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
    [cache.rs]
2026-08-29 cpu-v3: refill cache lines with one real 8-beat SDRAM burst
    Complete Stage 2 of the cache/fetch/DRAM roadmap: the arbiter forwards one
    aligned line request and the SDRAM adapter issues a single ACTIVE + READ
    burst of eight 32-bit beats with last/error semantics, streamed straight
    into the cache refill buffer. The arbiter drops the Stage 1 word-pairing
    sequencer and holds ownership from request accept until the last (or an
    error) beat is consumed. Word writes and word reads keep their held
    word-at-a-time shape. System testbench SDRAM models serve burst_length+1
    beats and reject word reads from the caches.
    [sdram.rs]
2026-08-29 cpu-v3: split cache data into even and odd BSRAM banks
    Complete Stage 3 of the cache/fetch/DRAM roadmap: each instruction and data cache now uses two independent 1024x16 BSRAM banks split by word parity. A buffered 32-bit refill beat writes both banks in one cycle, reducing private line drain from sixteen cycles to eight, while hit reads select the requested parity and write-through hits enable only one bank. The lower half of each bank holds the current direct-mapped way and the upper half is reserved for Stage 4. Split initialization contents by parity and group both physical banks into one strict two-BSRAM resource-audit leaf.
2026-08-29 cpu-v3: make both caches two-way set-associative
    Complete Stage 4 of the cache/fetch/DRAM roadmap: each instruction and
    data cache now has two 64-set ways with 16 words per line, doubling
    capacity to 4 KiB. Tags are read and compared from two parallel tag
    arrays before the selected way is read from both even/odd BSRAM banks,
    so a hit costs one extra registered cycle until Stage 5 pipelines it.
    Invalid ways are filled first; otherwise the per-set victim register
    selects the next replacement way and flips to the other way after a
    successful refill. Only the tag valid/victim registers grew while BSRAM
    use stayed at 6 blocks. Model, RTL, and Icarus tests cover invalid-way
    preference, determinist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
    [cache.rs, cpu_v3_cache_tag_ram.v, cpu_v3_cache_tag_ram_tb.v]
2026-08-29 cpu-v3: merge the CPU V3 systems into a single full system
    Collapse the separate cpu_v3_cpu, cpu_v3_device, cpu_v3_sdram, and
    cpu_v3_display harnesses into one system. The surviving top module now
    carries the two-stage flash boot (Stage0/Stage1/application), system
    control, boot DMA engine, SPI flash reader, SDRAM word port, and the
    shared display/HDMI datapath (DisplaySdramPort + FramebufferHdmi) on a
    new TangNano20K::boot_hdmi_memory_project superset binding that owns
    Flash, SDRAM, and the 720p HDMI port with two PLLs. The CPU/SDRAM
    self-tests and the flash/DMA bring-up probes are removed; board-health
    remains the FPGA-alive check, and the boot-select still chooses among the
    flashed applic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
    [main.rs]
2026-08-30 cpu-v3: pipeline two-way cache hits with interleaved banks
    Begin Stage 5 of the cache/fetch/DRAM roadmap: reorganize each instruction and data cache as bank = way XOR word parity so the two 1024x16 SDPBs return both candidate ways in one synchronous read. Launch the bank reads on the request-acceptance edge and select the matching way in ST_CHECK, removing the Stage 4-only ST_HIT_READ cycle so a resident read responds one cycle after acceptance. Refill drains still write both halfwords per cycle, while write-through hits enable only the selected bank.
    Consecutive lookup issue and the instruction fetch queue remain for the rest of Stage 5. Bounded model/RTL/Icarus tests cover both way/parity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
    [cache.rs]
2026-08-31 scripts: summarize cargo output to bounded files and concise reports
    Add scripts/run-cargo.ps1, which tees raw cargo output to a per-label log
    under target/cargo-summaries and prints only a compact summary (exit code,
    warning/error counts, per-test pass/fail totals and failure list, or a
    bounded tail for run). Route validate-hardware.ps1 and
    run_board_validation.ps1 through it so large build/test/clippy/PnR logs no
    longer flood the caller.
2026-08-31 cpu-v3: expand emulator statistics and record Stage 10 benchmarks
    Split the ambiguous D-cache line counter into load/store refills, runtime
    write-backs, and final clean write-backs, and add a true retired-instruction
    count with CPI, I-cache demand requests and refills, and a prefetch on/off
    comparison. Shorten the multi-frame workloads to 30/30/10 frames and replace
    loose checks with exact terminal-state or full-array validation. Record the
    Stage 10 results in benchmarks/benchmark-results.csv and reduce the report to
    its resource/timing half. Also annotate the roadmap Stage 6/7 boundary with
    commit hashes.
    [benchmark-results.csv]
2026-09-01 cpu-v3: add folder-driven Stage 0 benchmarks
2026-09-01 cpu-v3: record comparable Stage 7 through 10 results
    [stage10.csv, stage7.csv, stage8.csv, stage9.csv]
2026-09-01 cpu-v3: record Stage 11 benchmark results
    [stage11.csv]
2026-09-01 cpu-v3: document Stage 11 async store and stop tracking benchmark results
    [stage10.csv, stage11.csv, stage7.csv, stage8.csv, stage9.csv]
2026-09-01 cpu-v3: co-simulate the core emulator against its RTL
    Run one cycle-accurate program through the Rust emulator and Icarus RTL with identical memory semantics, comparing deterministic architectural and handshake outputs every cycle. Cover Stage 12 overlap and forwarding, SETP, redirects, asynchronous stores, an FPU barrier, and HALT.
    Make halt_signal architectural by latching r0 at the HALT retire edge in both models, and compare it throughout the co-simulation. Document this core co-simulation as a mandatory regression for future pipeline, forwarding, retirement, and data-path stages.
    Validated by the full CPU V3 Icarus/co-sim suite, workspace tests, strict clippy, hardware iverilog and qu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
2026-09-01 cpu-v3: implement Stage 12 overlapped integer execution
    Add the conservative two-stage Stage 12 frontend, GPR forwarding, profiler accounting, benchmark coverage, and the 64-bit SDRAM model fix needed by the flash-boot Icarus testbench.
    Record the Stage 12 design, 13-program benchmark results, validation, and final PnR evidence in the relocated system optimization roadmap. The suite improves by a 22.6% geometric mean, and the full system closes the 54 MHz CPU clock at 56.230 MHz with zero setup and hold TNS.
    [cpu_v3_core.v, cpu_v3_core_tb.v, cpu_v3_fetch_pipeline_probe.v, cpu_v3_fetch_pipeline_probe_tb.v, mod.rs]
2026-09-02 docs: consolidate CPU V3 documentation into crate docs/ and update to Stage 12
    Move CPU V3 long-form documentation into per-crate docs/ directories
    matching ownership boundaries:
    - ip/cpu-v3/docs: ISA 0.7 specification (isa.md/isa.html), Stage 12
    hardware microarchitecture, and the structure diagram source.
    - systems/cpu-v3-tang-nano-20k/docs: new current-state system
    architecture document, optimization history, boot image format, and
    flash layout.
    Content corrections:
    - hardware-architecture.md now describes the Stage 12 conservative
    two-stage frontend, GPR forwarding mux, one-entry asynchronous store,
    parity-DPB caches with direct 4x64-bit line transfer, and the current
    56.2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
    [mod.rs]
2026-09-02 rcc: compile fix16/vec2/vec3/vec4 to the CPU V3 FPU
    Add compiler FPU support on the revised ISA (mask FACCSTORE, FACCLOAD.*,
    no FMULS). Every fix16/vecN value occupies exactly one F register.
    - Frontend: new Ty variants; operators +, -, * (component-wise, plus
    vecN*fix16 in either order lowered to the FACCLOAD.X + FACCSTORE 0b1111
    splat + FMUL idiom), unary -, and fix16 comparisons through FCMP and the
    pending test. Intrinsics: fix16::from_bits/from_int, zero(), vecN::new,
    vec4::import/export, lane access (.x() free, others through an aligned
    frame scratch), to_bits/to_int, the component-wise unary methods, fdot,
    and frcp/frsqrt/fsincos. if-expression and let-bound SSA variables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
    [builder.rs, ir.rs, mod.rs, passes.rs, regalloc.rs]
2026-09-02 bench: frozen CPU V3 benchmark suite; rcc: integer multiply
    Benchmark suite (systems/cpu-v3-tang-nano-20k/benchmarks/suite/):
    - 22 rcc-source programs with metadata headers (bench-tier, bench-max-cycles,
    bench-expected-halt): classic short algorithms (fizzbuzz, insertion sort,
    substring match, vec+heap), medium (dijkstra, sieve, binary search,
    matrix multiply), long (quicksort, streaming-mix), frame programs
    (sprite-batch, tile-world, and particles rewritten as fix16 FPU physics),
    and FPU programs compiled with the new compiler support (horner, sincos,
    splat, mandelbrot, normalize-batch, bezier, transform4x4, plus short
    interleave/spill stress programs). Every program halts wit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
2026-09-03 bench: repeatable cross-Stage benchmark execution and CSV output
    - New cpu-v3-bench-images tool compiles the frozen suite with the current
    compiler into hex word images carrying the bench-* metadata (max-cycles
    scaled x4 as a hang guard for slower historical stages).
    - benchmarks/run-commit.ps1 runs one ref: HEAD from source, or a
    stageN-bench tag in a temporary worktree whose own harness executes the
    shared images. Robust against interrupted-run leftovers and git's stderr
    progress under strict PowerShell error handling.
    - benchmarks/run-history.ps1 orchestrates stage0-12-bench plus HEAD and
    merges per-ref CSVs into target/bench-history/combined.csv.
    - export-results.ps1 gains a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
2026-09-03 docs: optimization history notes the completed Stage 8-12 rerun
2026-09-03 cpu-v3: add the disassembler (decoder + mnemonic listing)
    New ip/cpu-v3/src/architecture/decode.rs: decode() maps every revision 0.7
    word to a typed Instruction with mnemonic text; disassemble_words() walks a
    word stream and merges each IMMHI12 prefix with an eligible consumer into
    one wide operation (lone prefixes render on their own line). Signed
    immediates and offsets render signed.
    The backend .lst listing now shows 'addr: words mnemonic' per function
    instead of bare hex, so compiled output and failure analysis are readable
    directly.
    [decode.rs, mod.rs]
2026-09-03 cpu-v3: emit .dbg debug info from the backend
    CpuV3Program now carries a DebugInfo built in link(): per-word line records
    from the allocated IR's block lines (via the Line::Label markers), function
    address ranges and frame sizes, and Param/Frame locations lowered with the
    v3 ABI (args r2-r7, callee-save area first). The rcc CLI writes the .dbg
    file for --target cpu-v3 like it does for cpu-v2. Wide (prefixed) operations
    record both words.
2026-09-04 cpu-v3: rename DisplaySdramPort to SharedSdramPort
    The shared SDRAM adapter below the arbiter is no longer just a display
    port: it schedules refresh, display-urgent, and CPU-side traffic for all
    masters (I-cache, D-cache, DMA, and future GPU). Rename the module and
    all identifiers to SharedSdramPort, update the verilog identity and
    instance, and refresh the doc references. File locations are unchanged;
    the move out of the display/ directory is deferred to the GPU landing.
    [main.rs, mod.rs, sdram.rs]
2026-09-04 cpu-v3: fix word-write data path through the 108/54 SDRAM gearbox
    Word writes through the shared SDRAM port never asserted
    controller_write_data_valid (only line writes reached ST_WRITE_STAGE), so
    the 108/54 gearbox write_buffer was never filled and the controller
    sampled a stale I_sdrc_data. The boot DMA's Stage0-to-Stage1 SDRAM loads
    are word writes and were the first victim on physical hardware; all three
    simulators masked the fault by committing word writes directly.
    SharedSdramPort now routes word writes through the full four-beat
    ST_WRITE_STAGE, holding the half-word (already placed for the DQM lane) on
    controller_write_data while controller_write_data_valid pulses all four
    beats befo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
    [mod.rs]
2026-09-04 cpu-v3: make the cache-maintenance hold CPU-local
    Rename cache_maintenance_hold to cpu_hold in the system-control device and
    document that it deliberately gates only the CPU core. While D-cache
    clean/invalidate runs, DMA, the display, the SDRAM adapter, and the
    system-control peripheral itself keep running; a wiring test locks the
    signal to declare/sysctl-drive/core-consume in self_test.v.
2026-09-04 cpu-v3: rewrite the board display demo with FPU waveform and circle
    The physical-board demo now redraws an RGB565 back buffer with animated
    sine/cosine waveforms and a parametric circle through fsincos, fix16
    scaling, FROUND, and the FPU-to-integer bridge before normal cached stores
    write the pixels. Each completed buffer is D-cache-cleaned and the clean
    status checked before the swap is published, because the display reads
    SDRAM directly. The build script compiles the real demo image instead of a
    placeholder, the host display simulator attaches the system-control device
    so dcache_clean_all works there, and boot.rs decodes the compiled demo to
    lock the required FPU operations and the clean-b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
2026-09-05 cpu-v3: add framebuffer demo to flash boot selection
2026-09-05 cpu-v3: optimize framebuffer demo and map it to S2
2026-09-11 Migrate CPU V3 integer ISA to revision 0.8 encoding layer
    Step 1 of the ISA 0.8 integer rework: new major-opcode map
    (shift/multiply family at 2, extended/compare/system at 6, device at 7,
    scalar immediates at A, branch/conditional-move/jump at B, C/E illegal,
    IMMHI12 renamed to PFX12), SIGNAL replaces HALT, canonical zero fields,
    closed PFX12 consumer set with exhaustive 64K-word test, and matching
    isa.md/isa.html updates with 0.8 revision history. Simulator receives
    minimal decoding adaptations (SIGNAL event interface deferred to step 2);
    gate-level RTL is unchanged, so dependent emulator tests stay ignored
    until step 3.
    [decode.rs, encoding.rs, mod.rs, sim.rs]
2026-09-11 Add ISA 0.8 SIGNAL event interface to simulators and cycle model
    Step 2 of the ISA 0.8 integer rework: CpuV3Sim exposes nonzero SIGNAL
    retirements as StepOutcome::Signaled(SignalEvent) while run() ignores
    them; the Rust cycle model records a single-cycle model-only signal
    event with read/take accessors and no RTL I/O change. Adds model-side
    coverage for shift-amount masking, destructive rd==rs read-modify-
    write, multiply windows, unsigned MULI immediates, conditional-move
    pending consumption, and r14 link/return via JALR/JREG.
    [mod.rs, sim.rs]
2026-09-11 Migrate CPU V3 RTL and gate-level model to ISA 0.8
    Step 3 of the ISA 0.8 integer rework: cpu_v3_core.v decode moves to
    the new major-opcode map with destructive shift/multiply execution
    (zero-extended DSP inputs, indexed part-select over the full 32-bit
    unsigned product, single MULT18X18, unchanged state count), SIGNAL
    halt latching rs / nonzero-types as NOPs, the 0.8 PFX12 consumer set,
    canonical-field legality, and illegal C/E majors. The Rust gate-level
    core mirrors the RTL cycle-for-cycle; system-emu redirect recognition
    and the core testbench move to the new encodings. Restores the 14
    emulator/fpu/probe tests ignored in step 1; core and system emu/RTL
    co-simulations and validate-hardwar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
    [cpu_v3_core.v, cpu_v3_core_tb.v, cpu_v3_fetch_pipeline_probe.v, encoding.rs, mod.rs]
2026-09-11 Add RCC coverage for the ISA 0.8 integer instructions
    Step 4 of the ISA 0.8 integer rework. The shared RCC IR gains immediate operands, register-count shift amounts, unsigned multiply windows, SIGNAL, MFSR, and the Boolean/conditional-move forms, with one shared use/def visitor replacing the duplicated match arms in the optimizer and allocator.
    CpuV3 lowering selects short or PFX12 immediates (literals and named constants, swapping commutative operands), keeps destructive sources live through register affinity, lowers Boolean materialization and conditional moves from simple diamonds, and relaxes branch/jump/call widths to the signed 8-bit form. CpuV2 legalizes the same IR (immediate materi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
    [builder.rs, ir.rs, main.rs, mod.rs, passes.rs]
2026-09-11 Extend CpuV3 if-conversion to single-instruction arms
    A diamond arm may now be one pure, non-faulting value instruction (arithmetic, multiply, shift, or unary), so patterns like c3 = if c3 == 0 { 2 } else { c3 - 1 } become a compare plus a conditional move instead of a branch. The arm instruction is hoisted into the branch block; SSA guarantees its operands are available there, and Log2 is excluded because its lowering branches.
    Fix CSE copy propagation for vregs with multiple definitions: aliasing a Mov destination that is redefined later (by the conditional move) replaced the uses after the conditional write and dropped it. This also corrects the pre-existing register-typed false arm, whi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
    [mod.rs, passes.rs]
2026-09-11 Finalize ISA 0.8 boot assets, toolchain, and documentation
    Step 5 of the ISA 0.8 integer rework: re-verifies the Stage0 FNV-1a
    baseline against independently materialized boot assets (Stage0 = 461
    words < 1024; repack byte-for-byte clean), bumps every ISA version
    reference to revision 0.8 (README, cpu-v3 docs, hardware architecture
    latency tables with PFX12 naming, system architecture doc), records
    the migration in the optimization history without a new Stage number,
    syncs the rcc language spec with the new instructions and intrinsics,
    and corrects the stale rcc_std/mul.rs module comment. The frozen
    benchmark suite is untouched.
2026-09-11 Merge CpuV3 boot into a single first stage
    Replace the two-stage flash boot with one BSRAM first stage that validates
    the fixed descriptor, DMAs and validates the section manifest, and loads the
    reset-selected application. Delete rcc/stage1.rs and the Stage1 descriptor
    fields (container format version 4), collapse the reference loader to a
    single run_boot, report every failure with stage 1, and reduce the
    boot-progress phases to BOOT/DMA/APPLICATION. Bound the manifest section
    count so the 16-bit "count << 5" size check cannot wrap, and make the board
    power up in the S2 display application. Boot assets regenerate from the same
    RCC sources; the merged Stage0 is 673 words and the package still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
    [device_abi.rs, loader.rs, main.rs, manifest.rs, mod.rs]
2026-09-11 Fix CpuV3 RTL ASR/ASRI signedness
    A signed arithmetic shift nested in a conditional whose other branches were
    unsigned was evaluated as a logical shift: Verilog makes a conditional
    expression unsigned when any branch is unsigned, so `>>>` lost its sign
    extension. ASR and ASRI therefore returned 0x00xx for negative values, and
    fix16::to_int() (FSTORE plus ASRI 8) turned the display demo's negative
    sine/cosine offsets into +255 instead of -1, which misplaced every negative
    coordinate on the board. Compute the shift result in a statement-based case
    and have the FSM select it. Add a fix16_to_int_rcc emulator-vs-RTL
    co-simulation covering the negative and positive conversions, and document
    the pi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
    [cpu_v3_core.v]
2026-09-12 Amend ISA 0.8: unsigned ADDI/SUBI u4, add LDC/ADDC constant-table ops
    ADDI/SUBI read the unprefixed immediate as an unsigned u4 (0..15);
    downward adjustments are SUBI's job. The rcc backend flips negative
    immediates to the opposite operation, keeping generated code identical
    in shape. A-family functions 7/B become LDC/ADDC, sharing a symmetric
    16-entry table (+/-8,16,24,32,64,128,256,512) for struct sizes and
    pointer strides; they never consume PFX12. Still revision 0.8.
    Verified: cargo test on both crates, clippy clean, core emu/RTL and
    system co-simulations pass with the new ops exercised, frozen stage-12
    suite re-run (target/isa0.8-ldc-stage12-results.csv); Stage0 boot-bytes
    baseline re-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
    [cpu_v3_core.v, cpu_v3_core_tb.v, decode.rs, encoding.rs, mod.rs, sim.rs]
2026-09-12 Remove the instruction next-line prefetch entirely
    Measured cost/benefit: ~1.5% Logic and ~4.6% registers for +0.0003%
    frozen-suite benefit (12 useful prefetches across all 22 stage-12
    programs; demand hit rates already exceed 99%). The one-entry
    cancel learning made it harmless, not useful.
    Deletes the offset-10 fetch-queue trigger, the prefetch
    request/arm/cancel and cancelled-line learning in the I-cache engine,
    the way_*_prefetched arrays, the simulation counters, and the
    prefetch_enabled switch in the system emulator. RTL and Rust cycle
    models stay bit-exact; frozen-suite CSV schema keeps the four prefetch
    columns pinned to zero (documented in benchmarks/README.md).
    Verified: 210 test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
2026-09-12 Move CpuV3 cache valid/victim bits to RAM16 SSRAM
    Both caches keep their two valid arrays and the victim bits in a
    CpuV3CacheValidRam leaf with asynchronous reads and a synchronous single-way
    write port. A RAM cannot clear in one cycle, so a global invalidate, reset, or
    memory-error scrub clears one set of both ways per cycle. The D-cache exposes
    valid_sweep and the system holds the core for the reset and scrub sweeps
    (sysctl_cpu_hold || valid_sweep) so the core never sees a not-ready cache on
    its first post-reset access. The two-way hit expression drops its own
    invalidating gate, restoring the tight I-cache way-valid path depth that the
    old instant clear did not pay.
    Verified with the full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
    [cache.rs, cpu_v3_cache_valid_ram_tb.v, cpu_v3_data_cache.v, cpu_v3_data_cache_tb.v, cpu_v3_two_way_cache.v, mod.rs]
2026-09-12 Report the S2 display status over UART
    The display application now emits the DDHT success frame (test ID 0x0b) once
    at startup and once per published frame, so the default S2 boot validates over
    UART without holding the S1 button. The board-validation UART checker accepts a
    list of test IDs, the cpu-v3-system profile accepts 0x0b and 0x07, and the
    Icarus boot testbench waits for the display frame as well.
    Verified on hardware (cpu_v3_system Full: 618 valid 0x0b frames, no failures)
    and offline (workspace tests, Icarus boot, clippy, layering, hygiene).
2026-09-12 Scan D-cache dirty lines in 16-entry windows with write-back overlap
    Maintenance clean/invalidate previously used a 128-bit priority encoder to
    find the next dirty line. Replace it with one 16-entry window per cycle: the
    scan runs ahead of the in-flight write-back, latches one next candidate, and
    resumes after it once the write-back completes. The architecture DataCache
    picks lines in the same way-major order so the RTL and the Rust wrapper stay
    bit-exact, and the reset/error scrub keeps using the same sweep.
    Verified with the full workspace tests, both mandatory co-simulations, the
    Icarus boot gate, the frozen benchmark suite (total cycles unchanged; final
    flush differs by at most three cy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
    [cache.rs, cpu_v3_data_cache.v, cpu_v3_data_cache_tb.v]
2026-09-12 Widen the CPU V3 framebuffer to 400x240
    The logical framebuffer is now 400x240 RGB565, so the 2x-scaled 800x480 HDMI
    mode fills the active window with no side border (the 3x 1280x720 mode leaves
    40-pixel borders). The scanout line buffer grows to three 200-word slots across
    two 18-Kbit BSRAMs with 10-bit addresses, and the slot-base select keeps the
    address math off a synthesized DSP multiplier. The display demo re-centers on
    x=200, uses 8/256 radians per pixel, and moves framebuffer B to 0x217800.
    Verified on hardware (800x480 full screen, 618 DDHT 0x0b frames) and offline
    (workspace tests, clippy, layering, hygiene, display Icarus testbenches, system
    co-sim, Icarus boot). Gowin PnR: 8,354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
2026-09-12 Add a BL616 reset recovery path to the UART capture tools
    The onboard BL616 can be left in a stuck UART route after an interrupted
    capture, so the host reads zero bytes even while the DUT transmits. Add a
    -ResetBl616 switch to capture_bl616_uart.ps1 and run_board_validation.ps1 that
    reboots the bridge MCU through its console before capturing; the VCP drops and
    re-enumerates, clearing the route while leaving the FPGA untouched.
    run_board_validation.ps1 passes the switch through and records reset_bl616 in
    evidence.json, and the scripts README documents the recovery.
    Verified on hardware: a stuck route recovered and captured 618 DDHT 0x0b
    frames.
2026-09-12 Collapse the CPU V3 scanout line buffer to two slots
    Two 400-pixel lines are 12800 bits and fit one 18-Kbit BSRAM, where the three-slot buffer needed two. At two slots the producer only requests the bus once the consumer has freed a slot, when exactly one line is buffered, so the display is arbiter-urgent for every request and never round-robins with the CPU; one line of lead covers refresh plus the one in-flight transaction. The host model's 0-underflow blackout ceiling drops from ~9900 to ~6400 cycles, so the line-buffer test pins 6000.
    Verified offline (workspace tests, clippy, layering, hygiene, display Icarus testbenches, system co-sim). Gowin PnR: 8,361 LUT, 4,088 FF, 5 DPB + 1 SDPB +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
2026-09-12 Fix CPU V3 cache valid-array RAM16 inference
    The valid/victim leaf only ever inferred RAM16 for the victim bit; both 64-bit valid ways stayed as 128 flip-flops plus their read multiplexers in every instance. Two independent write-port dependencies caused it. The D-cache selected the victim write way combinationally from the array's own asynchronous read data in ST_LOOKUP, and the I-cache gated its valid write enable on the shared memory_request_ready handshake input.
    Both caches now clear the victim from the registered pending_way as the line request starts, which still precedes the first refill data beat, so no array write depends on that array's read data and the behaviour is unchanged. T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
    [cache.rs, cpu_v3_data_cache.v, cpu_v3_two_way_cache.v]
2026-09-13 Record CPU V3 PnR and benchmark ledgers from one script each
    scripts/log-post-commit-build.ps1 now splits the PnR Logic total across the ten
    major components, reading the synthesis hierarchy report (component Logic = its
    whole subtree's LUT + ALU + 6 x SSRAM unit, the rule resource-analysis.md already
    uses), archives the reports the row was read from under the project's
    records/resources/, and takes -BuildDir so probe builds can be recorded too.
    The new scripts/log-post-commit-benchmark.ps1 runs the frozen suite, archives the
    raw per-program CSV under records/performance/, and appends one aggregate row to
    the project performance ledger, carrying a frozen-suite fingerprint and a
    metric-set f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
2026-09-13 Machine-check the documentation rules
    Add scripts/check-docs.ps1 (current-state line budget, one home per fitted
    number, .agent index and front matter agreement) and run it from the baseline
    checks; move the fitted numbers into the system architecture document, fix the
    .agent/projects/ paths, and rename the PnR logger.
    Non-functional: no RTL, model, compiler, or build input changed.
2026-09-13 Aggregate benchmark runs by geomean, never cross-program sums
    Suite sums are dominated by the long/frame programs and hid real
    regressions (the RAM16 cache move read as -0.05% by sum but +1.5%
    by equal-weight geomean). Ledger columns become per-program geomeans;
    counters that may be zero use geomean(value+1).
2026-09-13 Add a resolved-target BTC to the CPU V3 fetch
    Four-entry, two-word fully associative BTC with exact LRU (eight-entry
    build-time comparison, CPU_V3_BTC_ENTRIES=0/4/8). Geomean suite cycles
    -9.01% over disabled; both capacities fit 54 MHz with zero TNS but
    narrow (0.066/0.077 ns) slack. Full co-sim, scoreboard and PnR evidence
    in the optimization doc; no new Stage.
    [cpu_v3_instruction_fetch_queue.v, cpu_v3_instruction_fetch_queue_tb.v, mod.rs]
2026-09-13 Support `/` and `%` through a software divide
    Neither ISA divides, so both operators lower to `rcc_std::div` (the `mul_16x16`
    precedent). A power-of-two divisor becomes a shift or mask, and any other
    constant whose magic is verified over every numerator becomes one `MUL16` plus a
    shift. `x / 0 == 0` and `x % 0 == x` are defined on both host and target.
2026-09-13 Store bool as a 0/1 word
    A comparison used as a value materializes through the ISA's Boolean-producing
    forms, `!` flips the low bit, and a compound condition becomes a diamond the
    conversion pass folds back. A stored bool is a condition again and passes,
    returns and casts with `b as u16`; it never mixes with integers.
    [builder.rs, ir.rs, mod.rs]
2026-09-13 Return aggregates through a hidden pointer
    An aggregate return uses sret: the caller passes the destination as the first
    argument, so `let p: Point = make(1u16);` fills p's own frame slot. Tuples join
    structs and buffers as memory-resident aggregates with positional fields and
    `let (a, b) = ...` destructuring.
2026-09-13 Reject Array<bool> and pin the element whitelists
    The view whitelist had picked up `bool` when P4 widened it for structs while the
    owned `Buf<T, N>` list kept P2's rule. Both are u16/i16/struct again, and a test
    now asserts that the two lists accept the same element types.
2026-09-13 Honour loop labels and add `*=`
    `break 'outer` used to be parsed and then silently ignored, jumping to the
    innermost loop instead. The loop stack now carries each loop's label and an
    unknown label is an error. `*=` lowers to the same MUL/MULI path as `*`.
    [builder.rs, mod.rs]
2026-09-13 Add C-style enums
    A fieldless enum is one word holding the variant's discriminant, so `Trace::Run`
    works anywhere a u16 does: bindings, arguments, returns, struct fields and
    `Buf<Trace, N>` elements. `e as u16` reinterprets, and `==`/`!=` compare two
    values of the same enum when it derives PartialEq (exactly Rust's rule, which
    keeps the source buildable on the host).
    `match` is the next phase; until then `if e == Trace::Idle { .. }` works.
    [mod.rs]
2026-09-13 Lower match to a branch chain
    `match` is a statement whose patterns are integer literals, enum variants and
    `_`; bindings, guards, ranges, `|` and nested patterns are errors. The value is
    evaluated once and the arms become a chain of `Br`s (the IR has no jump-table
    terminator).
    Exhaustiveness follows Rust, because the same source has to build on the host: an
    enum match must list every variant or carry `_`, and an integer match needs `_`.
    [mod.rs]
2026-09-14 Fix RCC aggregate and boolean semantics
    [builder.rs, mod.rs]
2026-09-18 Add FPU v2 Stage 1 leaves: mirrored-BSRAM register file and two-word instruction front-end
    CpuV3FpuV2RegisterRam: two mirrored 512x32 arrays inferred as SDPB blocks,
    one broadcast write port and two independent synchronous read ports with
    read-first collision semantics. Physical addresses 0..63 alias F0..F63
    (parent forces the top bits); 64..511 form the hidden LUT region.
    CpuV3FpuV2Frontend: assembles the 32-bit FPU instruction from two 16-bit
    words and forms the RF read addresses combinationally in the word0 cycle
    (including the AUX Fa field remap), so operand reads start before word1
    is decoded. Word1 field splitting is left to the downstream controller.
    Both leaves carry directed-plus-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
    [cpu_v3_fpu_v2_frontend.v, cpu_v3_fpu_v2_frontend_tb.v, cpu_v3_fpu_v2_register_ram.v, cpu_v3_fpu_v2_register_ram_tb.v, mod.rs]
2026-09-18 Add FPU v2 Stage 2: combinational scalar ALU and scalar execution path
    CpuV3FpuV2ScalarAlu: pure combinational Q16.16 scalar ALU (ADD/SUB/MIN/
    MAX/ABS/NEG/FLOOR/CEIL/ROUND/TRUNC/CMP/MOV), fabric LUT arithmetic only
    (syn_dspstyle="logic"), wrap overflow, round-half-up rounding.
    CpuV3FpuV2ScalarPath: fixed-latency controller on top of the two-word
    front-end and the mirrored-BSRAM register file. T0 (instr_complete,
    opcode 0xD) evaluates the ALU on already-valid RF read data; T1 writes
    back; CMP updates the LT/EQ/GT flag registers instead of writing; abort
    suppresses any in-flight writeback. First implementation of the
    section-16 R/W/X countdown skeleton.
    The path testbench wires frontend + re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
    [cpu_v3_fpu_v2_scalar_alu.v, cpu_v3_fpu_v2_scalar_alu_tb.v, cpu_v3_fpu_v2_scalar_path.v, cpu_v3_fpu_v2_scalar_path_tb.v, mod.rs]
2026-09-18 Remove the fix16 FPU from CpuV3Core
    The ISA-0.8 fix16 vector FPU (opcode 0xD) is deleted wholesale ahead of
    the FPU v2 integration: all ST_FPU_* states, the fix16 helper functions,
    the FPU register file / DSP multiplier / FPU ROM instances, the Fpu* emu
    phases, and the FPU test programs in the system co-sim. Opcode 0xD now
    faults as an invalid instruction, like the reserved majors C and E.
    The scalar core is unchanged; both mandatory co-simulations pass
    (cpu-v3 emu/rtl: 15 tests; system level: 1 test). The CpuV3FpuRegisterRam
    leaf files remain on disk, unregistered, until the FPU v2 integration
    settles. CpuV3Sim (architecture/) still models the old FPU for the frozen
    benchmark suite; it con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
    [cache.rs, cpu_v3_core.v, cpu_v3_core_tb.v, mod.rs]
2026-09-18 Add FPU v2 unit top level (I1-a)
    CpuV3FpuV2 wraps the front-end, the mirrored-BSRAM register file and the
    scalar path into the core-facing unit: two-word instruction stream in,
    busy/flags/complete out, plus the ext_* channel through which the core
    implements FLD/FST while the unit is idle (Stage 6 replaces this with the
    internal store buffer).
    The top captures the front-end read addresses for one beat so the
    synchronous RF still presents word0 operands at the scalar path's T0.
    Rust-side compositional emu mirrors all three leaves plus the hold
    register; the unit testbench drives instruction streams and the ext
    channel end to end (7549 checks).
    [cpu_v3_fpu_v2.v, cpu_v3_fpu_v2_tb.v, mod.rs]
2026-09-18 Integrate FPU v2 into CpuV3Core (I1): scalar ops + FLD/FST
    Majors C/D/E now dispatch to the FPU v2 unit: word0 is streamed to the
    unit at Execute, word1 is fetched through the instruction port
    (ST_FPU2_WORD1), scalar ops retire after the unit's fixed T0/T1 window,
    and AUX kind-00 FLD/FST run two 16-bit beats through the data port
    (ST_FPU2_MEM_REQUEST/RESPONSE) with the unit's ext channel moving the
    32-bit halves. FPU memory beats wait for the async store buffer and use
    the port only while it is idle, so arbitrary memory latency is tolerated
    (core TB scenario 45 runs the data port with a delayed response).
    The Rust cycle model mirrors the new states, including the FPU unit via
    the value-leve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
    [cpu_v3_core.v, cpu_v3_core_tb.v, cpu_v3_fpu_v2_scalar_path_tb.v, mod.rs]
2026-09-18 Add FPU v2 vector path (Stage 3): lane-sequential vector ALU ops
    CpuV3FpuV2VectorPath sequences lanes at one per cycle through the shared
    combinational scalar ALU (VADD/VSUB/VMIN/VMAX/VABS/VNEG/VMOV, vec2/3/4).
    The unit top muxes the RF read ports to the vector path for its busy
    window and ORs its write port with the scalar path; the core needed no
    changes (opcode C already streams to the unit and waits on busy).
    Also adds a core-level emu/RTL co-sim for FPU v2 memory beats, the
    system-level handwritten fpu_v2_vector_add program (FLD x4, VADD.2, FST
    x2), and a wider context dump on system co-sim trace mismatch.
    Note: longer store-chain programs currently trip a pre-existing,
    FPU-unrelated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
2026-09-19 Add FPU v2 multiply path (Stage 4): MUL/VMUL/VMULS
    CpuV3FpuV2MultiplyPath runs one lane per cycle through an inferred 36x36
    signed multiplier (three register stages, II=1, narrowing product[47:16]
    at the write port), covering scalar MUL and vector VMUL/VMULS. The unit
    top muxes the RF ports across the scalar/vector/multiply paths by busy
    window.
    The Rust mirror of the multiply pipeline needed the pre-edge treatment
    twice: snapshot instr_complete before the front-end update, capture the
    stage-1 write address before the counter increment, and evaluate the
    pipeline stages in reverse order so each reads its predecessor's pre-edge
    value. All three were pinned with evidence from temporary cycle p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
    [cpu_v3_fpu_v2.v, cpu_v3_fpu_v2_multiply_path.v, cpu_v3_fpu_v2_multiply_path_tb.v, main.rs, mod.rs]
2026-09-19 Add FPU v2 dot path (Stage 5): DOT/DOTADD/DOTSTORE with wide ACC
    The dot path runs per-lane products through the shared multiplier pipeline
    shape (3 stages, II=1) and accumulates the full signed 72-bit products
    into a 64-bit Q32.32 ACC; only DOTSTORE narrows (ACC[47:16]) and leaves
    ACC clean. B stride 1/3/4 via the mode field.
    Integration notes:
    - The vector path now fires only on its implemented subops; before this
    filter it also ran on DOT/DOTSTORE and clobbered their operands with
    ALU zeros mid-dot (caught by a wrapper-level RF write probe).
    - The emu mirror of the dot pipeline follows the by-now-standard
    discipline (pre-edge snapshots, reverse-order stage transfer); one more
    ins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
    [cpu_v3_fpu_v2.v, cpu_v3_fpu_v2_dot_path.v, cpu_v3_fpu_v2_dot_path_tb.v, main.rs, mod.rs]
2026-09-19 Share one 36x36 multiply pipe between the FPU v2 multiply and dot paths
    The core serializes FPU instructions, so both paths drive a single
    CpuV3FpuV2MulPipe (II=1, latency 3, tag FIFO) instead of owning a
    multiplier each. Also closes two dirty-but-correct leftovers: the scalar
    path no longer fires on MUL (its T1 zero write was overwritten by the
    product anyway), and the vector path now starts only on its own subops.
    Emu mirror: another instance of the NBA class — the accumulate/RF-write
    guards and the pipe tags must read pre-edge values (outstanding counts,
    waddr/lane), not the values after this tick's updates. Removes the
    temporary FPU debug probe that wrote a trace file every tick.
    [cpu_v3_fpu_v2.v, cpu_v3_fpu_v2_dot_path.v, cpu_v3_fpu_v2_dot_path_tb.v, cpu_v3_fpu_v2_mul_pipe.v, cpu_v3_fpu_v2_mul_pipe_tb.v, cpu_v3_fpu_v2_multiply_path.v, cpu_v3_fpu_v2_multiply_path_tb.v, cpu_v3_fpu_v2_scalar_path.v]
2026-09-19 Fix emu async-store drain ordering; add store-chain drift regression co-sim
    The emulator drained the completed async store buffer before executing the
    cycle's phase logic, so a store retiring on the buffer's completion edge saw
    valid == false and enqueued immediately. The RTL reads the nonblocking
    async_store_valid, parks the store in AsyncStoreWait for one beat, and the
    traces drifted one cycle apart from there (found via a 3-store nop-separated
    single-line repro; the separator and the third store are both required).
    The drain now happens after the phase match, mirroring the RTL edge. Adds
    the reduced reproducer as a permanent system co-sim regression test.
    [mod.rs]
2026-09-19 Add FPU v2 vector load/store (Stage 6a): FLDV2/3/4 and FSTV2/3/4
    The AUX subops 0x00/0x01 with mode[1:0] != 00 are the vector forms
    (len = mode[1:0] + 1, stride 1, contiguous F registers); reserved
    mode[3:2] is defined to behave as the scalar form. The core's two-beat
    FLD/FST sequencer widens to 2*len beats with the F register index taken
    from beat>>1; the FPU unit is unchanged (its ext port already takes a
    9-bit address). Blocking style, like scalar FLD/FST — the store buffer
    and early release are a separate step. New system co-sim program
    fpu_v2_vector_ldst moves 1.0..4.0 through FLDV4/FSTV3/FLDV2/FSTV2.
2026-09-19 Add FPU v2 store buffer with early release (Stage 6b)
    FST(V) now captures its source registers through the FPU ext read port
    (one per beat, pipelined around the synchronous RF) into four core
    registers and retires immediately; the 2*len words drain through the
    existing async store channel while the core keeps executing. Ordering:
    the refill claims the channel on the first edge, so CPU memory ops
    always detour through AsyncStoreWait (which now also waits for the
    pending count), FPU memory ops wait for the drain, and halted waits for
    both. New co-sim programs: fpu_v2_store_overlap (~25 cycles of the
    drain hidden behind unrelated work) and fpu_v2_store_drain_hazard
    (CPU load/store ordering agai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
2026-09-19 Add FPU special-function LUT reference model (Stage 7a)
    Single source of truth for the RCP/RSQRT/SINCOS hidden-LUT contents and
    the integer datapath algorithms (design section 9.4): 128-entry RCP and
    RSQRT seeds with 9-bit linear interpolation, a 129-entry sine table, one
    Newton-Raphson step for RSQRT, and Q2.30 range reduction for SINCOS.
    Host sweeps against f64: RCP 1.38 ulp, RSQRT 1.19 ulp, SINCOS 4 LSB
    over the full Q16.16 range. The emulator mirror and the Verilog init
    include will both be generated from this module.
2026-09-19 Revise FPU special functions: asymmetric LUT mirrors, no Newton or pipe use
    The hidden BSRAM region is read-only, so the two SDPB mirrors carry
    different tables (896 words effective): mirror A holds RCP 128 + SINCOS
    257, mirror B holds RSQRT 256. The finer RSQRT table replaces the
    Newton step (1.90 ulp), and SINCOS range reduction uses a two-term
    2/pi constant decomposed into 16x16-class products with the input
    clamped to +/-64 rad (3 LSB at |a| <= 45). The special path is now
    fully self-contained; the shared mul pipe is untouched.
    [lut.rs]
2026-09-19 Make SINCOS correct over the full Q16.16 range; drop the clamp
    Out-of-range inputs must still produce sin/cos of the actual angle. The
    two-term 2/pi constant turns out to kill the range-dependent error
    entirely (residual < 0.16 LSB of t at any |a|, t fits i32 everywhere),
    so the clamp was both wrong semantics and unnecessary: measured max
    error is 3 LSB over the whole i32 range (2^26 random samples), asserted
    at 4. Every partial product stays 17x17-class.
    [lut.rs]
2026-09-19 Pin SINCOS inner-range (|a| <= 2pi) accuracy at 3 LSB measured
2026-09-19 Initialize the FPU hidden LUT region from the reference model (Stage 7b-1)
    The RF leaf's two mirrors now carry their tables as BSRAM init data
    (mirror_0: RCP@64..191 + SINCOS@192..448, mirror_1: RSQRT@64..319) in a
    generated LUT_INIT region. The fpu_lut_codegen example rewrites the
    region in place from fpu::lut (now public), and a sync test asserts the
    .v never drifts from the model. RF testbench checks the mirror
    asymmetry. Gowin still maps exactly two SDPB; no fabric cost.
    [cpu_v3_fpu_register_ram.v, cpu_v3_fpu_register_ram_tb.v, lut.rs, mod.rs]
2026-09-19 Add FPU special path (Stage 7b): RCP and RSQRT from the hidden LUTs
    Blocking special-function path leaf (scalar slot subops 0x0C/0x0D; 0x0E
    SINCOS is a defined no-op until its datapath lands): CLZ-tree normalize,
    table lookup in the asymmetric mirror init data, 9-bit linear
    interpolation through one inferred 18x18, barrel-shift rescale. RSQRT
    uses twin even/odd tables over [1,2) — the first [1,4) single-table form
    needed a 64-bit constant divide for the index, which failed timing at
    42.8 MHz and cost ~1400 Logic; the twin form needs no divide (1.47 ulp).
    Leaf TB with an independent reference (71760 checks), emu mirror with
    per-mirror RF contents, system cosim fpu_special_rcp_rsqrt. TIMING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
    [cpu_v3_fpu.v, cpu_v3_fpu_scalar_path.v, cpu_v3_fpu_scalar_path_tb.v, cpu_v3_fpu_special_path.v, cpu_v3_fpu_special_path_tb.v, lut.rs, mod.rs]
2026-09-21 Add the emulator-side fetch-pause sync point
    The pause lives in the modelled system-control device (channel 6) and holds the
    fetch queue off the core; the RTL is untouched, as requested. It has to be
    evaluated before the combinational settle and the two core handshake wires must be
    re-driven from the queue every cycle, otherwise one extra instruction retires and
    the core wedges.
    The harness compares externally visible state against CpuV3Sim at several sync
    points (GPRs, all 64 F registers, the accumulator, PC, segments, memory), with
    snapshot/restore for prefix reuse. Whole fetch_pause suite is 10 tests, about
    0.2s release. Only Clone derives and read-only accessors were added to the model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
2026-09-21 Improve RCC allocation and segmented memory layout
    Use segregated free lists and in-place realloc for the RCC heap, and give Tang applications separate 128 KiB code/data windows.
    Re-freeze short-vec-heap after fixing its early-OOM false success.
    [mod.rs, project.rs]
2026-09-22 Add GPU memory-interface bring-up
    Integrate the seven-owner arbiter, tile-linear scanout, device-4 submit path, dummy tile writer, and double-buffered RCC demo. Fixed-line 32-byte traffic is intentional; variable bursts and the real frontend remain later milestones.
    [device_abi.rs, lib.rs, main.rs, mod.rs, sdram.rs]
2026-09-22 Add variable GPU memory bursts
    Support 32-128 byte GPU transactions with a single streaming 108/54 MHz gearbox. The current dummy renderer remains fixed-line; board-level Controller HS burst behavior still needs physical validation.
    [mod.rs, sdram.rs]
2026-09-22 Add device watch-change waits
2026-09-22 Add blocking GPU tile framebuffer cache
2026-09-23 Add GPU transaction trace differential
    Rust model and RTL testbench now emit the same transaction-level
    trace (REQ/RDAT/WDAT/RESP/DONE per scene); an ignored cosim test
    compares them per port and reports first divergence with context.
    Test infrastructure only: no bitstream, resource, or cycle impact.
2026-09-23 Add GPU rasterizer functional reference sim
    Independent geometric oracle (clip -> rcp divide -> viewport snap ->
    setup -> reference rasterizer) for the coming rasterizer emu and RTL.
    Fixed-point infrastructure with a 256-entry LUT+lerp rcp (7 ppm),
    guard band sized for a 32-bit datapath, reverse-Z contract, and
    measured precision/performance experiments. Sim-only: no bitstream,
    resource, or cycle impact.
    [mod.rs]
2026-09-24 Type rasterizer sim arithmetic as hardware devices
    Fixed-point formats are generic Fx instances; arithmetic goes through
    device types (wrap-counting adders, range-recording multipliers,
    counting saturators, LUT+lerp rcp). A contract module holds the
    precision tolerances against the exact test-only oracles. New
    edge-case tests cover clipped-fan watertightness, shared edges at
    assorted slopes, and huge triangles at the camera. Sim-only: no
    bitstream, resource, or cycle impact.
    [devices.rs, mod.rs]
2026-09-24 Add rasterizer component emulator; apply precision revision
    Cycle-level component emu (clip/setup/tile/quad FSMs, FIFOs, K-prefetch,
    merger pin, shared-device arbitration), bit-exact with the functional
    sim on all scenes. Applies the reviewed precision revision: near >= 1/8
    with explicit rejection, 41-bit iterative divider for clip
    intersections, snap clamped only to the s12.4 format range, truthful
    E40 scale. Sim-only: no bitstream, resource, or cycle impact.
    [devices.rs, mod.rs]
2026-09-25 Add viewport raster RTL and differential co-simulation
    Keep the clip path as an unfitted geometry probe; the default viewport leaf is standalone and has no cache integration yet. Its GW2AR-18C synthesis probe uses 3,871 Logic, 1 BSRAM, and 4 DSP.
2026-09-25 Integrate viewport rasterizer with system GPU
    Drive an inline triangle from the S2 program through the tile cache and add an independent RGB565 image differential. Full-system PnR closes 54 MHz; the existing S1 Flash Icarus phase still fails.
    [main.rs, mod.rs]
2026-09-26 Reduce GPU raster and framebuffer control logic
    Measure tile and scanline quad producers at two rates while preserving geometry and cache contracts. Capture CPU B operands on acceptance and stage AABB setup without changing retirement cycles.
2026-09-26 Record optimized GPU Flash and UART validation
2026-09-27 Upgrade display buffering and add sRGB scanout
    Write response beats directly into two BSRAM banks and snapshot format on swap.
    Retain the separate pixel-pair FIFO based on whole-system resource comparisons.
    [device_abi.rs, main.rs, mod.rs]
2026-09-27 Add accepted eight-DPB framebuffer component
    Keep the production GPU export unchanged; cache and shader integration remain pending.
    Validate component PnR, independent vendor tests, and CPU/system co-simulations.
2026-09-27 Reduce framebuffer LUTs with bank-order execution
    Keep full RGBA source ownership and word-level memory concurrency at two clocks per quad. Matched standalone PnR saves 112 LUTs; production GPU integration remains pending.
2026-09-27 Reduce system Logic with BSRAM tags and source-held writeback
    Keep writeback data in locked cache RAM and consume every beat only on ready. Offline validation and routed fit pass at 54 MHz; no board validation.
2026-09-28 Integrate native SDRAM controller into CPU V3 system
    Use 128-byte bank interleave through the 54/108 MHz two-pair bridge. Full offline validation and system PnR pass; integrated board UART validation remains pending.
2026-09-28 Prototype shared-DSP meshlet geometry RTL
    Standalone experiment; functional-sim differential and complete-system fit remain open.
2026-09-29 Retire legacy GPU implementation
    Keep the system device and memory wiring inert while GPU v2 develops in the standalone cmodel. Historical source is preserved in the local oldcode archive. Compile checks passed; RTL, emu, and system tests were intentionally not run.
2026-09-29 Prototype 96-bit compact vertex stream
    Explore 32-bit cell packing over a synchronous 64-bit scratchpad read and direct Q1.11 normals. The format remains provisional and is not wired into the current meshlet microcode. All 57 standalone cmodel tests and strict lint pass.
2026-10-01 Preserve GPU MVP and storage model foundations
    Extract reusable fixed-width vertex arithmetic, v6 stream reads, MVP trials, and clocked storage ports from the retired clip/setup study. Validated 26 scoped release tests; no production GPU or RTL changes.
    [lib.rs]
2026-10-01 Add audited fixed-point computation framework
    Seal runtime value construction and route arithmetic and typed memory access through an auditable resource ledger. Preserve the existing clocked small triangle driver; numerical-only mode and full setup remain future work. Validated 19 release unit tests, 13 compile-fail tests, and both driver routes.
    [lib.rs, mod.rs]
2026-10-01 Add Rust lighting models and bounded scheduling experiments
    [lighting-formats.csv, power-segments.csv]
2026-10-01 Optimize lighting bindings and verify periodic II=2 schedules
    [lighting-formats.csv]
2026-10-01 Add audited Rust command, scratchpad and vertex stages
2026-10-02 Add cycle SDRAM emulation and board traffic probe
    Qualify the unchained 54/108 MHz baseline with GPU pin co-simulation and standalone Gowin PnR. Physical board measurements and chained transport remain pending.
2026-10-02 Add structural wiring and equality lowering certificates
2026-10-02 Add opt-in SDRAM lookahead and four-sector groups
    Keep production serial. Deliver independent cycle, oracle and pin validation with bounded active-display load checks; production scanout, cold-start and candidate board qualification remain open.
2026-10-02 Move Gowin device references to shared vendor documentation
2026-10-02 Add closed counted texture sampler
    [texture-formats.csv]
2026-10-02 Add bounded timed texture cache and filter model
2026-10-02 Add closed texture stages and bounded context release experiments
    [texture-formats.csv]
2026-10-02 Bind universal texture stages to cycle memory
2026-10-02 Implement bounded framebuffer ROP with lane forwarding
2026-10-02 Add bounded setup scaling binding study
    [lib.rs, main.rs]
2026-10-03 Connect persistent pixel branches through a shared SDRAM fixture
    [branches.rs, mod.rs]
2026-10-05 Optimize lighting storage and add compensated-floor profiles
    [lighting-formats.csv]
2026-10-06 Implement audited ROP and framebuffer cache emulation and RTL
2026-10-06 Align rendering precision and helper-lane sampling contracts
    [lighting-formats.csv, texture-formats.csv]
2026-10-06 Retime Fast lighting for 60 MHz and preserve floor quantization
    Remove Compact resource profiles and consolidate the current Lighting contract.
    Keep view-length weighting opt-in; the selected floor RTL remains bit-identical.
    Qualify the isolated module at 66 MHz; retain full II2 and diffuse II1.
    [lighting-formats.csv]
2026-10-06 Select Q13 RSQRT storage for the free II2 lighting calendar
    Pair six normalization read channels into three native TDP ROMs, saving three BSRAMs at unchanged 38-edge latency. Include the reviewed unified calendars and offline board qualification; existing GPU backend defaults remain unchanged.
    [lighting-formats.csv]
2026-10-07 Adopt prepared power masks and freeze the selected lighting core
2026-10-07 Reduce the shared FPU multiplier pipeline to two stages
2026-10-09 Pin SINCOS timing and cancellation to the two-stage FPU
2026-10-11 Integrate the optimized Group48 post-quad pipeline
    Squash the reviewed Sampling and post-quad successors, including direct H9 and Lighting B. Native and portable complete exports match the qualified RTL; scoped model and RTL replays pass. Geometry and physical board integration remain separate.
2026-10-11 Add independent command and vertex execution kernels
    Retain the typed command payload boundary and select the 102-edge Vertex DO-loan leaf alongside its exact reference. Command live co-simulation and both 51,372-edge Vertex RTL replays pass. DMA, source/result storage and connected frontend execution remain external.
2026-10-18 Store BTC instruction pairs in a spare-slot RAM
2026-10-18 Pipeline VLIW framebuffer access and prefetch tiles
2026-10-18 Pipeline VLIW raster preparation and Lighting reads
    Keep Vertex and numerical precision unchanged. The selected matched GPU fit uses 12175 Logic and meets 54 MHz; box/full948-bunny totals are 135808/294706 cycles. Preserve only current sources, bounded regressions and compact qualification evidence.
2026-10-18 Clean up GPU test and probe lint warnings
2026-10-19 Verify boot and SPI Flash transaction boundaries
2026-10-19 Pipeline GPU raster preparation and improve framebuffer locality
2026-10-19 Implement CB06 boot and gate Display startup
    Validate COPY/ZERO loading and optional 27MHz single-line SPI offline. Bitstreams are diagnostic candidates; strict SDRAM/bridge timing still fails and no board access was performed.
2026-10-19 Pipeline GPU geometry preparation and compact raster control
    Interleave bounds products, prepare step tables by level, and publish tile metadata on the first scheduled word. Preserve Vertex and numeric results.
    Standalone GPU: 11964 Logic, 36 BSRAM, 20 DSP macros at 55.075 MHz. Box and two-meshlet bunny remain at 116044 and 62371 cycles; full 948-face and board qualification were not repeated.
2026-10-21 Expand Triangle result queue to sixteen slots
    Reuse the result banks and distributed descriptor RAM; retain Vertex arithmetic and precision. Native/portable queue regressions and matched scene outputs pass; scoped fit and performance receipts are in target/gpu-t16/summary.json.
2026-10-21 Invalidate framebuffer tags and rearm completed flushes
2026-10-22 Fix CPU cache maintenance ordering and simplify drain control
    Drain older stores and FST tails before retained ready/done maintenance; reject reserved cache controls.
    Verified CPU/system co-simulation and 14 coupled cases. Matched fit uses 6899 Logic at a 54 MHz CPU target; global STA remains failing.
2026-10-23 Integrate GPU command execution and cold-start initialization
    Connect Device4 and streaming SDRAM transfers while preserving boot and Display contracts.
    Include complete-system export, native resource claims and cold-start regression coverage.
2026-10-23 Add fixed-grid UI drawing through shared GPU memory paths
    Reuse scratchpad, DMA and framebuffer banks without extra BSRAM or DSP. Verify native bitmap text and icons over two frames, unchanged 3D smoke output, and full-chip 54/108 MHz timing.
2026-10-23 Add RCC GPU driver with scoped memory and ordered Pass recording
    Keep one opaque high-memory CB with immutable assets, snapshots and bounded staging.
    Verify real CPU/cache/Device4/GPU drawing and maintenance-failure ownership; Display handoff is separate.
2026-10-23 Add millisecond wall clock and previous-frame timing helpers
2026-10-23 Add Display ownership and confirmed presentation to the RCC GPU driver
2026-10-23 Add static GPU demo assets and shared frame overlay helpers
2026-10-23 Restore classic full scene and unpadded frame time
2026-10-24 Add button-controlled timing overlay
    Expose synchronized board buttons on Device0 RECV8 and debounce the overlay toggle. Reuse matching audited/programmed RTL and the confirmed physical toggle; component tests pass.
2026-10-24 Restore linear RGB565 display conversion in the demo
    Track current and requested scanout encodings across the actual Display swap. Preserve raw initialization compatibility; reuse the verified linear-output firmware and format-control tests.
2026-10-24 Record GPU commands and objects directly in final arenas
    Batch meshlet commands and reuse validated directories while preserving capacity checks and one final cache handoff. Reuse matching native-prefix, boundary and fail-stop evidence; physical memory errors require whole-system reset.
2026-10-24 Add bounded GPU preparation and pipeline experiments
    Separate profiling, retained-template and two-slot diagnostics from production recording. Preserve bounded execution, source/input identity checks and the accepted fail-stop policy; keep experiments out of the default demo path.
2026-10-24 Add stateless UI ranges and continuous tile transfers
    Reuse existing command and framebuffer storage; preserve RCC full-grid interfaces. GPU/stream MC and system co-simulation pass; full-system stream binding and STA remain pending.
2026-10-24 Separate UI binding from range drawing in the RCC driver
2026-10-24 Reduce UART and Flash control logic
2026-10-24 Skip framebuffer initialization during cold boot
2026-10-24 Add bounded native frame continuation profiling
2026-10-24 Add a bounded microsecond timer and decimal frame times
    Read and explicitly clear a 16-bit interval through Device0, keeping millisecond deadlines independent. Validate CPU/device timing, saturation and tenths-of-ms glyphs with bounded component simulations; defer physical qualification to the combined peripheral build.
2026-10-24 Add Device5 DualShock 2 input and standalone board test
2026-10-24 Add calibrated stick vectors and a circular input diagnostic
2026-10-24 Cache framebuffer context line masks
2026-10-24 Receive DS2 input autonomously through two-page snapshots
    Replace the packet Device5 ABI and driver with coherent latest-only input.
    The local controlled fit saves53 Logic; full-board routing remains unqualified.
2026-10-24 Drive the classic GPU scene from DS2 first-person controls
    Keep the original scene basis, materials and linear RGB565 output.
    Measure preparation through GPU drain before present; DDGD v3 excludes vblank.
2026-10-24 Align autonomous DS2 samples with Display frames
2026-10-24 Expose failed DS2 wire headers in the UI diagnostic
2026-10-25 Consume unshifted F16 positions in the shared triangle calendar
    Remove retired meshlet-scale storage and control without changing Vertex or
    adding BSRAM/DSP. Board qualification remains a half-frequency diagnostic.
2026-10-25 Retiming FPU execution around a single product stage
2026-10-25 Drive UART idle directly from the held stop bit
2026-10-26 Stabilize SDRAM read capture and registered returns
    Keep read events off the 64-bit payload enable and align cold-profile DQ inputs.
    Validated at 54/108 MHz CL3 with zero timing violations, two 32-frame sampled checks, and 17,122 consecutive demo reports.
    The extracted CE network reproduces stale bits; HDMI visual and power-cycle acceptance remain pending.
2026-10-26 Add resource renderer and minimal frame application
2026-10-26 Support sequential renderer passes with changing frame callers
2026-10-26 Exercise resource renderer with Bloxorz-shaped game frames
2026-10-27 Align prepared cameras with the native view basis
2026-10-27 Add reusable GPU profiler and board replay follow-up plan
2026-10-27 Capture prepared GPU inputs and replay the production memory path
    Add checked UART snapshots, a software lease gate and cold GPU/MC profiling. Full box/RGB/rabbit color and depth match the resumed board; physical button qualification remains separate.
2026-10-27 Add column-major framebuffer and texture layout profile
    Introduce the opt-in pure layout profile and its bounded validation tools. The exported GPU and complete board sources match the offline-qualified candidate; matching scene firmware and physical validation remain separate acceptance gates.
2026-10-28 Stabilize SDRAM bridge payloads across related clock edges
    Stage payloads and pop before coincident consumption; preserve the native calendar.
    Reuse reviewed bounded regressions; physical evidence retains its original raw-source identity.
    (cherry picked from commit bec39ec85b8ca287bce5e8bab194a06e90e60fab)
2026-10-28 Check chained reads in the GPU replay initialization guard
